IasonKa/drain/drainstop/paper/generated/tab_pump.tex

\begin{tabular}{@{}l r r r r@{}}
\toprule
source capacity & \multicolumn{2}{c}{largest open area that still drains fully (mm$^2$)} & \multicolumn{2}{c}{Eq.~\eqref{eq:cap-area} (mm$^2$)} \\
\cmidrule(lr){2-3}\cmidrule(l){4-5}
 & $\alpha=+10^\circ$ & $\alpha=+15^\circ$ & $+10^\circ$ & $+15^\circ$ \\
\midrule
2 L/min & 5 & 3 & 3 & 2 \\
5 L/min & 9 & 9 & 7 & 6 \\
10 L/min & 19 & 16 & 14 & 11 \\
20 L/min & 42 & 35 & 27 & 23 \\
ideal regulator & 52 & 35 & -- & -- \\
\bottomrule
\end{tabular}
