IasonKa/drain/drainstop/paper/generated/tab_sensitivity.tex

\begin{tabular}{@{}l r r r r r r r r @{}}
\toprule
case & \multicolumn{2}{c}{Recommended} & \multicolumn{2}{c}{USZ as built} & \multicolumn{2}{c}{Side rows} & \multicolumn{2}{c}{Four rows} \\
\cmidrule(lr){2-3}\cmidrule(lr){4-5}\cmidrule(lr){6-7}\cmidrule(lr){8-9}
 & $0^\circ$ & $+10^\circ$ & $0^\circ$ & $+10^\circ$ & $0^\circ$ & $+10^\circ$ & $0^\circ$ & $+10^\circ$ \\
\midrule
baseline & 0.5 & 1.4 & 2.2 & 20.0 & 4.4 & 5.7 & 0.0 & 1.8 \\
capillary 60 deg & 0.5 & 1.4 & 0.0 & 11.8 & 4.4 & 5.7 & 0.0 & 1.8 \\
capillary 0 deg & 0.5 & 1.4 & 0.1 & 3.6 & 4.4 & 5.7 & 0.0 & 1.8 \\
drawdown 0.5 d & 1.0 & 1.9 & 2.2 & 20.0 & 4.9 & 6.2 & 0.5 & 2.3 \\
pump 2 L/min & 0.5 & 14.4 & 2.7 & 23.3 & 4.4 & 18.7 & 2.3 & 18.9 \\
pump 5 L/min & 0.5 & 9.7 & 2.7 & 23.1 & 4.4 & 14.1 & 0.2 & 14.2 \\
water & 0.5 & 1.4 & 2.2 & 19.7 & 4.4 & 5.7 & 0.0 & 1.8 \\
80\% glycerol & 0.5 & 1.4 & 2.2 & 20.1 & 4.4 & 5.7 & 0.0 & 1.8 \\
Cd holes x0.8 & 0.5 & 1.4 & 2.0 & 19.2 & 4.4 & 5.7 & 0.0 & 1.8 \\
Cd port 0.62 & 0.5 & 1.4 & 2.4 & 20.9 & 4.4 & 5.7 & 0.0 & 1.8 \\
-5 mmHg & 0.5 & 1.4 & 2.3 & 20.5 & 4.4 & 5.7 & 0.0 & 1.8 \\
-10 mmHg & 0.5 & 1.4 & 2.0 & 19.3 & 4.4 & 5.7 & 0.0 & 1.8 \\
on the floor & 0.5 & 1.4 & 2.2 & 19.9 & 4.4 & 5.7 & 4.4 & 6.2 \\
\bottomrule
\end{tabular}
