IasonKa/drain/drainstop/paper/drain_stop.pdf

# When does a suction drain stop draining?

Two-phase hydraulics of a partly submerged perforated drain at −7 mmHg,

### and a hole layout that keeps it draining

### USZ drain project, technical note

Analysis, simulations and text prepared with Claude Code (Anthropic)

### 3 November 2026

Abstract

A perforated drain of USZ size (elliptical body 17.85×9.67 mm, 119 mm long, closed tip, Ø4.24 mm outlet bore centred in the end face) lies in a pool of a glycerol–water mixture and is connected to a regulated suction of ps = −7 mmHg (−933 Pa). As the pool empties, some holes come out of the liquid and suck air. We derive when the drainage stops, test hole layouts and sizes, and confirm the results with two independent simulations.
The air entering the exposed holes and the outlet bore act as two orifices in series. They leave a vacuum |ps |/(1+Λ

2
)
inside the drain, where Λ is the exposed open area divided by the bore area, both weighted by their discharge coefficients. Liquid can leave only through the part of the bore below the inner liquid level, so draining stops when

ℎ +

Hv
1 + Λ² (ℎ)

= zℓ

, Hv =

|ps |

ρg

= 84.5 mm,

where ℎ is the pool level and zℓ

the height of the bore’s lower lip. A refined form accounts for air that must enter against the liquid column inside the drain. Across 1127 cases (11 layouts, 8 hole sizes from 0.5 to 4 mm, tilts from −10◦

to +20◦
),
the refined closed form matches a two-phase network simulation with a mean difference of 0.03 mm. A time-dependent simulation reproduces the same stop levels.
The main results are:
(i) The as-built USZ field (468 mm² open, Λ ≈ 24) stops at 2.2 mm when lying flat, but at 20.0 mm when the outlet end is 10◦ up and at 36.9 mm at 20◦
(ii) Hole size matters through the total open area and through how evenly the holes cover the length, not by itself. (iii) Two staggered rows at ±30◦
from the bottom, 36×Ø1.0 mm (28.3 mm² , twice the bore area), drain to the lowest hole edge, i.e. a residual level of 0.5–2.1 mm, from −10◦

to +20◦
, and pass 755 mL/min while submerged.
(iv) The intended source is a wall regulator. The recommendation holds as long as the regulator keeps −7 mmHg while passing 18 L/min of air (12 L/min if the tilt stays within 10◦
). A weaker source needs fewer holes; a sizing rule is given.

## 1 The question

The drain lies in a “lake” of liquid with a viscosity between that of water and glycerol. The suction keeps the outlet tube at −7 mmHg. Fluid enters through side holes and leaves through the outlet. The drain is not always level, and as the lake empties, part of the drain sits in air. Two questions follow:
1. For a given hole layout and hole size, at what pool level does the drain stop removing liquid?
2. Which uniform layout and hole size (0.5 to 4 mm) keeps it draining longest, so that it leaves the least liquid behind? “Stops” means that the liquid flow through the outlet falls below 0.1 mL/min. Section 3 derives the hydraulics and a closed-form stop condition. Section 4 describes the layouts tested. Section 5 describes the two simulations used to confirm the analysis, and Section 6 gives the results. The recommended design is in Section 7.

## 2 Geometry, fluid and operating point

We keep the body of the USZ drain from the project package (USZ_drain_package) and replace its hole field (Fig. 1, Table 1). The body is an elliptic cylinder lying flat, with outer semi-axes a = 8.925 mm (lateral) and b = 4.835 mm (vertical), length L = 119 mm from the closed tip (x = 0) to the outlet end face (x = L), and a 0.6 mm skin. The outlet bore (Ø4.24 mm, area Ap = 14.12 mm²
) is centred in the end face, roughly half its 9.67 mm height. The interior is modelled as one open lumen; the fluted inner wall and core of the as-built part are not modelled (Section 9).
A point on the skin is located by its axial position x and by the angle θ of the parametrisation y = a sin θ, z = b(1−cos θ), with θ = 0 the bottom line (6 o’clock), ±90◦

the side edges and 180◦
the top. Holes are drilled normal to the skin. The drain may be tilted by α about a horizontal lateral axis; α > 0 lifts the outlet end. The pool level ℎ is measured from the lowest point of the skin. The lower edge of the bore, the lip, then sits at
zℓ (α) = (b − r p) cos α + L max(sin α, 0), | zℓ (0) = 2.71 mm, | (1)

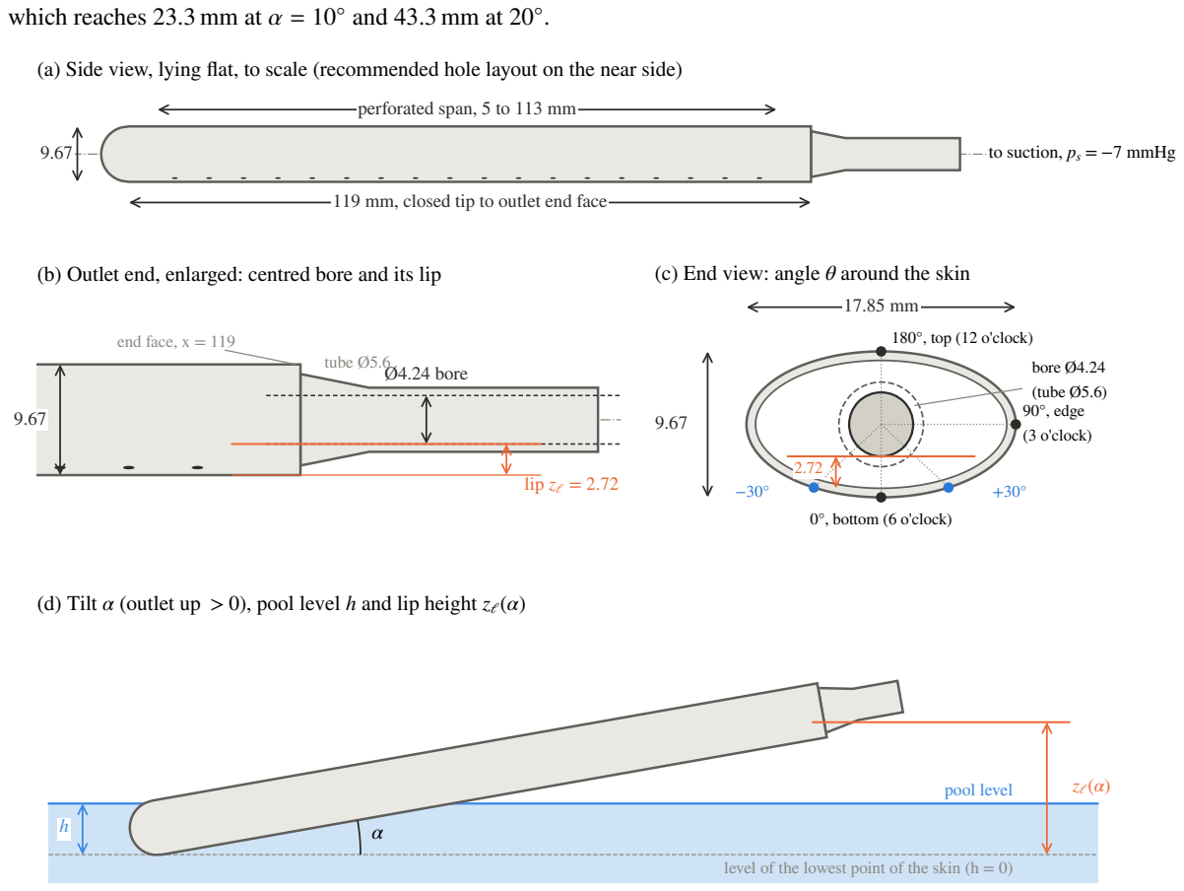
[picture p14: figure]
which reaches 23.3 mm at α = 10◦; and 43.3 mm at 20◦; 119 mm, closed tip to outlet end face; perforated span, 5 to 113 mm; to suction, ps = −7 mmHg; lip zℓ = 2.72; Ø4.24 bore; end face, x = 119; tube Ø5.6; 0°, bottom (6 o'clock); 90°, edge (3 o'clock); 180°, top (12 o'clock); bore Ø4.24 (tube Ø5.6); (c) End view: angle θ around the skin; pool level

### (a) Side view, lying flat, to scale (recommended hole layout on the near side)

### (b) Outlet end, enlarged: centred bore and its lip

level of the lowest point of the skin (h = 0)

### (d) Tilt α (outlet up > 0), pool level h and lip height zℓ(α)

Figure 1: Drain geometry (USZ body). (a) Side view to scale, showing the holes of the recommended layout on the near side. (b) Outlet end: the Ø4.24 mm bore is centred, so its lower lip is zℓ = 2.72 mm above the bottom of the skin. (c) End view and the angle θ that locates holes around the skin; the recommended rows sit at ±30◦
(blue). (d) Tilt α, pool level ℎ and lip height zℓ

(α), Eq. (1).

Table 1: Parameters of the reference case.

quantity | value | note
outer skin | 17.85 × 9.67 mm ellipse, L = 119 mm | USZ body, lying flat
skin thickness t | 0.6 mm | hole length
outlet bore | Ø4.24 mm, Ap = 14.12 mm²
| , centred | lip at zℓ = 2.71 mm
perforated span | x = 5 to 113 mm | as in the USZ part
liquid | 50 wt% glycerol–water, 20 ◦C | ρ = 1126 kg/m³
| | , μ = 6.0 mPa s [7],
| | γ = 0.068 N/m
air | 20 ◦C | ρa = 1.20 kg/m³ , μa = 1.81 × 10−5 Pa s
suction | ps = −7 mmHg = −933 Pa | regulated in the outlet tube
suction head | Hv = |ps |/ρg = 84.5 mm | Eq. (2)
discharge coefficients | hole Cℎ = 0.61 (d ≥ 0.8 mm) to 0.68 (d = 0.5 mm),
| bore Cp = 0.85 | Eqs. (4), (8)
pool footprint | 200 × 80 mm | only for drain times

## 3 Physics

All pressures are gauge pressures; the atmosphere is p = 0.

### 3.1 Suction head

At −7 mmHg the suction can hold up a liquid column of

Hv =

|ps |

ρg

=

933.3
1126 × 9.81
m = 84.5 mm. | (2)

This is about nine times the drain height. Gravity and capillarity are therefore not negligible next to the suction, and they decide when the drain stops.

### 3.2 Flow through one hole

A hole of diameter d through a wall of thickness t resists flow through a viscous term and an inertial term in series:

Δp = Rv q + K q|q|, | Rv = μ

(
24
d

3

+

128 t

πd⁴

)

, K =

ρ
2C

2
ℎ

A²

, A =

πd²
4
. | (3)

The first viscous part is Sampson’s creeping flow through a circular aperture in a thin plate [1]. The second is Hagen– Poiseuille flow along the bore. Their sum approximates the exact finite-length solution well [2]. The inertial part is the orifice law with discharge coefficient Cℎ, which depends on t/d [3]:

Cℎ = 0.61 (t/d ≤ 0.75), | Cℎ rising linearly to 0.81 (t/d ≥ 2). | (4)

For t = 0.6 mm this gives Cℎ = 0.61 for d ≥ 0.8 mm. Solving Eq. (3) for q gives the numerically stable form

q =

2 Δp

Rv +

√

R

2
v + 4KΔp
. | (5)

For the liquid at Δp ≈ 0.5 kPa and d = 1 mm the hole Reynolds number is about 100, and the viscous term lowers the flow by about 12 % relative to the pure orifice law; at d = 0.5 mm it lowers it by about 40 %. For air, μa/μ = 0.003 and the viscous term is negligible. A hole that is partly submerged is split by area into a submerged fraction fs and an exposed fraction fe, each treated as a hole of area f A (that is, Rv/ f and K/ f

2
).

### 3.3 Why an exposed hole leaks air

When the liquid surface drops below a hole, a meniscus forms in it. It can resist the suction behind it only up to the capillary entry pressure

Pc =

4γ cos θe
d

≤

4γ
d
, | (6)

where θe is the effective contact angle (with edge pinning the maximum is 4γ/d [5, 6]). The largest possible value is
544 Pa for d = 0.5 mm, 272 Pa for d = 1 mm and 68 Pa for d = 4 mm. All of these are below |ps | = 933 Pa. A hole seals
against the full suction only if
d < d∗ =

4γ
|ps |
= 0.29 mm, | (7)

even with perfect wetting. Every hole in the 0.5 to 4 mm range therefore lets air in as soon as it is exposed. Once air passes, the hole stays open until it is submerged again. Capillarity plays a role only after the vacuum inside the drain has already dropped, and it is treated as a sensitivity case (θe = 60◦
and 0

◦

; the baseline is θe = 90◦ , no holding).

### 3.4 The outlet bore

The flow contracts from the drain lumen (≈ 110 mm²

) into the bore (14.1 mm²
), an area ratio σ ≈ 0.13. Weisbach’s contraction coefficient Cc = 0.63 + 0.37σ

3 ≈ 0.63 gives a loss coefficient Kc = (1/Cc − 1)

2 ≈ 0.35 [4]. Because ps is the static pressure in the outlet tube, the bore behaves as an orifice with

Cp = (1 + Kc)

−1/2 ≈ 0.85, Qmax = CpAp

√
2|ps |

ρ

= 927 mL/min. | (8)

Qmax is the most liquid that the bore can pass at −7 mmHg. As Section 6 shows, the bore, not the holes, is the main restriction whenever the open hole area exceeds about twice the bore area.

### 3.5 The flow network at one pool level

Inside the drain there is a gas pressure pg and a horizontal inner liquid level ζ; the drain is full of liquid when ζ lies above its top. The pressure on the inner side of a hole at height z is

pin (z) = pg + ρg (ζ − z)

+
, | (9)

where (·)⁺ means max(·, 0). For opening j, with submerged and exposed parts at mean heights z
s
j

and z

e
j

, the network
has the following flows:

liquid in: Δp

L
j = ρg (ℎ − z

s
j

) − pin (z

s
j
), | (10)

air in: Δp

G
j = −pin (z

e
j
) if the opening is open to air, | (11)
liquid out of an exposed hole: Δp = pin (z

e
j
) > 0 if its inner side is wet. | (12)

Each flow follows Eq. (5). An exposed opening becomes open to air when −pin (z

e
j

) > Pc. At the bore, gravity separates the phases (a separated-flow model [8]): liquid leaves through the part of the bore below ζ and gas through the part above it,

AL = Ap F

(
ζ − zc

r p cos α

)

, F(u) =

π − arccos u + u

√
1 − u
2

π

, | AG = Ap − AL, | (13)

qL,b = CpAL

√

2 (pg − ps + ρg (ζ − z¯L))

ρ

, qG,b = CpAG

√

2 (pg − ps)

ρa

, | (14)

where zc is the bore centre and z¯L the centroid of the liquid part. The two unknowns (pg, ζ) follow from conservation of liquid and gas:

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
leak
j = qL,b,

∑

j

q

G
j = qG,b. | (15)

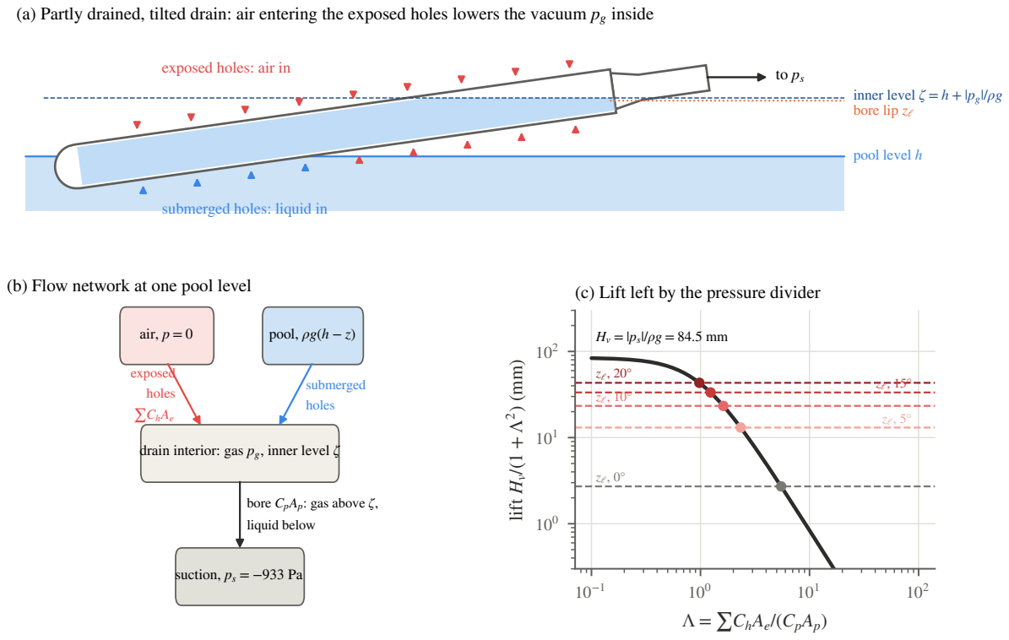
[picture p15: figure]
inner level ζ = h + |pg|/ρg; pool level h; bore lip zℓ; exposed holes: air in; submerged holes: liquid in; air, p = 0; pool, ρg(h − z); drain interior: gas pg, inner level ζ; suction, ps = −933 Pa; exposed holes ∑ChAe; submerged holes; bore CpAp: gas above ζ, liquid below; (b) Flow network at one pool level; Λ = ∑ChAe/(CpAp); lift Hv/(1 +; (c) Lift left by the pressure divider

(a) Partly drained, tilted drain: air entering the exposed holes lowers the vacuum pg inside

Figure 2: Mechanism. (a) Once holes are exposed, air enters through them while liquid still enters through the submerged ones. The liquid inside the drain stands at ζ = ℎ + |pg|/ρg and can leave only through the part of the bore below ζ. (b) The flow network solved at each pool level, Eqs. (10)–(15). (c) The vacuum left inside the drain, expressed as a liquid lift, against the exposed-area ratio Λ. The dashed lines are the lip heights zℓ

(α), and the dots mark the largest Λ that still lifts the liquid to the lip.

### 3.6 The pressure divider

Neglect the liquid column inside the drain and the viscous gas terms. The gas balance in Eq. (15) then involves two orifices in series, the exposed holes and the bore:
∑

j

Cℎ, j A

e
j

√
2(−pg)

ρa

= CpAp

√

2(pg − ps)

ρa

=⇒ −pg =

|ps |
1 + Λ²

, Λ =

∑

j Cℎ, j A

e
j
CpAp

The gas density and the size of the air flow both drop out, so the vacuum left inside depends only on the area ratio Λ. With Λ = 1, half the suction remains. The as-built USZ field reaches Λ ≈ 12 as soon as its top face is exposed, which leaves 0.7 % of the suction, or 0.6 mm of lift.

### 3.7 Lift, and the stop condition

Liquid can leave only if the inner level reaches the bore lip, ζ ≥ zℓ . When no liquid flows, the pressure balance across a submerged hole is ρg(ℎ − z) = pg + ρg(ζ − z), so the vacuum lifts the inner liquid to

ζ = ℎ +

|pg |

ρg

| . | (16)

Drainage is therefore possible only while ℎ + |pg |/ρg > zℓ . Combined with the pressure divider, the drain stops at the level ℎs that satisfies

ℎs +

Hv
1 + Λ(ℎs)
2
= zℓ | (simple bound). | (17)

This bound treats every exposed hole as if air entered it at the full inner vacuum. An exposed hole that lies below the inner level (z < ζ) admits air only by pushing against the liquid column ρg(ζ − z). At the threshold, where ζ = zℓ and −pg = ρg(zℓ − ℎ), the air entering an exposed element at height z is driven by ρg(min(z, zℓ ) − ℎ) instead of ρg(zℓ − ℎ). Weighting each exposed element by w = (min(z, zℓ ) − ℎ)/(zℓ − ℎ) gives the refined stop condition

ℎs +

Hv
1 + Λw (ℎs)
2

= zℓ , Λw (ℎ) =

1
CpAp

∑

exposed

Cℎ δA √
w | Λw ≤ Λ. | (18)

The left side increases with ℎ, because Λw never increases as ℎ rises, so the root is unique. Drainage also needs liquid that can reach a hole, so it stops at the latest when the pool falls below the lowest edge of the lowest hole, ℎgeo. Overall, ℎs = max(ℎgeo, root of Eq. (18)). Three consequences follow:
1. While ℎ > zℓ , no lift is needed: liquid reaches the bore whatever the vacuum, so the drain keeps draining. Every drain therefore empties the pool at least down to the lip, ℎs < zℓ , which is 2.7 mm for a drain lying flat.
2. With the outlet up, the lip rises by L sin α, and the vacuum has to lift the liquid much further.
3. The drain empties the pool down to its lowest hole only if

Λw (ℎgeo) < Λ

∗ =

√

Hv
zℓ (α) − ℎgeo
− 1. | (19)

Taking ℎgeo = 0 gives Λ

∗ = 5.5 at 0

◦
, 2.3 at 5

◦

, 1.6 at 10◦

and 1.0 at 20◦

. Beyond α ≈ 44◦ | the lip is higher than Hv,
and no layout can empty the pool below zℓ − Hv.

### 3.8 A suction source with limited capacity

A real pump or regulator holds ps only up to some volume flow Qs. Once the air drawn through the exposed holes
exceeds Qs, the source is saturated, and the vacuum inside follows from the holes alone, |pg | ≈ (ρa/2) (Qs/

∑
| CℎA e
)
| 2 .
Full drainage then additionally requires
∑

CℎA

e <

Qs

√

2ρg (zℓ − ℎgeo)/ρa

. | (20)

For example, at α = 10◦
a 5 L/min source can feed only about 7 mm² of exposed hole area at the vacuum that the lift requires.

### 3.9 Draining in time

The pool level falls as dℎ/dt = −QL (ℎ)/Af s (ℎ), where QL is the net liquid inflow to the drain and Af s is the pool’s free-surface area (pool footprint minus the drain’s footprint at that level). Because the drain interior settles within seconds, much faster than the pool, QL (ℎ) can be taken from the steady network at each level (Section 5). Air entrainment by surface drawdown above an active hole (critical submergence [9]) is included as a sensitivity case: a hole is counted as exposed once the surface is within κd of it, with κ = 0.5.

## 4 Hole distributions tested

Ten uniform layouts (A to J) plus the as-built USZ field were tested (Figs. 3, 5). In every layout the holes are equally spaced along x within each row. The layouts differ in the number of rows, their angles θ and their axial alignment (in line, staggered by half a pitch, or helical):
A side rows (3 and 9 o’clock); B top and bottom; C four rows in line; D helix over the same four positions; E eight rows evenly around the skin; F both faces at ±45◦

and ±135◦
; G lower band (0

◦

, ±45◦

); H lower flanks ±45◦
in line; I the
same staggered; J one bottom row. The recommended layout (two staggered rows at ±30◦
) came out of the optimisation in Section 6.3.
Each layout was built with eight hole diameters, d = 0.5 to 4.0 mm in 0.5 mm steps, in two families (Fig. 4): Fixed count: 19 holes per row (pitch 5.7 mm), so the open area grows as d

2
Fixed area: the number of holes is chosen so that the total open area is about 2Ap = 28 mm² , so larger holes mean fewer holes.
Tilts of −10◦

to +20◦
in 5

◦
steps give 1127 cases.

## 5 Simulations used to confirm the analysis

The closed form was checked against two numerical models that drop its simplifications. A three-dimensional two-phase CFD check (volume of fluid) is set up as well (Section 8), but its results are not yet available.

Quasi-static two-phase network. Each opening is split into 61 equal-area elements (a Vogel spiral on the developed skin), mapped to their true height for the tilt. At each pool level the solver finds the submerged and exposed fractions of every opening and solves Eqs. (10)–(15). It includes:
- viscous and inertial losses in every opening;
- hydrostatics inside the drain, and liquid dripping out of exposed holes;
- gas and liquid sharing the bore;
- the capillary breakthrough state of each opening, which persists until the opening is submerged again;
- optionally, a source with limited capacity.
The two unknowns are found by nested monotone root finding (Illinois false position): pg from the gas balance for a given ζ, and ζ from the liquid balance. If the liquid balance is negative even with ζ at the lip, the drain is stalled. The pool is lowered in 0.1 mm steps, and the stop level is then refined by bisection to 0.01 mm. Drain times come from integrating dt = Af s dℎ/QL.

Time-dependent simulation. This model does not assume a steady interior. The liquid stored inside the drain, VL, is a state variable:

dVL

dt

= QL,in − Qleak − qL,b,

dℎ

dt

= −

QL,in − Qleak

Af s

, | 0 = QL,in + QG,in − Qleak − qL,b − qG,b. | (21)

The last equation states that the rigid drain conserves volume, and it fixes pg at every instant (gas compressibility acts on microsecond scales at 1 % pressure changes). The inner level ζ follows from VL through the interior geometry. VL is advanced with backward Euler, which is stable for the stiff bore, and ℎ explicitly with steps of at most 0.05 mm. Openings break through and reseal as in the network model. The run ends once no liquid has left the drain for two minutes.

Agreement. Over all 1127 sweep cases, the refined closed form, Eq. (18), matches the network simulation with a mean absolute difference of 0.03 mm and a maximum of 1.27 mm (Fig. 6). The simple bound, Eq. (17), is conservative: it overestimates the stop level by up to 9.4 mm at outlet-up tilts. The time-dependent simulation ends at the same levels to within 0.02 mm (Table 2); Fig. 7 shows its time histories.

USZ as built: 318 × Ø1.0 through both faces | A Side rows, 3 and 9 o'clock
B Top and bottom rows | C Four rows in line

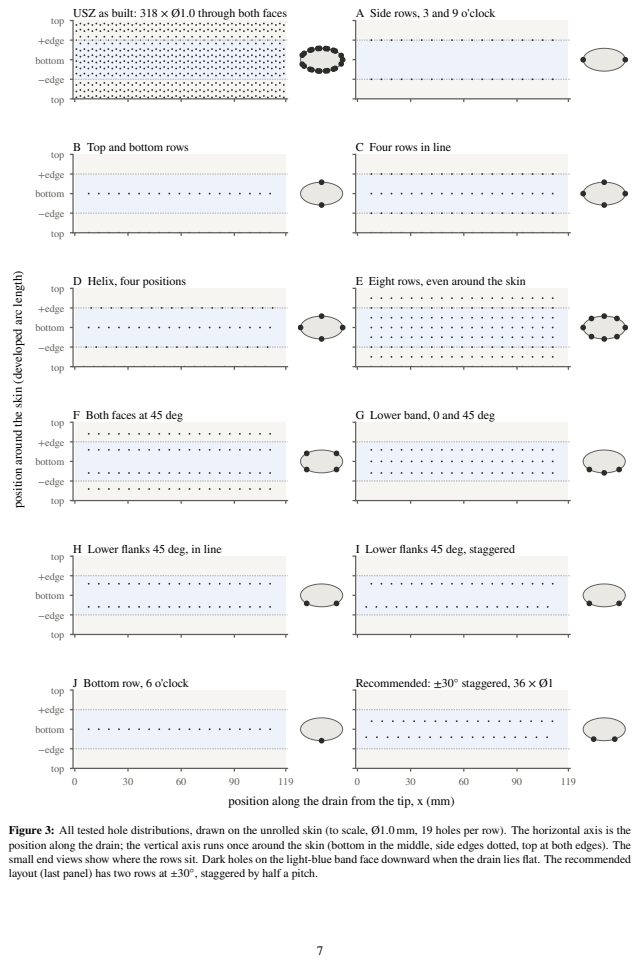
[picture p16: page 7]
top; −edge; bottom; +edge; D Helix, four positions; E Eight rows, even around the skin; F Both faces at 45 deg; G Lower band, 0 and 45 deg; H Lower flanks 45 deg, in line; I Lower flanks 45 deg, staggered; J Bottom row, 6 o'clock; Recommended: ±30° staggered, 36 × Ø1

position around the skin (developed arc length)
top
+edge
bottom
−edge

position along the drain from the tip, x (mm)

Figure 3: All tested hole distributions, drawn on the unrolled skin (to scale, Ø1.0 mm, 19 holes per row). The horizontal axis is the
position along the drain; the vertical axis runs once around the skin (bottom in the middle, side edges dotted, top at both edges). The
small end views show where the rows sit. Dark holes on the light-blue band face downward when the drain lies flat. The recommended
layout (last panel) has two rows at ±30◦

, staggered by half a pitch.

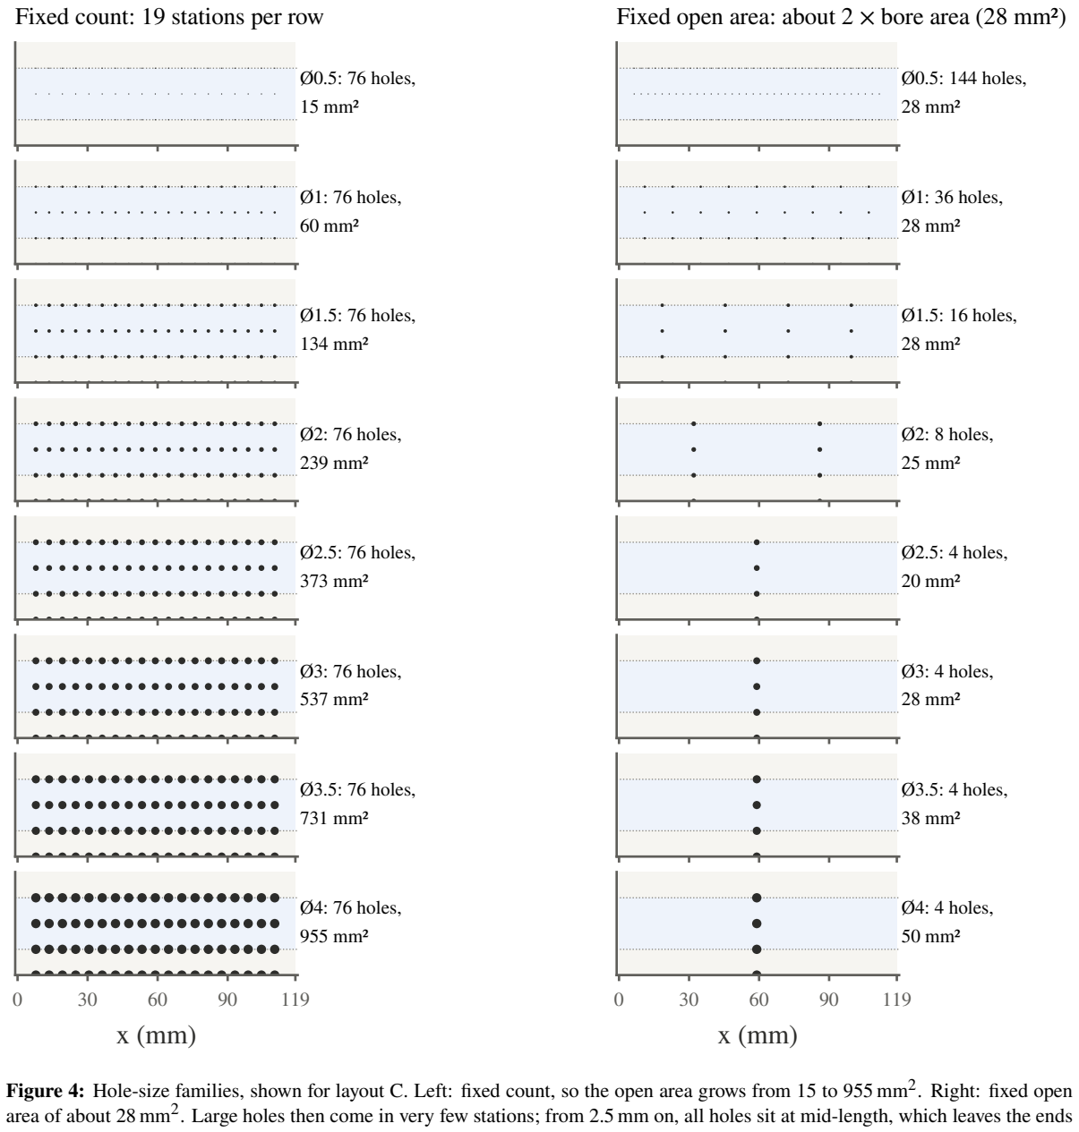
[picture p17: figure]
Ø0.5: 76 holes, 15 mm²; Fixed count: 19 stations per row; Ø0.5: 144 holes, 28 mm²; Ø1: 76 holes, 60 mm²; Ø1: 36 holes, 28 mm²; Ø1.5: 76 holes, 134 mm²; Ø1.5: 16 holes, 28 mm²; Ø2: 76 holes, 239 mm²; Ø2: 8 holes, 25 mm²; Ø2.5: 76 holes, 373 mm²; Ø2.5: 4 holes, 20 mm²; Ø3: 76 holes, 537 mm²; Ø3: 4 holes, 28 mm²; Ø3.5: 76 holes, 731 mm²; Ø3.5: 4 holes, 38 mm²; Ø4: 76 holes, 955 mm²; Ø4: 4 holes, 50 mm²; . Right: fixed open; area of about 28 mm²

## Fixed open area: about 2 × bore area (28 mm²)

Figure 4: Hole-size families, shown for layout C. Left: fixed count, so the open area grows from 15 to 955 mm² . Large holes then come in very few stations; from 2.5 mm on, all holes sit at mid-length, which leaves the ends of the drain without holes.

Table 2: Stop level ℎs (mm above the lowest point of the skin) from the three methods, for four designs. “Four rows” and “side rows” are the fixed-area (28 mm²
) versions.
design | α | closed form | network | time-dependent | lowest hole edge
| | Eq. (18) | (quasi-static) | simulation | ℎgeo
Recommended | 0
| ◦ | 0.51 | 0.52 | 0.51 | 0.53
Recommended | 10◦ | 1.35 | 1.36 | 1.36 | 1.37
USZ as built | 0
| ◦ | 2.29 | 2.21 | 2.21 | 0.01
USZ as built | 10◦ | 20.13 | 19.97 | 19.97 | 0.11
Side rows | 0
| ◦ | 4.35 | 4.37 | 4.36 | 4.37
Side rows | 10◦ | 5.67 | 5.67 | 5.67 | 5.69
Four rows | 0
| ◦ | 0.00 | 0.00 | 0.00 | 0.01
Four rows | 10◦ | 1.81 | 1.83 | 1.82 | 1.83

USZ as built: 609 openings, 468 mm² | Side rows: 36 openings, 28 mm²
Four rows: 36 openings, 28 mm² | Recommended: 36 openings, 28 mm²

Figure 5: 3D views (from below and in front, outlet tube on the right) of the as-built USZ field, side rows, four rows and the recommended layout.

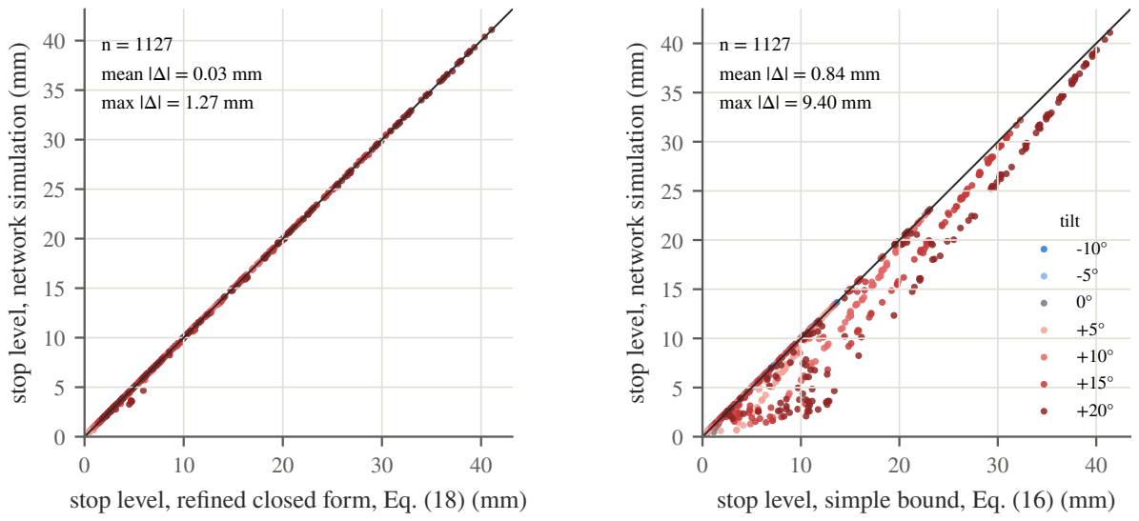
[picture p18: figure]
stop level, network simulation (mm); n = 1127 mean |Δ| = 0.03 mm max |Δ| = 1.27 mm; stop level, simple bound, Eq. (16) (mm); n = 1127 mean |Δ| = 0.84 mm max |Δ| = 9.40 mm; tilt -10° -5° 0° +5° +10° +15° +20°

## stop level, refined closed form, Eq. (18) (mm)

Figure 6: Stop level from the network simulation against the closed forms, for all 1127 cases (colour gives the tilt). Left: refined condition, Eq. (18). Right: simple bound, Eq. (17), which is conservative when air must enter against liquid standing inside a tilted drain.

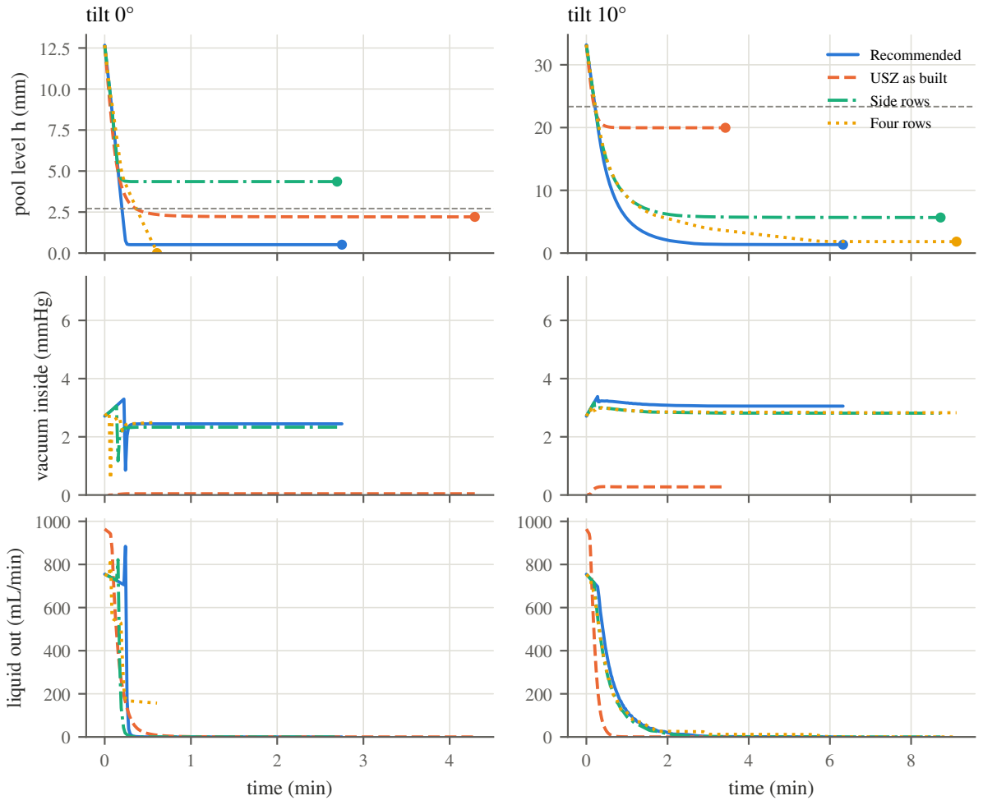
[picture p19: figure]
pool level h (mm); tilt 0°; tilt 10°; Recommended USZ as built Side rows Four rows; vacuum inside (mmHg); time (min); liquid out (mL/min)

Figure 7: Time-dependent simulation (pool 200 × 80 mm, starting 3 mm above the drain): pool level, vacuum inside the drain and liquid leaving through the bore. The dots mark where the drainage has stopped.

## 6 Results

### 6.1 How the drainage stops

Figure 9 follows five designs as the pool falls. While all holes are submerged, the drains pass 720 to 970 mL/min, close to the bore limit Qmax = 927 mL/min. The vacuum at the bore end of the interior is only about 2.4 mmHg; the bore itself takes the rest of the 7 mmHg. With the large USZ field, the interior even sits slightly above atmospheric pressure, because all the suction acts across the bore.
As soon as the upper holes of the USZ field are exposed, the interior vacuum collapses (Λ ≫ 1). The drain then keeps emptying only while the pool is above the lip, which is 2.7 mm when flat and 23.3 mm at 10◦
, and it stops just below. A layout with little open area keeps 2 to 3 mmHg inside and drains on until its lowest holes are uncovered. Side rows stop at about mid-height (4.4 mm when flat): this is a geometric stop, because nothing lower can take in liquid.
Figure 8 draws the state that the network simulation computes, for both designs at 10◦
, with every opening coloured by what flows through it.
- USZ at its stop (29 s). About 28 L/min of air pours in through the exposed openings, and the vacuum inside falls to 37 Pa. That vacuum still holds the liquid in the drain 3.4 mm above the pool, but only up to the bore lip, so the submerged openings stop flowing.
- Recommended layout at the same moment. It keeps −432 Pa inside and drains 397 mL/min, with air entering only through the few exposed openings near the outlet.
- Recommended layout at the end (153 s). It stops when its lowest openings leave the pool, at 1.4 mm.
An animation of the whole drainage is in pictures/drain_emptying_tilt10.gif.


Figure 8: State of the network simulation while the pool empties, outlet end 10◦ up, each drain in its own identical pool. Top: the moment the USZ part stops (20.0 mm). Bottom: the recommended part has drained to its lowest openings (1.4 mm). Each panel shows three views. Left: a cut through the drain axis with the pool, the liquid and air inside the drain, and the near-side openings, coloured blue for liquid in, orange for air in and grey for no flow. Right: a 3D view from below. Bottom: the pool level against time. These are states of the reduced-order model, not CFD fields.

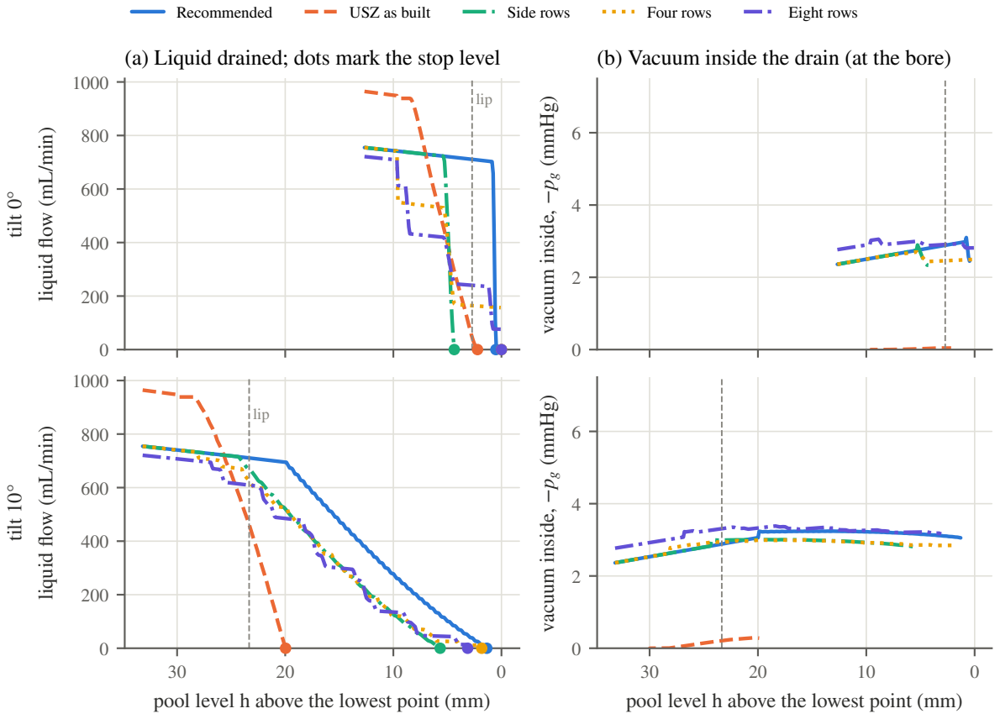
[picture p20: figure]
tilt 0°; liquid flow (mL/min); lip; vacuum inside, −pg (m; tilt 10°; Recommended; USZ as built; Side rows; Four rows; Eight rows

## (a) Liquid drained; dots mark the stop level

## (b) Vacuum inside the drain (at the bore)

## pool level h above the lowest point (mm)

## pool level h above the lowest point (mm)

Figure 9: Quasi-static drainage of five designs, read from right to left as the pool falls. (a) Liquid drained; the dots mark the stop level.
(b) Vacuum inside the drain at the bore. The dashed line is the lip height zℓ

(α). Top row: flat; bottom row: outlet 10◦ up.

### 6.2 Effect of layout, hole size and tilt

Table 3 and Figs. 10–12 give the stop level of every case. The main findings:
- The as-built USZ field drains well only when flat, stopping at 2.2 mm just below the lip. Any outlet-up tilt leaves a deep pool (20.0 mm at 10◦
), because its 468 mm² of openings give Λ ≈ 24.
- Total open area is the main design variable. With a fixed count (open area ∝ d

2
), the layouts that tolerate tilt with small holes fail with the outlet up once d exceeds about 1 to 2 mm, when the open area passes roughly 60 to 130 mm² (Fig. 10). With a fixed area of 28 mm²
, every layout stops below about 7 mm at all tilts, and the side rows are the worst when flat (Table 3).
- Placement around the skin sets the geometric limit. Holes at mid-height or above (A, and the upper parts of E and
F) cannot remove the last millimetres, while holes on the lower half can.
- Placement along the length matters under tilt. The lowest point is the tip when the outlet is up and the outlet end when it is down, so holes must reach both ends. With a fixed area, large holes come in so few stations that the ends stay uncovered (Fig. 11, Table 4). Staggering two rows halves the effective axial pitch, which is why layout I beats H at positive tilt.

### 6.3 Optimising the layout

Two staggered rows were then mapped over hole size (0.5 to 4 mm) and number of holes (Fig. 13). Flow when submerged rises with open area and reaches 80 % of Qmax at about 2Ap (Fig. 13a, Fig. 14b). The worst stop level over −10◦

to +15◦
has a broad minimum between about 15 and 40 mm²
(Fig. 13b):
- With less area there are too few holes to reach the ends.
- With more area, Λw exceeds Λ

∗
(Eq. (19)), and the lift fails at outlet-up tilts. The rows should sit as low as practical (Fig. 13c): every 15◦
lower takes 0.5 to 1 mm off the residual level. However, rows below about ±20◦ press against a floor or against tissue (when lying on a hard floor, the holes at ±15◦ lose 70 % of their
flow). We therefore chose ±30◦
, roughly 5 and 7 o’clock. At a fixed area of 28 mm² (Table 4), holes of 1.0 to 1.5 mm give the best balance:
- 0.5 mm holes lose flow to viscosity and clog easily.

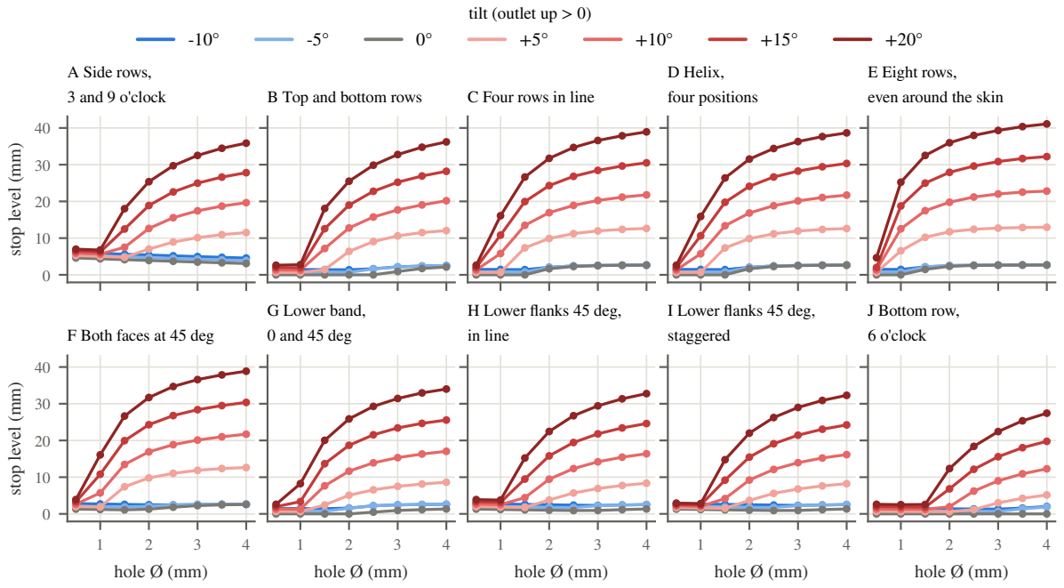
[picture p21: figure]
stop level (mm); A Side rows,; 3 and 9 o'clock; B Top and bottom rows; C Four rows in line; D Helix, four positions; E Eight rows, even around the skin; hole Ø (mm); F Both faces at 45 deg; G Lower band, 0 and 45 deg; H Lower flanks 45 deg, in line; I Lower flanks 45 deg, staggered; J Bottom row, 6 o'clock; tilt (outlet up > 0)

Figure 10: Stop level against hole diameter, fixed-count family (19 holes per row). Colour gives the tilt: blue for outlet down, grey for flat, red for outlet up.

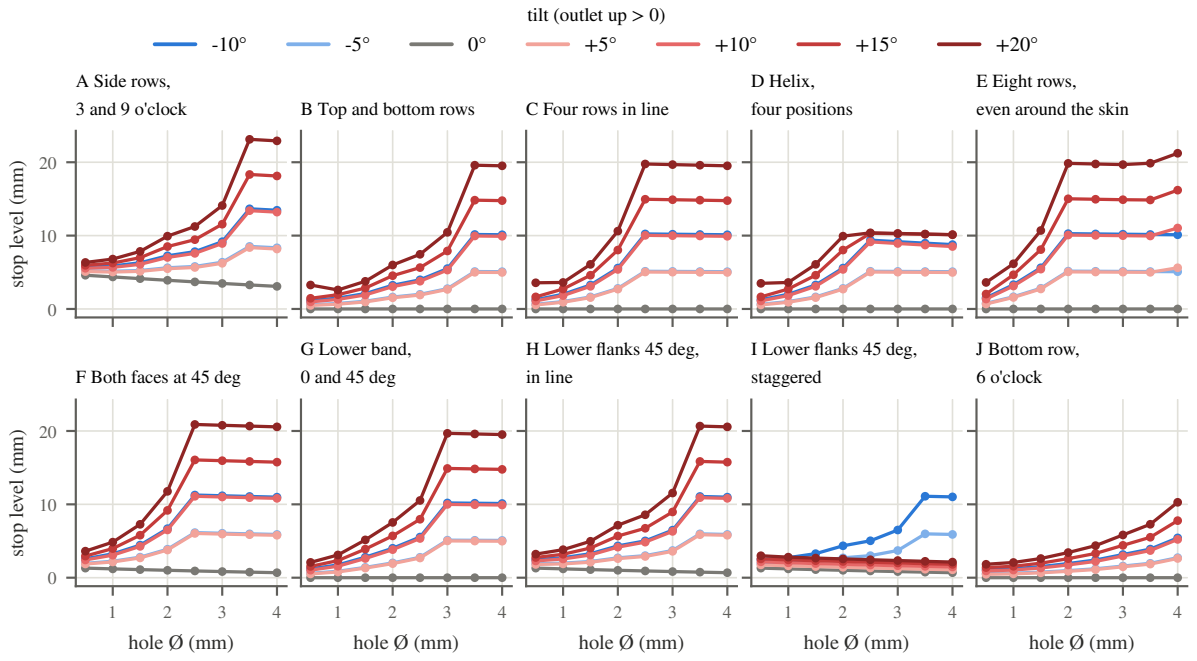
[picture p22: figure]
stop level (mm); A Side rows,; 3 and 9 o'clock; B Top and bottom rows; C Four rows in line; D Helix, four positions; E Eight rows, even around the skin; hole Ø (mm); F Both faces at 45 deg; G Lower band, 0 and 45 deg; H Lower flanks 45 deg, in line; I Lower flanks 45 deg, staggered; J Bottom row, 6 o'clock; tilt (outlet up > 0)

Figure 11: Stop level against hole diameter, fixed-area family (about 28 mm² ). Larger holes mean fewer stations; above about 2.5 mm the holes no longer reach the ends of the drain.

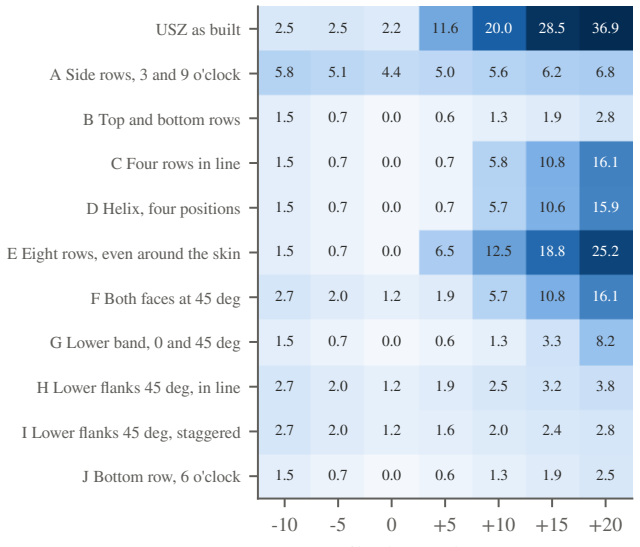
[picture p23: figure]
USZ as built; A Side rows, 3 and 9 o'clock; B Top and bottom rows; C Four rows in line; D Helix, four positions; E Eight rows, even around the skin; F Both faces at 45 deg; G Lower band, 0 and 45 deg; H Lower flanks 45 deg, in line; I Lower flanks 45 deg, staggered; J Bottom row, 6 o'clock

## tilt (deg, outlet up > 0)

## (a) Ø1.0, 19 holes per row

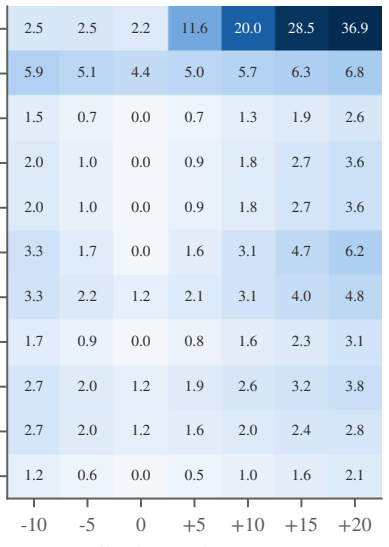
[picture p24: figure]

## tilt (deg, outlet up > 0)

## (b) Ø1.0, open area 28 mm²

0

5

10

15

20

25

30

stop level h (mm above lowest point)

Figure 12: Stop level (mm) for every layout with Ø1.0 mm holes and tilts from −10◦

to +20◦
. (a) 19 holes per row. (b) Open area of about 28 mm²

Table 3: Stop level ℎs (mm) of all layouts with Ø1.0 mm holes at about 28 mm² open area (USZ as built), from the network simulation. Q0 is the flow with the pool 3 mm above the drain.

stop level ℎs (mm) at tilt α
layout | A (mm²

) Q0 (mL/min) −10◦ −5

- 0
- +5
- +10◦ +15◦ +20◦
USZ as built (318 × Ø1.0) | 468 | 965 | 2.5 | 2.5 2.2 11.6 | 20.0 | 28.5 | 36.9
A Side rows, 3 and 9 o’clock | 28 | 755 | 5.9 | 5.1 4.4 | 5.0 | 5.7 | 6.3 | 6.8
B Top and bottom rows | 28 | 755 | 1.5 | 0.7 0.0 | 0.7 | 1.3 | 1.9 | 2.6
C Four rows in line | 28 | 755 | 2.0 | 1.0 0.0 | 0.9 | 1.8 | 2.7 | 3.6
D Helix, four positions | 28 | 755 | 2.0 | 1.0 0.0 | 0.9 | 1.8 | 2.7 | 3.6
E Eight rows, even around the skin | 25 | 721 | 3.3 | 1.7 0.0 | 1.6 | 3.1 | 4.7 | 6.2
F Both faces at 45◦ | 28 | 755 | 3.3 | 2.2 1.2 | 2.1 | 3.1 | 4.0 | 4.8
G Lower band, 0 and 45◦ | 28 | 755 | 1.7 | 0.9 0.0 | 0.8 | 1.6 | 2.3 | 3.1
H Lower flanks 45◦
, in line | 28 | 755 | 2.7 | 2.0 1.2 | 1.9 | 2.6 | 3.2 | 3.8
I Lower flanks 45◦
, staggered | 28 | 755 | 2.7 | 2.0 1.2 | 1.6 | 2.0 | 2.4 | 2.8
J Bottom row, 6 o’clock | 28 | 755 | 1.2 | 0.6 0.0 | 0.5 | 1.0 | 1.6 | 2.1
Recommended, ±30◦
staggered | 28 | 755 | 2.0 | 1.3 0.5 | 0.9 | 1.4 | 1.8 | 2.1
- 2 to 4 mm holes come in too few stations and leave the outlet end uncovered when it is lowest.

Table 4: Recommended layout (two staggered rows at ±30◦
) at about 28 mm²
for each hole size: stop level ℎs (mm).
Ø (mm) | holes | A (mm²
) | Q0 (mL/min) | −10◦ −5
- 0
- +5
- +10◦ +15◦ +20◦
0.5 | 144 | 28 | 699 | 1.7 | 1.2 | 0.6 | 1.0 | 1.4 | 1.9 | 2.3
1 | 36 | 28 | 755 | 2.0 | 1.3 | 0.5 | 0.9 | 1.4 | 1.8 | 2.1
1.5 | 16 | 28 | 773 | 2.6 | 1.6 | 0.5 | 0.9 | 1.3 | 1.7 | 2.0
2 | 8 | 25 | 747 | 3.7 | 2.1 | 0.4 | 0.8 | 1.2 | 1.6 | 1.9
2.5 | 6 | 29 | 794 | 4.4 | 2.4 | 0.3 | 0.8 | 1.2 | 1.5 | 1.8
3 | 4 | 28 | 786 | 5.9 | 3.2 | 0.3 | 0.7 | 1.1 | 1.4 | 1.7
3.5 | 2 | 19 | 670 | 10.6 | 5.5 | 0.3 | 0.7 | 1.0 | 1.4 | 1.6
4 | 2 | 25 | 756 | 10.5 | 5.4 | 0.2 | 0.6 | 1.0 | 1.3 | 1.5

### 6.4 How far can the drain be tilted?

Figure 15 extends the tilt to 40◦
. With the outlet down, all layouts stop within about 3 mm of the bottom (side rows excepted). With the outlet up, the recommended design drains to its lowest hole edge up to α = 22.5

◦
. Beyond that, zℓ

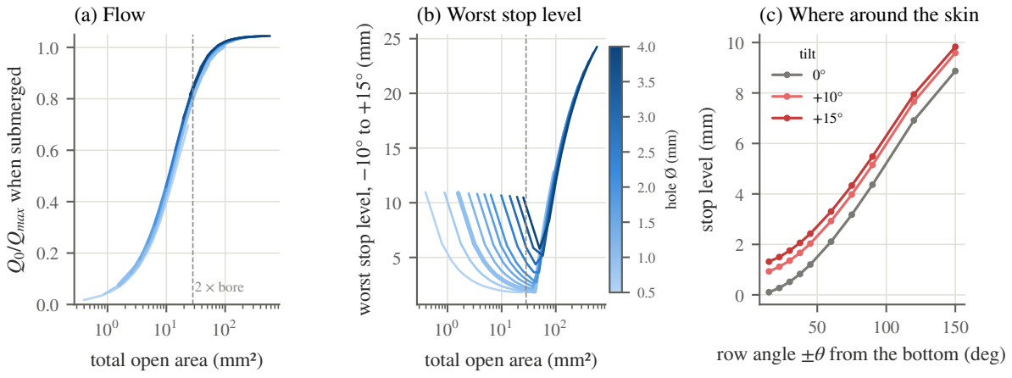
[picture p25: figure]
2 total open area (mm²); Q0/Qmax when submerged; 2 × bore; (a) Flow; worst stop level,; (b) Worst stop level; row angle ±θ from the bottom (deg); stop level (mm); (c) Where around the skin; tilt 0° +10° +15°; hole Ø (mm)

Figure 13: Optimisation of two staggered rows at ±30◦
. Each line is one hole size, with the number of holes varied along it. (a) Flow when submerged as a fraction of the bore limit. (b) Worst stop level over −10◦

to +15◦
(closed form). The ring marks the recommended design, and the dashed line is twice the bore area. (c) Effect of the row angle ±θ (Ø1.0 mm, 28 holes).

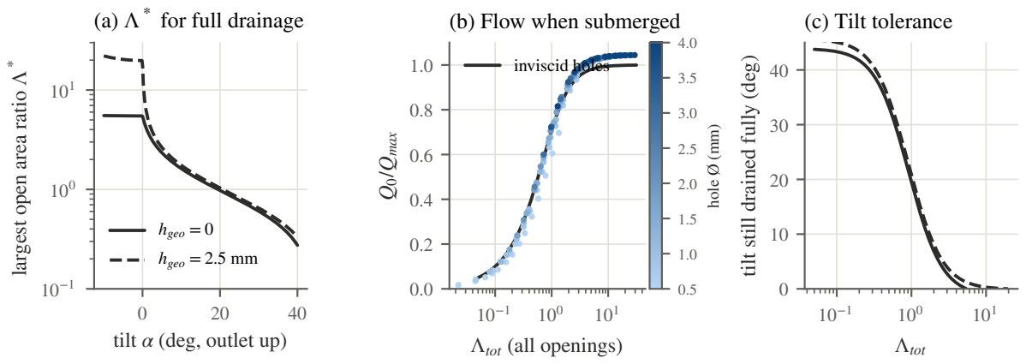
[picture p26: figure]
tilt α (deg, outlet up); largest open area ratio Λ; for full drainage; hgeo = 0 hgeo = 2.5 mm; 1 Λtot (all openings); Q0/Qmax; (b) Flow when submerged; inviscid holes; Λtot; tilt still drained fully (deg); (c) Tilt tolerance; hole Ø (mm)

Figure 14: Closed-form design charts. (a) Largest exposed-area ratio that still drains to the lowest hole, Eq. (19). (b) Flow when submerged against total area ratio (line: inviscid holes in series with the bore; dots: network results, coloured by hole size). (c) Largest outlet-up tilt that still drains fully, if all holes are exposed at the end.

grows faster than the vacuum can lift, and the stop level rises by about 1 mm per degree. The as-built USZ field fails from the first degree of outlet-up tilt.

### 6.5 When the source has limited capacity

The results so far assume a regulator that holds −7 mmHg whatever the air flow. Once the recommended drain is fully exposed it draws about 19 to 23 L/min of air, and the USZ field about 28 L/min. For the recommended layout, the smallest source capacity that still drains to the lowest hole is 9, 12, 15 and 18 L/min at +5

◦

, +10◦

, +15◦

and +20◦
. This is the
free-air flow a wall regulator must pass while holding −7 mmHg. If the source moves less than that, its vacuum collapses while holes are exposed, and with the outlet up the drain stops early (Fig. 16, Table 5). Equation (20) gives a conservative estimate of the allowed open area. A 10 L/min source allows about 16 to 19 mm²

, and a 5 L/min source about 9 mm² . A
layout fitted to the source capacity drains to the bottom again; when lying flat (zℓ = 2.7 mm) the source capacity makes no difference.

### 6.6 Sensitivity and robustness

Table 6 and Fig. 17 vary one assumption at a time:
- Liquid and suction level. Viscosity (water to 80 % glycerol), suction (−5 to −10 mmHg) and the discharge coefficients change the flow rates but hardly the stop levels, because the stop is set by gas flow and hydrostatics.
- Capillary holding. It does not change the recommended design, which already drains fully, but it would help the as-built USZ field a lot (20 down to 3.6 mm at 10◦ with perfect wetting), because many small wetted holes can hold back air once the vacuum has dropped. The tube material and surface state matter here.

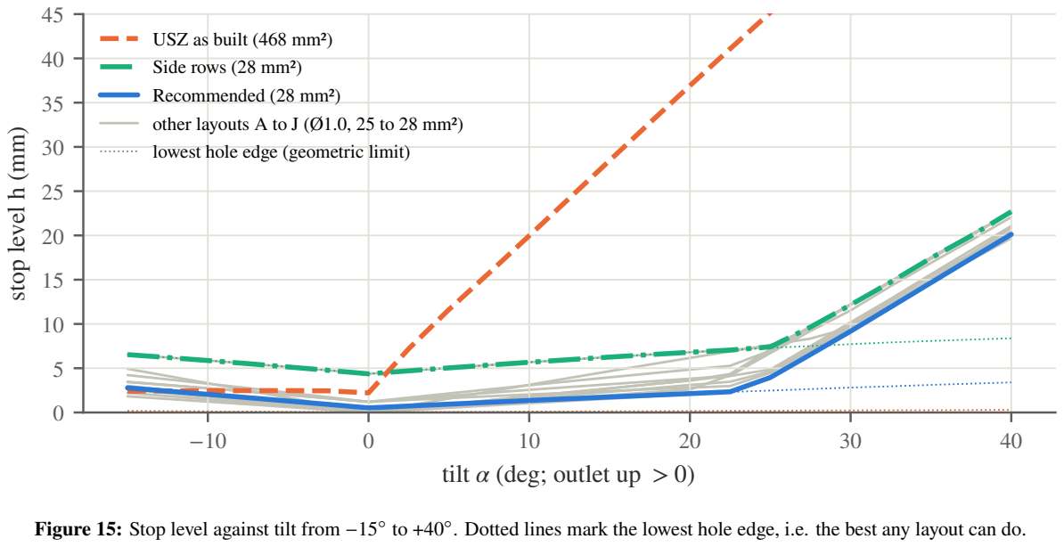
[picture p27: figure]
tilt α (deg; outlet up > 0); stop level h (mm); USZ as built (468 mm²) Side rows (28 mm²) Recommended (28 mm²); lowest hole edge (geometric limit)

### other layouts A to J (Ø1.0, 25 to 28 mm²)

Figure 15: Stop level against tilt from −15◦ . Dotted lines mark the lowest hole edge, i.e. the best any layout can do.

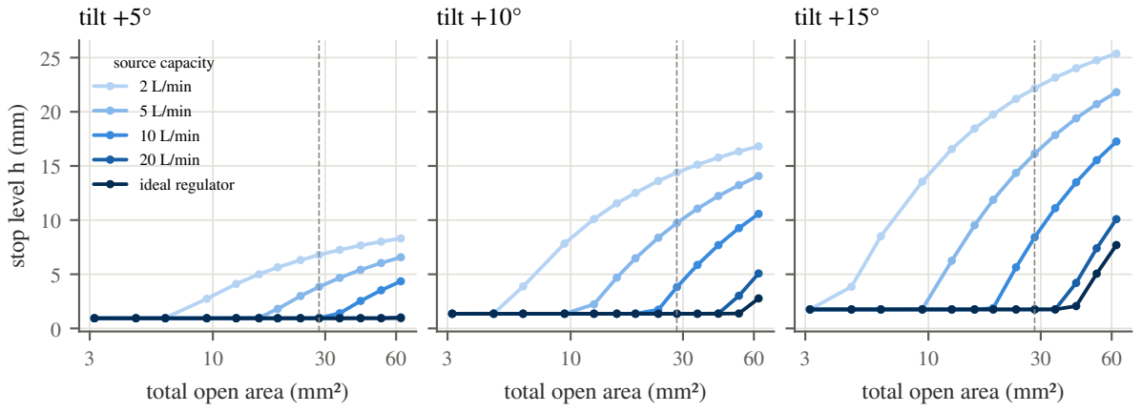
[picture p28: figure]
total open area (mm²); stop level h (mm); tilt +5°; source capacity 2 L/min 5 L/min 10 L/min 20 L/min ideal regulator; tilt +10°; tilt +15°

Figure 16: Stop level against total open area (recommended layout, Ø1.0 mm) for sources of limited flow capacity. The dashed line is twice the bore area.

Table 5: Largest total open area (recommended layout, Ø1.0 mm) that still drains to the lowest hole, against source capacity: network simulation and the conservative estimate of Eq. (20).

source capacity | largest open area that still drains fully (mm²
| | ) | Eq. (20) (mm² | )
α = +10◦ | α = +15◦ +10◦ | +15◦
2 L/min | 5 | 3 | 3 | 2
5 L/min | 9 | 9 | 7 | 6
10 L/min | 19 | 16 | 14 | 11
20 L/min | 42 | 35 | 27 | 23
ideal regulator | 52 | 35 | – | –

- Drawdown. Surface drawdown above active holes adds about half a hole diameter to every stop level.
- Lying on a floor. This blocks the bottom row of layout C, which then stops at mid-height (layout J would be blocked entirely). The recommended rows at ±30◦
are not affected.
In a Monte Carlo study (200 random combinations of tilt from −10◦

to +15◦
, suction, liquid, discharge coefficients, contact angle and drawdown; Fig. 18), the recommended design had a median stop level of 1.6 mm and a 95th percentile of 2.2 mm. For the as-built USZ field these were 4.8 mm and 24.6 mm.

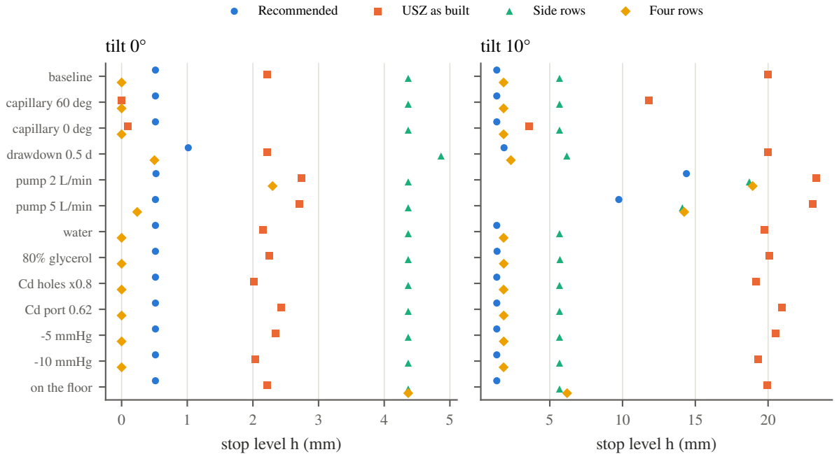
[picture p29: figure]
stop level h (mm); baseline capillary 60 deg capillary 0 deg drawdown 0.5 d pump 2 L/min pump 5 L/min water 80% glycerol Cd holes x0.8 Cd port 0.62 -5 mmHg -10 mmHg on the floor; tilt 0°; tilt 10°; Recommended; USZ as built; Side rows; Four rows

Figure 17: One-at-a-time sensitivity of the stop level, flat (left) and outlet 10◦ up (right).

Table 6: Sensitivity: stop level ℎs (mm) at 0

◦

and +10◦
case | Recommended USZ as built Side rows Four rows

0

- +10◦ 0
- +10◦ 0
- +10◦ 0
- +10◦
baseline | 0.5 | 1.4 2.2 | 20.0 4.4 | 5.7 0.0 | 1.8
capillary 60 deg 0.5 | 1.4 0.0 | 11.8 4.4 | 5.7 0.0 | 1.8
capillary 0 deg | 0.5 | 1.4 0.1 | 3.6 4.4 | 5.7 0.0 | 1.8
drawdown 0.5 d 1.0 | 1.9 2.2 | 20.0 4.9 | 6.2 0.5 | 2.3
pump 2 L/min | 0.5 | 14.4 2.7 | 23.3 4.4 | 18.7 2.3 | 18.9
pump 5 L/min | 0.5 | 9.7 2.7 | 23.1 4.4 | 14.1 0.2 | 14.2
water | 0.5 | 1.4 2.2 | 19.7 4.4 | 5.7 0.0 | 1.8
80% glycerol | 0.5 | 1.4 2.2 | 20.1 4.4 | 5.7 0.0 | 1.8
Cd holes x0.8 | 0.5 | 1.4 2.0 | 19.2 4.4 | 5.7 0.0 | 1.8
Cd port 0.62 | 0.5 | 1.4 2.4 | 20.9 4.4 | 5.7 0.0 | 1.8
-5 mmHg | 0.5 | 1.4 2.3 | 20.5 4.4 | 5.7 0.0 | 1.8
-10 mmHg | 0.5 | 1.4 2.0 | 19.3 4.4 | 5.7 0.0 | 1.8
on the floor | 0.5 | 1.4 2.2 | 19.9 4.4 | 5.7 4.4 | 6.2

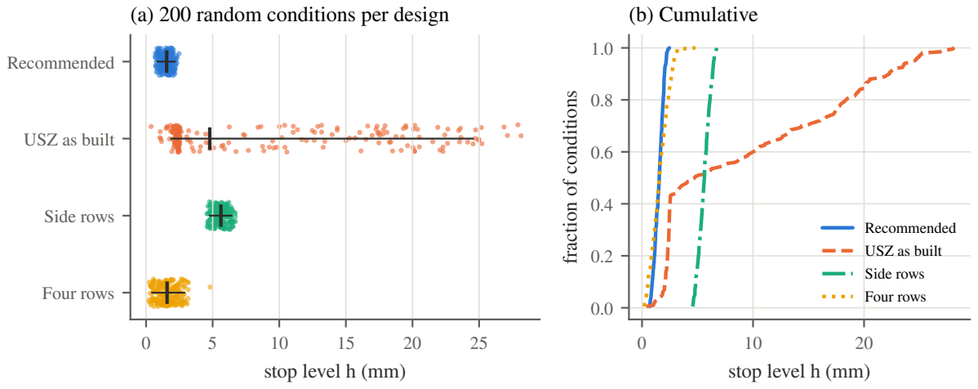
[picture p30: figure]
stop level h (mm); Recommended; USZ as built; Side rows; Four rows; (a) 200 random conditions per design; fraction of conditions; (b) Cumulative; Recommended USZ as built Side rows Four rows

Figure 18: Monte Carlo study: stop level under 200 random operating conditions per design. (a) Each dot is one condition; the bars show the median and the 5th to 95th percentiles. (b) Cumulative distributions.

## 7 Recommended design

Table 7: Recommended hole layout for the USZ body at −7 mmHg.

rows | two rows at θ = ±30◦ from the bottom line (about 5 and 7 o’clock when lying flat);
| none on the upper half
alignment | staggered by half a pitch
holes | Ø1.0 mm (1.0 to 1.5 mm is equally good), 18 per row, pitch 6.0 mm
span | x = 5 to 113 mm, reaching as close to both ends as the part allows
open area | 28.3 mm² ≈ 2× bore area (Λtot = 1.44)
suction source | wall regulator holding −7 mmHg while passing 18 L/min of air (12 L/min up to 10◦
| tilt); with a 5 to 10 L/min source, reduce to 12 to 24 holes (Table 5)
expected stop level | 0.5 mm (flat) to 2.1 mm (20◦ ), i.e. the lowest hole edge; full drainage up to 22.5

◦
flow when submerged 755 mL/min (81 % of the bore limit)

The design rules, in order of importance:
1. Keep the total open area near 1 to 2 times the bore area. More area adds almost no flow, because the bore already limits it, but it destroys the vacuum once holes are exposed.
2. Put the holes on the lower half of the skin, but not on the contact line.
3. Spread them uniformly along the whole length, using small holes so that there are enough stations to reach both ends, and stagger the rows.
4. Match the open area to the flow capacity of the suction source.
A flat drain may come to rest upside down. Mirroring the rows onto the top face would double the exposed area and cost tilt tolerance, so marking the orientation is the better fix.

Suggested bench test. In the glycerol–water tank:
- tilt the drain to 0

◦
, 5

◦

, 10◦

and 15◦ with the outlet up, and record the residual level;
- measure the vacuum in the outlet tube close to the drain, to confirm that the wall regulator really holds −7 mmHg while the drain sucks air (about 23 L/min);
- compare the as-built USZ part with a part drilled to Table 7.
The model predicts that at 10◦
the as-built part leaves about 20 mm and the recommended part about 1.4 mm.

## 8 Three-dimensional CFD check

The network model represents each opening and the bore by flow laws, and the inside of the drain by one gas pressure and one flat liquid level. A three-dimensional two-phase simulation drops these simplifications. It resolves the jets through the openings, the shape of the liquid inside the drain, the air stream into the bore and the actual pressure field. One case was run for each layout (Table 8). The set-up, all pictures and animations, and the logged data are in vof/kratos/.

Solver and geometry. The solver is the two-fluid Navier–Stokes solver of Kratos Multiphysics 10.3. The flow is laminar, both phases are incompressible, and a level set tracks the liquid–air interface. Surface tension is not modelled, which matches the model’s base case (contact angle 90◦
). The fluid properties are those of Section 2. The geometry is built with gmsh/OpenCASCADE from the model’s geometry: every opening drilled through the 0.6 mm wall along the skin normal, the Ø4.24 mm bore in the end face, and a 16.8 mm outlet tube. The drain sits in a trough 5.5 mm wider than it on each side, with a floor 2.5 mm below the drain and parallel to it (Fig. 19). The mesh is built in the drain frame, and the 10◦
tilt enters only through gravity. The boundary conditions are:
- Outlet: the pressure at the tube end is held at −933 Pa, an ideal wall regulator.
- Top of the trough: open to the atmosphere (0 Pa), so air can flow in and out.
- All walls: no-slip.

Mesh and time step. The tetrahedral mesh has these cell sizes (as-built field in brackets):
- 0.25 mm (0.35 mm) at the opening rims and the bore;
- 0.5 mm (0.6 mm) on the skin;
- 0.8 mm inside the drain;
- 1.6 mm in the pool and the air.
This gives 139 k nodes and 645 k cells for the recommended layout, and 203 k nodes and 827 k cells for the as-built field. The time step is fixed at 50 µs (implicit BDF2). Kratos’s default acceleration limit of 5 g is switched off: the air jets through the openings accelerate at about 10⁵ m/s²
, and the limit stops them. On a 12-core laptop one step takes 25–60 s.

Fixed-level snapshots. A full drainage takes seconds of flow time, which would need weeks on this machine, so each run is a snapshot at one pool level ℎ:
- Start: the pool starts at ℎ. The drain interior starts filled to the inner level ζ (ℎ) that the model predicts, with air above it.
- Logged every step: the liquid and air flow at the outlet, and the pressure at eight probes along the top of the interior and in the bore.
- Saved every 5 ms: the full fields.
- Flow through each opening: sampled on a disc across the middle of its bore.

Table 8: The two CFD cases at α = 10◦
. CFD values are averaged over the flow-time window shown; the model’s prediction is at the same pool level. The pressure is taken at the top of the drain interior, in its last 30 mm before the end face.
| pool | stop level | window | liquid out | air out | interior pressure
| (mm) | (mm) | (ms) | (mL/min) | (L/min) | (Pa)
recommended layout, CFD | 8 | – | 40–50 | 674 | 0.05 | −60 to −90 (in liquid)
model | 8 | 1.4 | – | 203 | 14.7 | −427
USZ as built, CFD | 21 | – | 4–15 | 58 | 16.5 | −5 to −85 (in air)
model | 21 | 20.0 | – | 148 | 23.3 | −37.5

As-built field, pool at 21 mm. This level is 1 mm above the model’s stop level.
- Air: within 2 ms the air flow through the exposed openings rises to 16–17 L/min and stays there (Fig. 20). The flows sampled in the 609 openings add up to 16.5 L/min of air, the same as at the outlet.
- Liquid: it leaves only as a thin film and in short slugs, 58 mL/min on average. The openings take in 45 mL/min.
- Inside the drain: the liquid stays near the model’s inner level (ζ = 24.3 mm), about 3 mm above the pool, held up by the vacuum. The air flows along the top of the interior into the bore at several metres per second.
- Air pressure: along the top of the interior it falls from about −5 Pa, 30 mm before the end face, to −85 Pa just before the bore. The model’s single gas pressure, −37.5 Pa, lies in between.
The CFD therefore shows the state the model predicts near the stop: the outlet carries mainly air and little liquid. The air flow is 29 % below the model’s value.
At 16.4 ms a liquid slug reached the end of the outlet tube, where the pressure is prescribed, and the solution diverged numerically. The fields up to 15 ms come before this and are used here.

Recommended layout, pool at 8 mm. This run did not reach a steady state in the 50 ms computed. It went through three stages:
1. Start (0–12 ms). With ζ = 24.7 mm, the drain starts 94 % full of liquid. The air pocket left at the top of the outlet end is held at −650 to −900 Pa (model: −427 Pa), and air leaves at 4–6 L/min (model: 14.7 L/min).
2. Priming (12–37 ms). The pocket is drawn off and the bore fills with liquid. Air then enters only as bubbles through the exposed openings (Fig. 21).

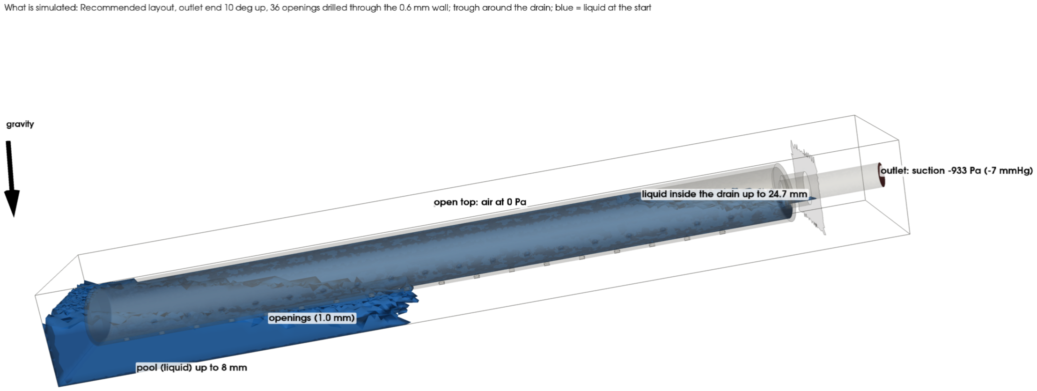
[picture p31: figure]

Figure 19: CFD set-up of the recommended-layout case: the drain in its trough with the outlet end 10◦ up, the pool at 8 mm, and the liquid inside the drain at the model’s inner level.

3. Siphon (37–50 ms). The outlet carries 674 mL/min of liquid and almost no air, and the pressure at the top of the interior, now in liquid, is only −60 to −90 Pa.
That vacuum can’t hold the liquid column 16.7 mm above the pool, which needs at least −184 Pa. So the drain is emptying the liquid it started with, not drawing it from the pool:
- at 50 ms its lowest openings carry liquid outward into the pool, at 0.4–0.5 m/s (about 10 mL/min each);
- the liquid inside the drain fell from 12.35 to 12.11 mL between 5 and 50 ms;
- only 0.21 mL left through the outlet in the whole run.
The outlet flow at 50 ms is therefore part of the start-up, and it can’t be compared with the model’s steady 203 mL/min. Reaching the steady state would take a few tenths of a second of flow, that is two to three days on this laptop.

What the CFD shows, and what it does not.
- It confirms the mechanism the model is built on. Exposed openings draw air at −7 mmHg. That air flows along the top of the interior into the bore and uses up most of the bore’s capacity.
- It agrees with the model near the as-built drain’s stop. With the as-built field at 21 mm, the outlet carries mainly air and little liquid, as the model predicts 1 mm above its stop level. The air flow agrees within 30 %.
- It does not confirm the stop levels quantitatively. The runs are short (15 and 50 ms) and the recommended case is still in its start-up. The openings have only 3–4 cells across, surface tension is not modelled, and the trough is small. The stop levels therefore still rest on the two reduced-order simulations of Section 5.

## 9 Limitations

- Model order. The model is a reduced-order network, not a 3D volume-of-fluid simulation. Slug and churn flow in the bore, foaming, and unsteady sloshing are represented only by the separated-phase bore model.
- Interior. The interior is one open lumen; the flow distribution along it (a suction manifold [10]) matters only for flow rates. The fluted inner wall and core of the as-built part add axial resistance, which changes flow rates and drain times but not the stop levels, since no liquid flows at the stop.
- Hole and bore laws. The discharge coefficients and the additive Sampson–Poiseuille law are standard correlations, not fitted to this part. The stop level is insensitive to them (Table 6).
- Capillarity and drawdown. These are treated with simple bounds. The real contact angle of the drain material should be measured.
- Tissue and clots. Tissue contact and clotting are outside the model; the existing FEBio work in the project addresses tissue sealing a hole.
- CFD check is qualitative. The 3D two-phase runs of Section 8 confirm the air-leak mechanism and the near-stop state of the as-built drain, but they are short and coarse at the openings. The stop levels are confirmed quantitatively only by the two reduced-order simulations.

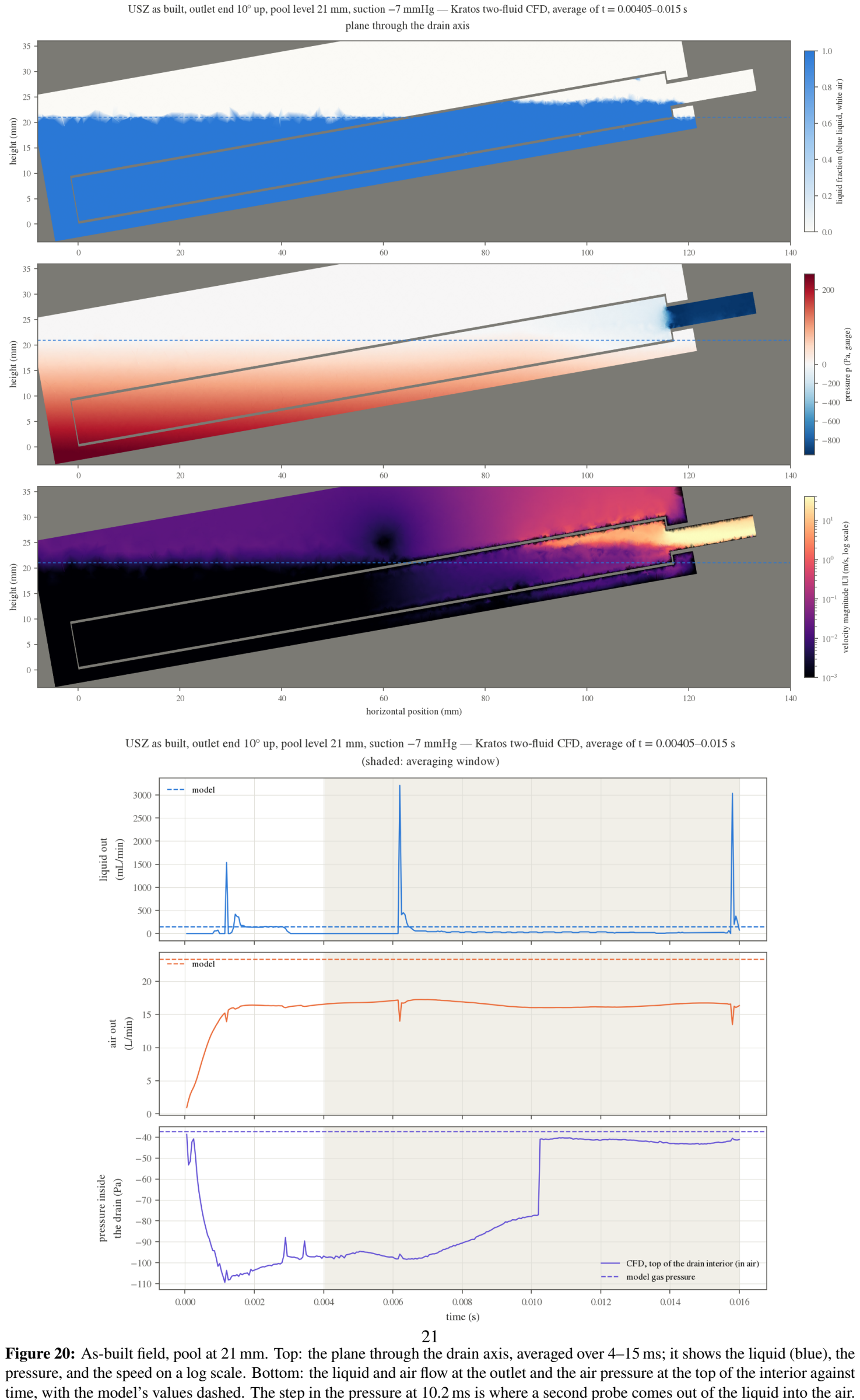
[picture p32: page 21]

Figure 20: As-built field, pool at 21 mm. Top: the plane through the drain axis, averaged over 4–15 ms; it shows the liquid (blue), the pressure, and the speed on a log scale. Bottom: the liquid and air flow at the outlet and the air pressure at the top of the interior against time, with the model’s values dashed. The step in the pressure at 10.2 ms is where a second probe comes out of the liquid into the air.

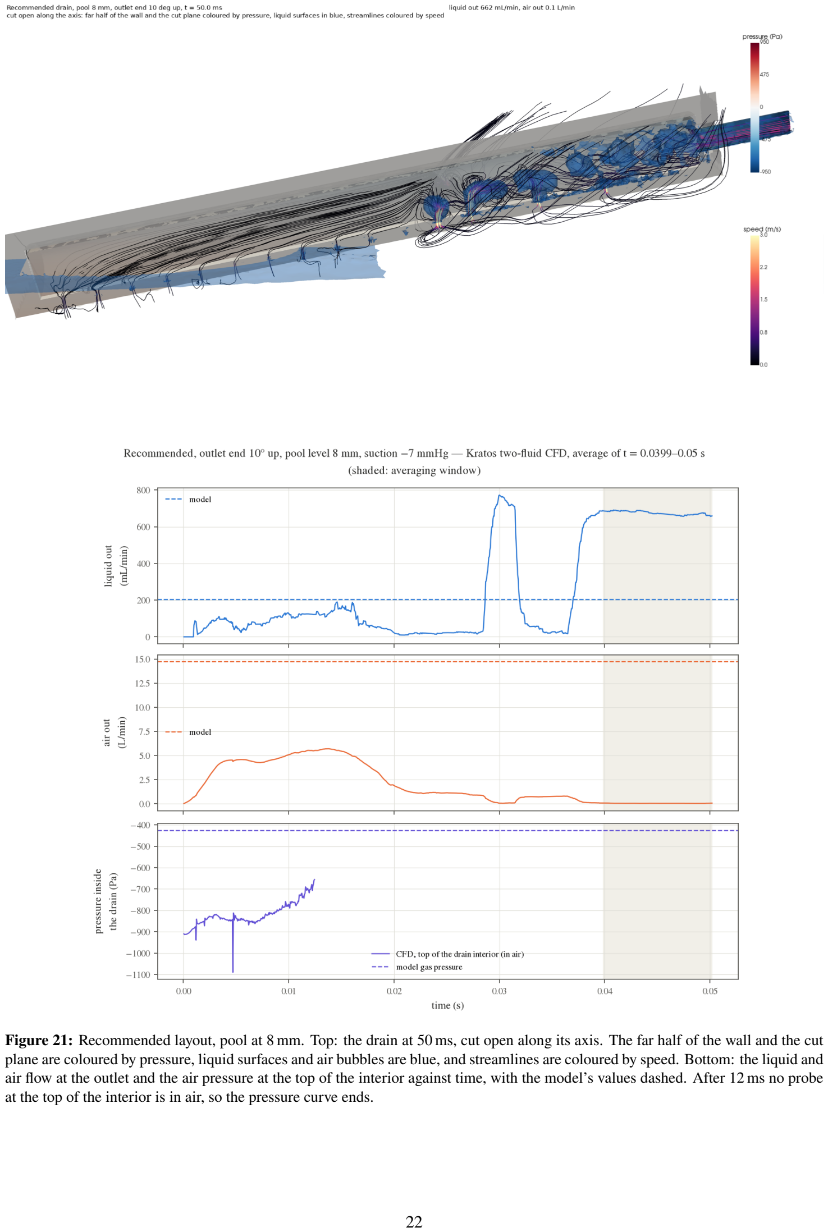
[picture p33: page 22]

Figure 21: Recommended layout, pool at 8 mm. Top: the drain at 50 ms, cut open along its axis. The far half of the wall and the cut plane are coloured by pressure, liquid surfaces and air bubbles are blue, and streamlines are coloured by speed. Bottom: the liquid and air flow at the outlet and the air pressure at the top of the interior against time, with the model’s values dashed. After 12 ms no probe at the top of the interior is in air, so the pressure curve ends.

## 10 Conclusions

1. Exposed holes always leak. At −7 mmHg (Hv = 84.5 mm), every hole of 0.5 to 4 mm lets air in once it is exposed; capillary sealing would need holes below 0.29 mm.
2. The stop condition. The air leak and the outlet bore form a pressure divider. Drainage stops when ℎ+Hv/(1+Λ

2
w) =
zℓ , or when no hole is left below the surface. Two independent simulations confirm this.
3. Tilt is the critical case. When the drain lies flat, every layout drains to just below the bore lip (2.7 mm). With the outlet up, the lip rises by L sin α, and only a small exposed-area ratio keeps the vacuum high enough to lift the liquid there.
4. What decides the result. Hole size matters only through the total open area and the coverage of the length. Too much area (as built: 468 mm²

) stops the drain at 20 mm with the outlet 10◦ up; too few, large holes leave the ends uncovered.
5. Recommendation. Use two staggered rows at ±30◦ with 36×Ø1.0 mm (2 times the bore area). This drains to the lowest hole edge from −10◦

to +22◦ while keeping 81 % of the maximum flow. With the intended wall regulator this needs at least 18 L/min of air flow at −7 mmHg; with a weaker source, use fewer holes (Table 5).

Reproduction. All code is in drain/drainstop: drainstop/model.py (geometry, hydraulics, network solver, closed form), drainstop/transient.py (time-dependent model), scripts/run_study.py (all studies, ∼10 min on 12 cores), scripts/make_figures.py, scripts/make_tables.py and scripts/make_pictures.py (Fig. 8); the 3D CFD (Kratos, Windows) and its results are in vof/kratos/; an OpenFOAM set-up is in vof/ (Euler) and vof/local/ (Linux).

## References

[1] R. A. Sampson, On Stokes’s current function, Phil. Trans. R. Soc. Lond. A 182 (1891) 449–518.
[2] Z. Dagan, S. Weinbaum, R. Pfeffer, An infinite-series solution for the creeping motion through an orifice of finite length, J. Fluid Mech. 115 (1982) 505–523.
[3] A. Lichtarowicz, R. K. Duggins, E. Markland, Discharge coefficients for incompressible non-cavitating flow through long orifices, J. Mech. Eng. Sci. 7 (1965) 210–219.
[4] I. E. Idelchik, Handbook of Hydraulic Resistance, 3rd ed., Begell House, 1994.
[5] J. F. Oliver, C. Huh, S. G. Mason, Resistance to spreading of liquids by sharp edges, J. Colloid Interface Sci. 59 (1977) 568–581.
[6] P.-G. de Gennes, F. Brochard-Wyart, D. Quéré, Capillarity and Wetting Phenomena, Springer, 2004.
[7] N.-S. Cheng, Formula for the viscosity of a glycerol–water mixture, Ind. Eng. Chem. Res. 47 (2008) 3285–3288.
[8] G. B. Wallis, One-Dimensional Two-Phase Flow, McGraw-Hill, 1969.
[9] J. L. Gordon, Vortices at intakes, Water Power 22 (1970) 137–138.
[10] R. A. Bajura, E. H. Jones, Flow distribution manifolds, J. Fluids Eng. 98 (1976) 654–665.
