IasonKa/drain/drainstop/paper/figures/fig01_geometry.pdf

(a) Side view, lying flat, to scale (recommended hole layout on the near side)

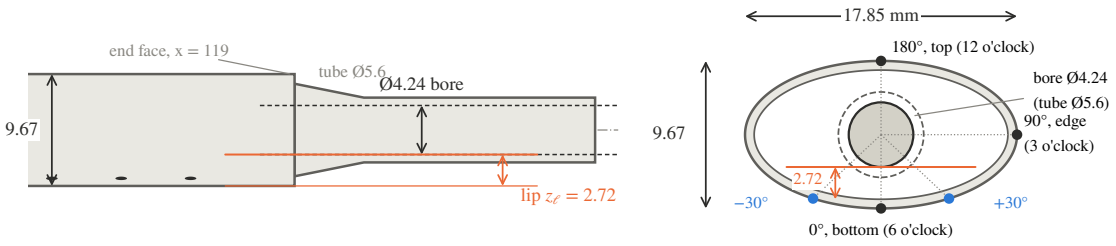
[picture p34: figure]
lip zℓ = 2.72; Ø4.24 bore; end face, x = 119; tube Ø5.6; 0°, bottom (6 o'clock); 90°, edge (3 o'clock); 180°, top (12 o'clock); bore Ø4.24 (tube Ø5.6)

(b) Outlet end, enlarged: centred bore and its lip
(c) End view: angle θ around the skin

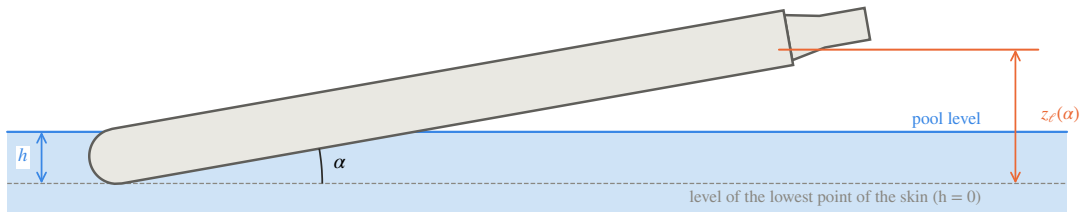
[picture p35: figure]
pool level

level of the lowest point of the skin (h = 0)

(d) Tilt α (outlet up > 0), pool level h and lip height zℓ(α)
