IasonKa/drain/drainstop/paper/generated/tab_sizes.tex

\begin{tabular}{@{}r r r r rrrrrrr@{}}
\toprule
\O\ (mm) & holes & $A$ (mm$^2$) & $Q_0$ (mL/min) & $-10^\circ$ & $-5^\circ$ & $0^\circ$ & $+5^\circ$ & $+10^\circ$ & $+15^\circ$ & $+20^\circ$ \\
\midrule
{0.5} & 144 & 28 & 699 & 1.7 & 1.2 & 0.6 & 1.0 & 1.4 & 1.9 & 2.3 \\
\textbf{1} & 36 & 28 & 755 & 2.0 & 1.3 & 0.5 & 0.9 & 1.4 & 1.8 & 2.1 \\
{1.5} & 16 & 28 & 773 & 2.6 & 1.6 & 0.5 & 0.9 & 1.3 & 1.7 & 2.0 \\
{2} & 8 & 25 & 747 & 3.7 & 2.1 & 0.4 & 0.8 & 1.2 & 1.6 & 1.9 \\
{2.5} & 6 & 29 & 794 & 4.4 & 2.4 & 0.3 & 0.8 & 1.2 & 1.5 & 1.8 \\
{3} & 4 & 28 & 786 & 5.9 & 3.2 & 0.3 & 0.7 & 1.1 & 1.4 & 1.7 \\
{3.5} & 2 & 19 & 670 & 10.6 & 5.5 & 0.3 & 0.7 & 1.0 & 1.4 & 1.6 \\
{4} & 2 & 25 & 756 & 10.5 & 5.4 & 0.2 & 0.6 & 1.0 & 1.3 & 1.5 \\
\bottomrule
\end{tabular}
