IasonKa/drain/drainstop/paper/figures/fig10_heatmap_tilt.pdf

## (a) Ø1.0, 19 holes per row

## (b) Ø1.0, open area 28 mm²

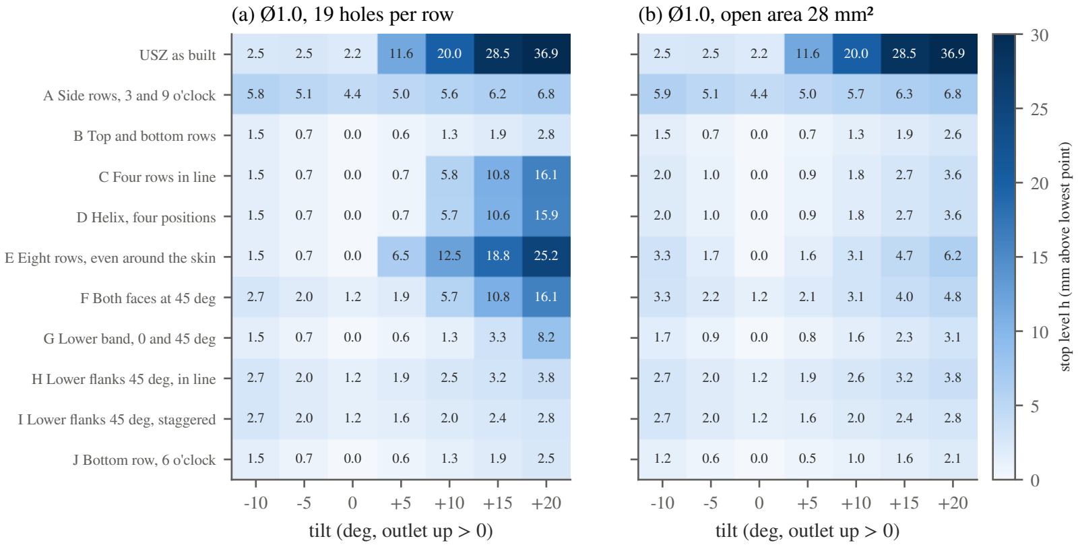
[picture p36: page 1]

-10 -5 | 0 | +5 +10 +15 +20

## tilt (deg, outlet up > 0)

USZ as built

A Side rows, 3 and 9 o'clock

B Top and bottom rows

C Four rows in line

D Helix, four positions

E Eight rows, even around the skin

F Both faces at 45 deg

G Lower band, 0 and 45 deg

H Lower flanks 45 deg, in line

I Lower flanks 45 deg, staggered

J Bottom row, 6 o'clock

2.5 | 2.5 | 2.2 | 11.6 20.0 28.5 36.9
5.8 | 5.1 | 4.4 | 5.0 | 5.6 | 6.2 | 6.8
1.5 | 0.7 | 0.0 | 0.6 | 1.3 | 1.9 | 2.8
1.5 | 0.7 | 0.0 | 0.7 | 5.8 | 10.8 16.1
1.5 | 0.7 | 0.0 | 0.7 | 5.7 | 10.6 15.9
1.5 | 0.7 | 0.0 | 6.5 | 12.5 18.8 25.2
2.7 | 2.0 | 1.2 | 1.9 | 5.7 | 10.8 16.1
1.5 | 0.7 | 0.0 | 0.6 | 1.3 | 3.3 | 8.2
2.7 | 2.0 | 1.2 | 1.9 | 2.5 | 3.2 | 3.8
2.7 | 2.0 | 1.2 | 1.6 | 2.0 | 2.4 | 2.8
1.5 | 0.7 | 0.0 | 0.6 | 1.3 | 1.9 | 2.5
-10 -5 | 0 | +5 +10 +15 +20

## tilt (deg, outlet up > 0)

2.5 | 2.5 | 2.2 | 11.6 20.0 28.5 36.9
5.9 | 5.1 | 4.4 | 5.0 | 5.7 | 6.3 | 6.8
1.5 | 0.7 | 0.0 | 0.7 | 1.3 | 1.9 | 2.6
2.0 | 1.0 | 0.0 | 0.9 | 1.8 | 2.7 | 3.6
2.0 | 1.0 | 0.0 | 0.9 | 1.8 | 2.7 | 3.6
3.3 | 1.7 | 0.0 | 1.6 | 3.1 | 4.7 | 6.2
3.3 | 2.2 | 1.2 | 2.1 | 3.1 | 4.0 | 4.8
1.7 | 0.9 | 0.0 | 0.8 | 1.6 | 2.3 | 3.1
2.7 | 2.0 | 1.2 | 1.9 | 2.6 | 3.2 | 3.8
2.7 | 2.0 | 1.2 | 1.6 | 2.0 | 2.4 | 2.8
1.2 | 0.6 | 0.0 | 0.5 | 1.0 | 1.6 | 2.1
0

5

10

15

20

25

30

stop level h (mm above lowest point)
