IasonKa/drain/drainsponge/data/standoff_design.png

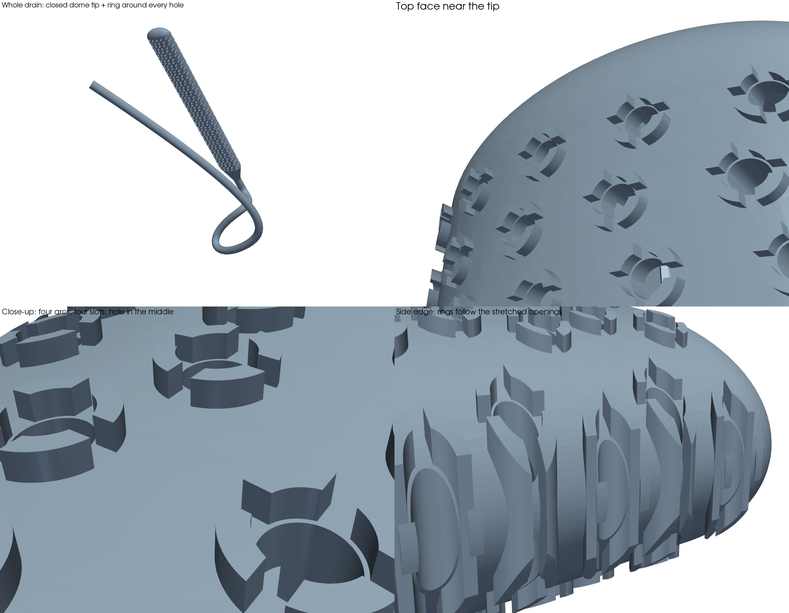
drainsponge/data/standoff_design.png
