IasonKa/drain/drainsponge/data/standoff_section.png

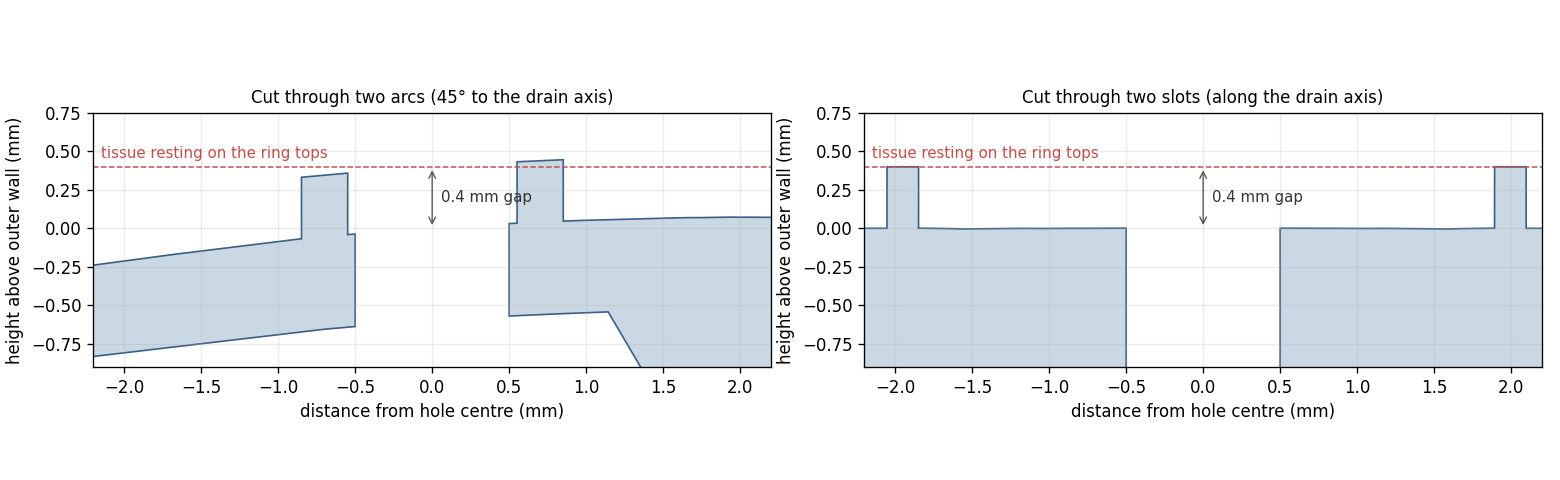
drainsponge/data/standoff_section.png
