IasonKa/drain/drainstop/paper/figures/fig01_geometry.png

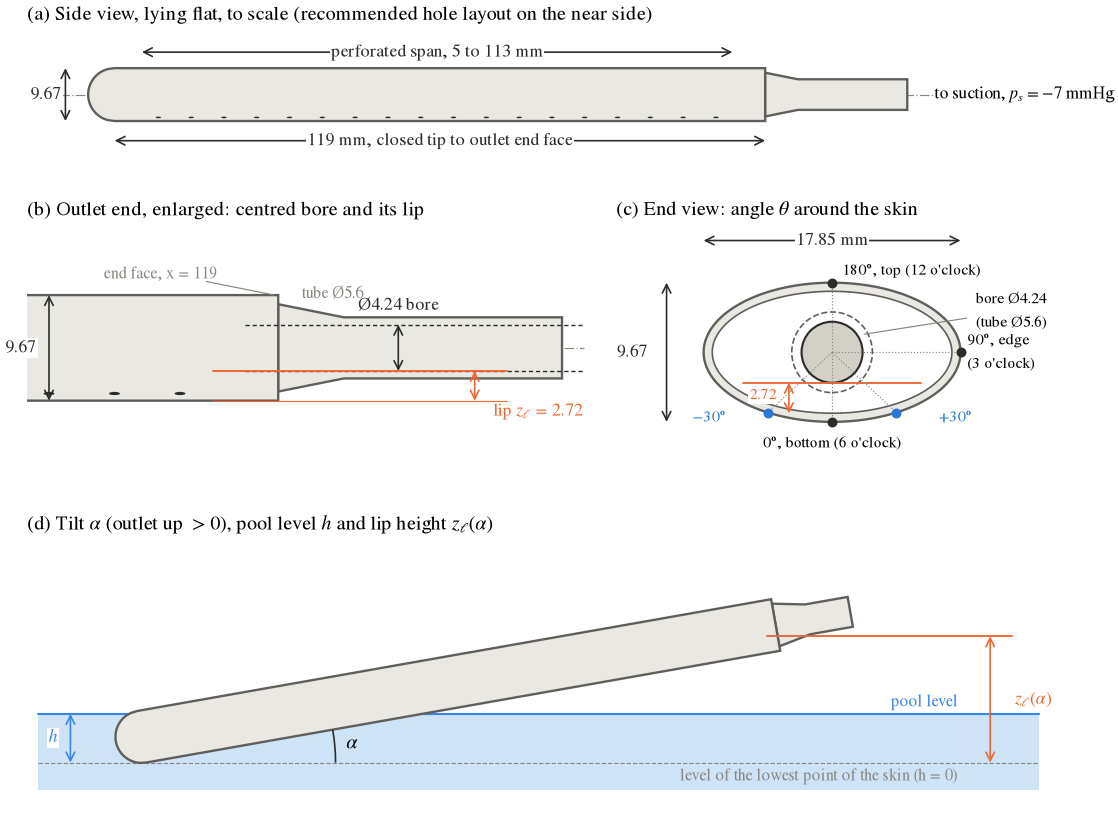
drainstop/paper/figures/fig01_geometry.png
