IasonKa/drain/drainstop/paper/figures/fig03_patterns.png

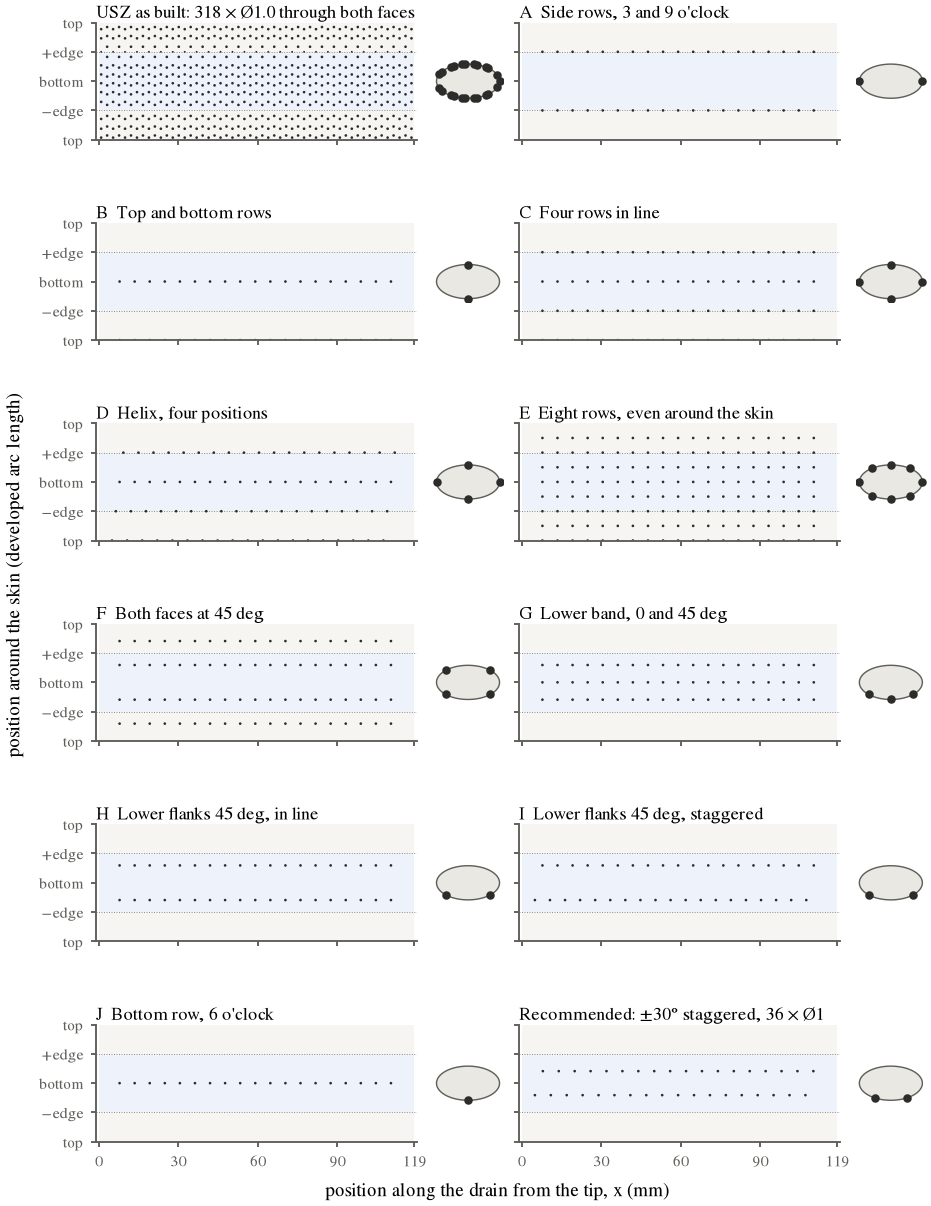
drainstop/paper/figures/fig03_patterns.png
