IasonKa/drain/drainstop/paper/figures/fig04_sizes.png

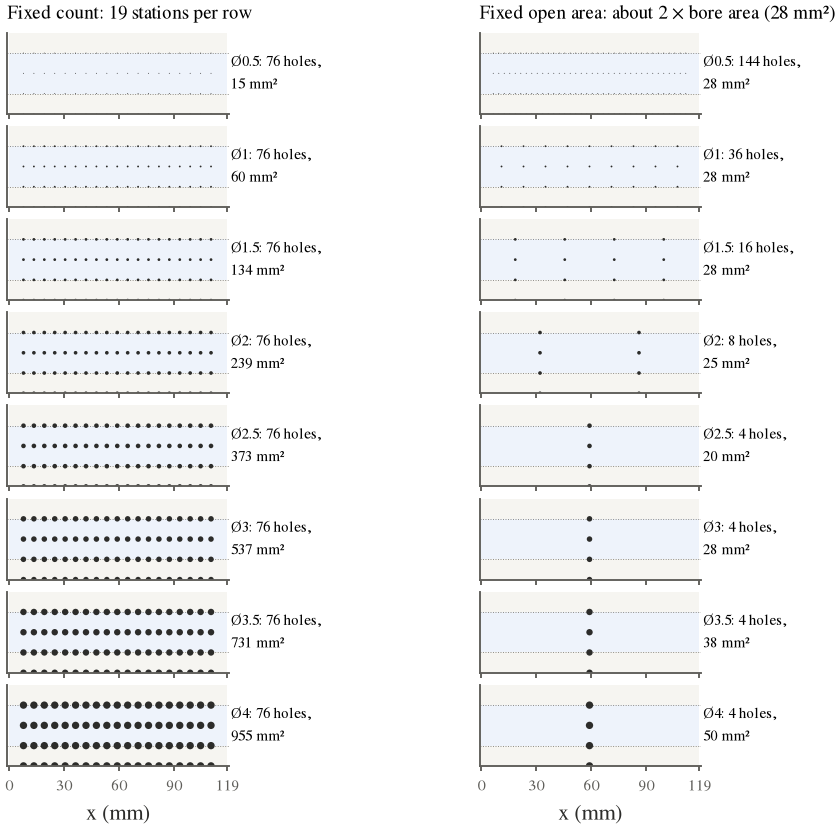
drainstop/paper/figures/fig04_sizes.png
