IasonKa/drain/drainstop/paper/figures/fig05_3d.png

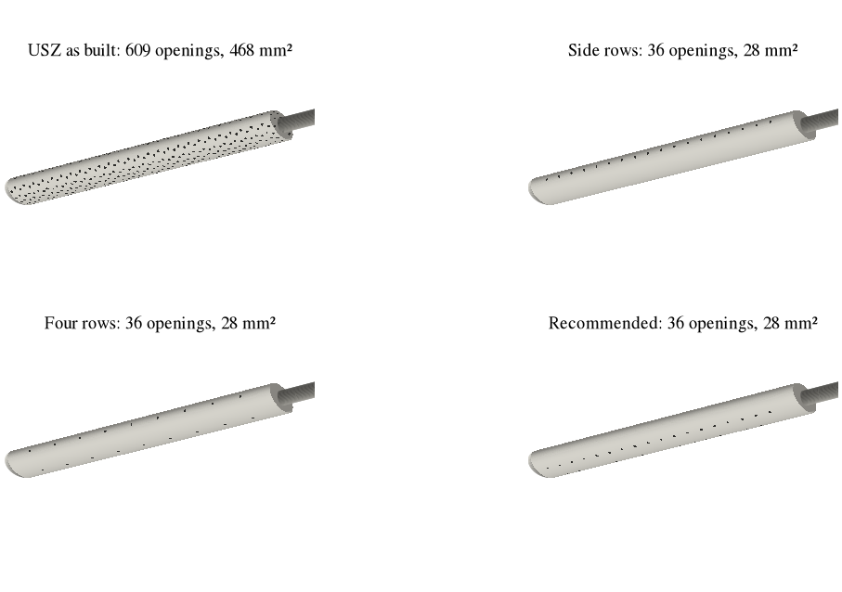
drainstop/paper/figures/fig05_3d.png
