IasonKa/drain/drainstop/paper/figures/fig08_hstop_vs_d_count.png

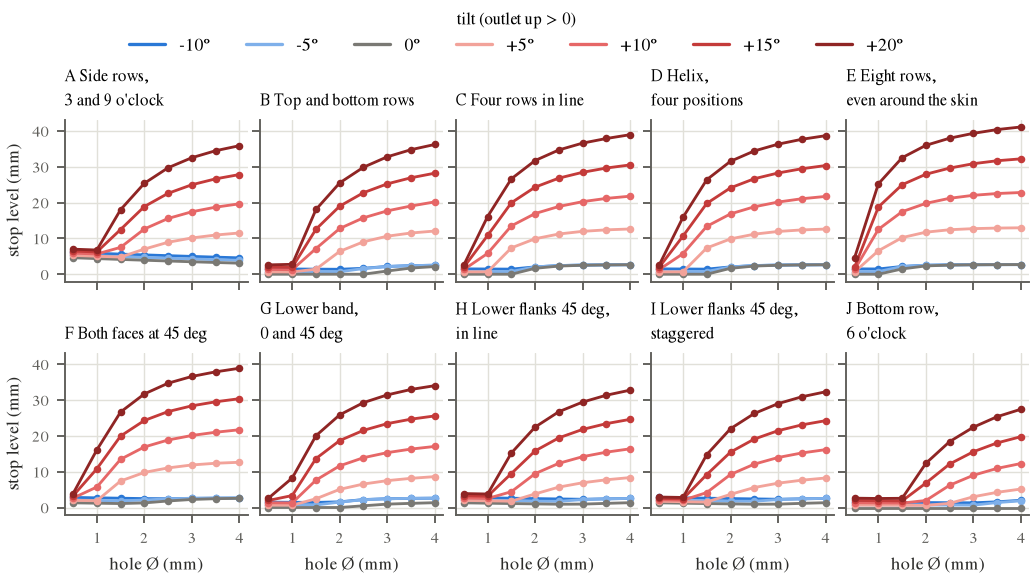
drainstop/paper/figures/fig08_hstop_vs_d_count.png
