IasonKa/drain/drainstop/paper/figures/fig09_hstop_vs_d_area.png

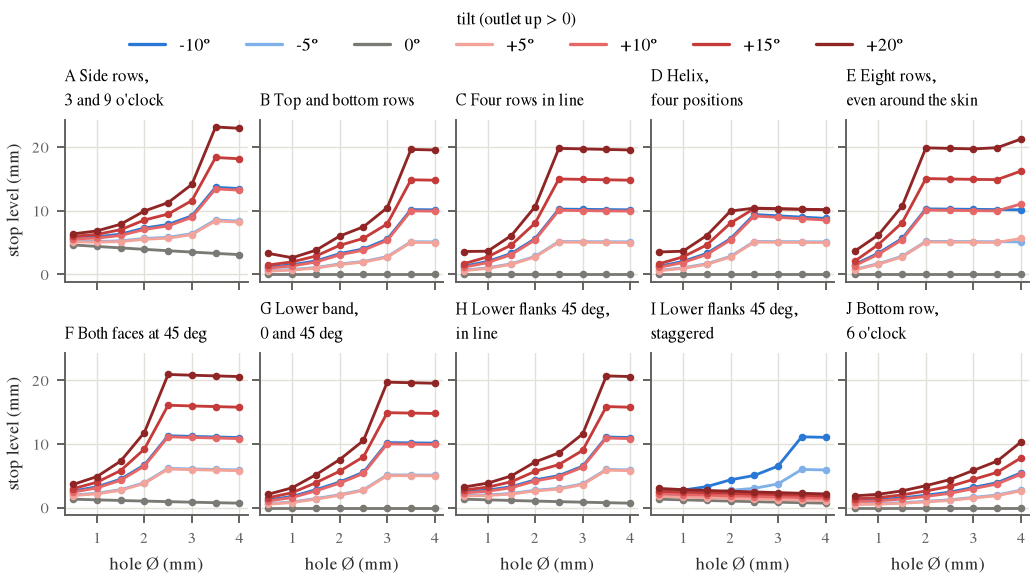
drainstop/paper/figures/fig09_hstop_vs_d_area.png
