IasonKa/drain/drainstop/paper/figures/fig16_tiltlimit.png

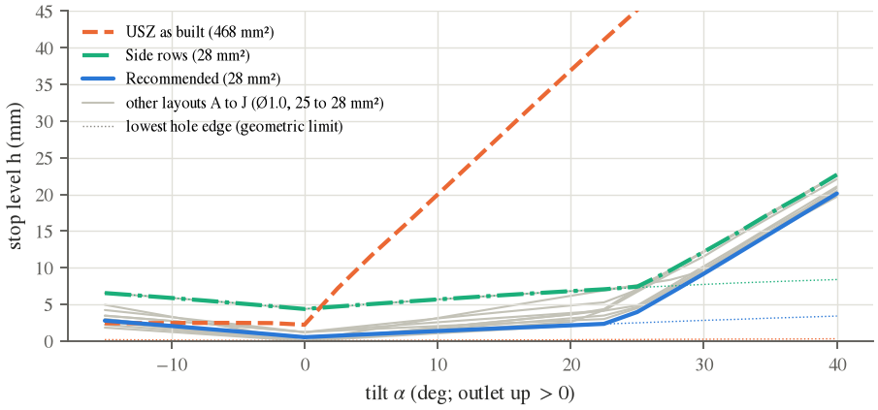
drainstop/paper/figures/fig16_tiltlimit.png
