IasonKa/drain/drainstop/pictures/drain_emptying_tilt10.gif

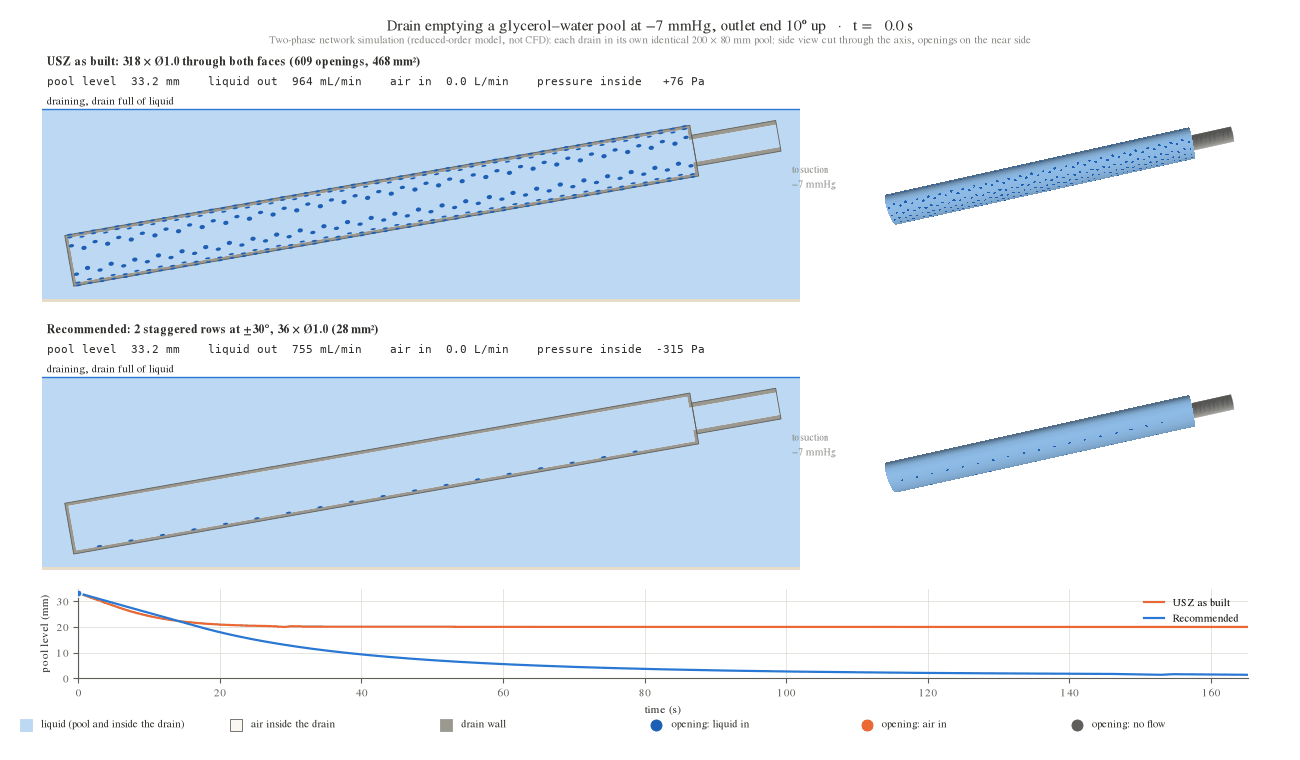
drainstop/pictures/drain_emptying_tilt10.gif
