IasonKa/drain/visualization/01_drain_with_sponge_organ_current.png

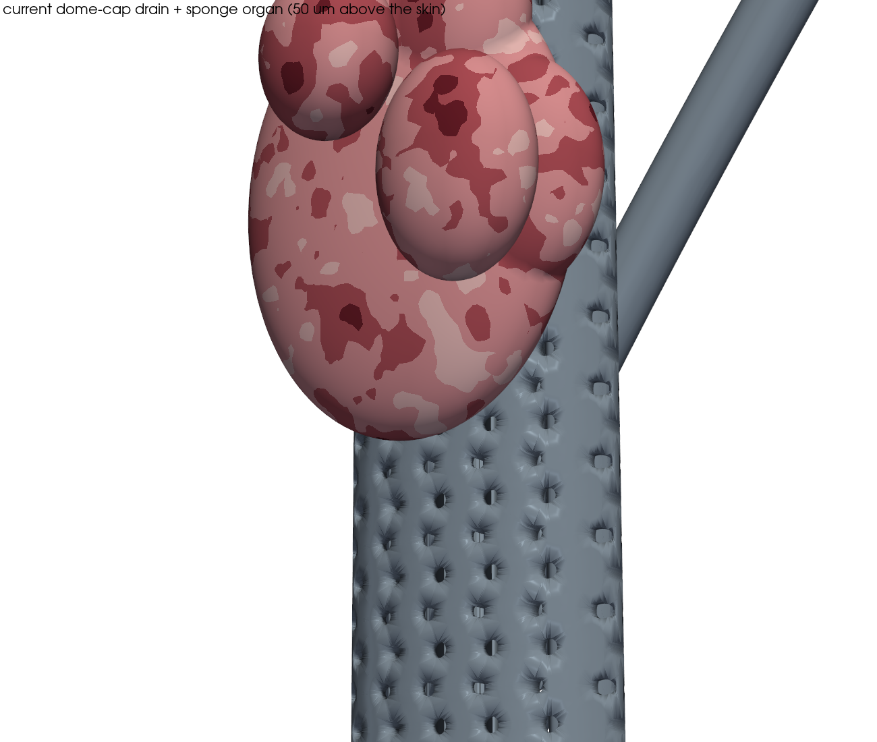
visualization/01_drain_with_sponge_organ_current.png
