IasonKa/drain/visualization/02_hole_window_cutaway_current.png

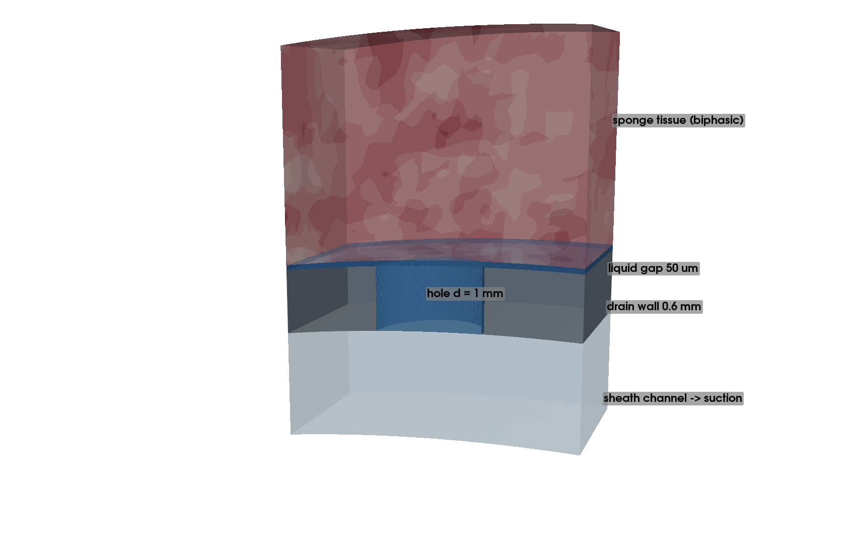
visualization/02_hole_window_cutaway_current.png
