IasonKa/drain/visualization/02_hole_window_cutaway_standoff.png

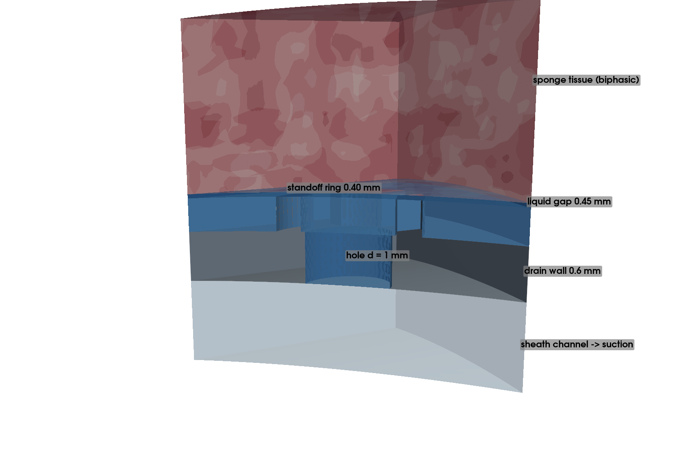
visualization/02_hole_window_cutaway_standoff.png
