IasonKa/drain/visualization/03_mesh_section_current.png

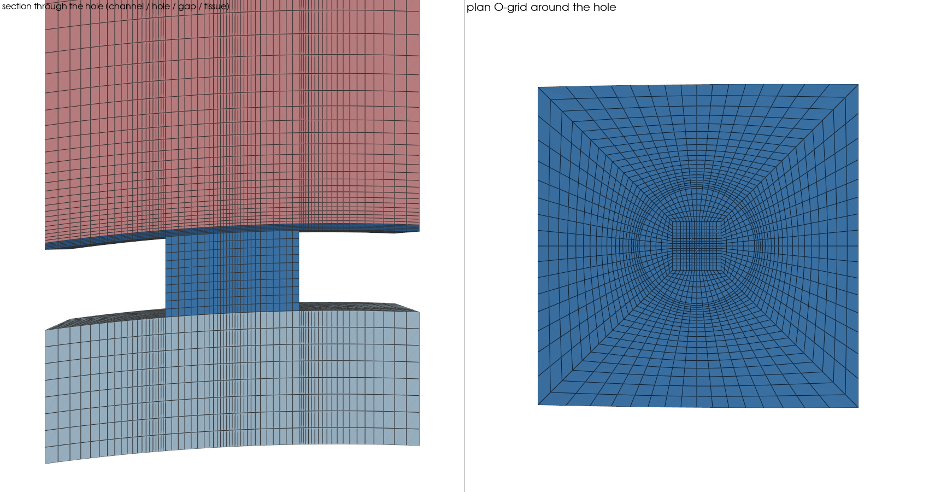
visualization/03_mesh_section_current.png
