IasonKa/drain/visualization/03_mesh_section_standoff.png

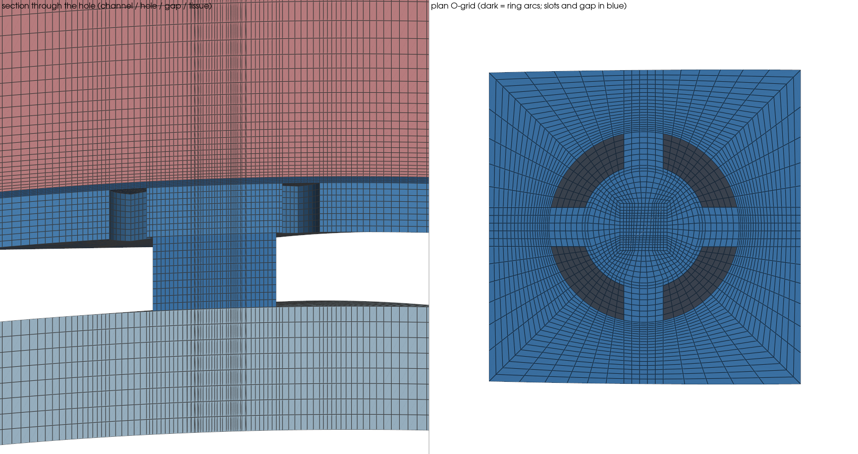
visualization/03_mesh_section_standoff.png
