IasonKa/drain/visualization/04_section_at_hole_current.png

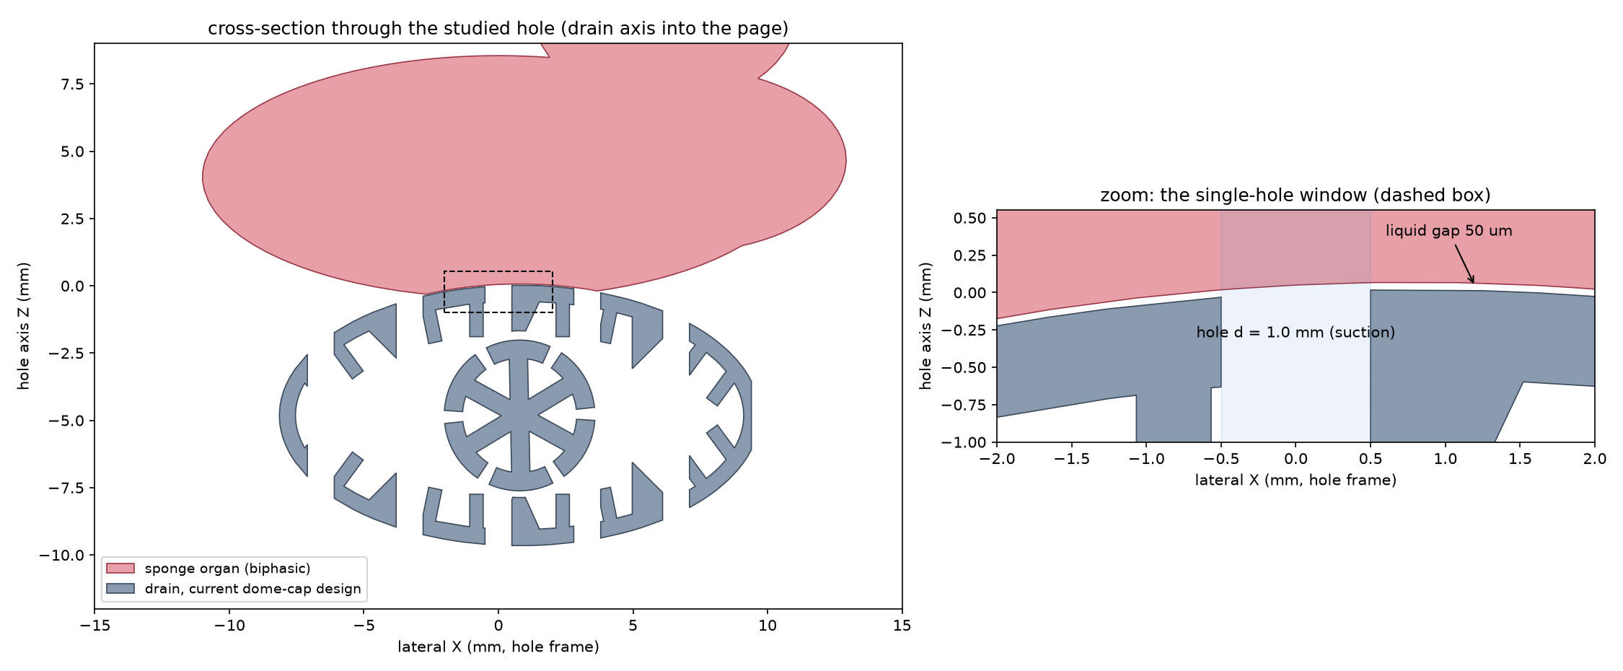
visualization/04_section_at_hole_current.png
