IasonKa/drain/visualization/04_section_at_hole_standoff.png

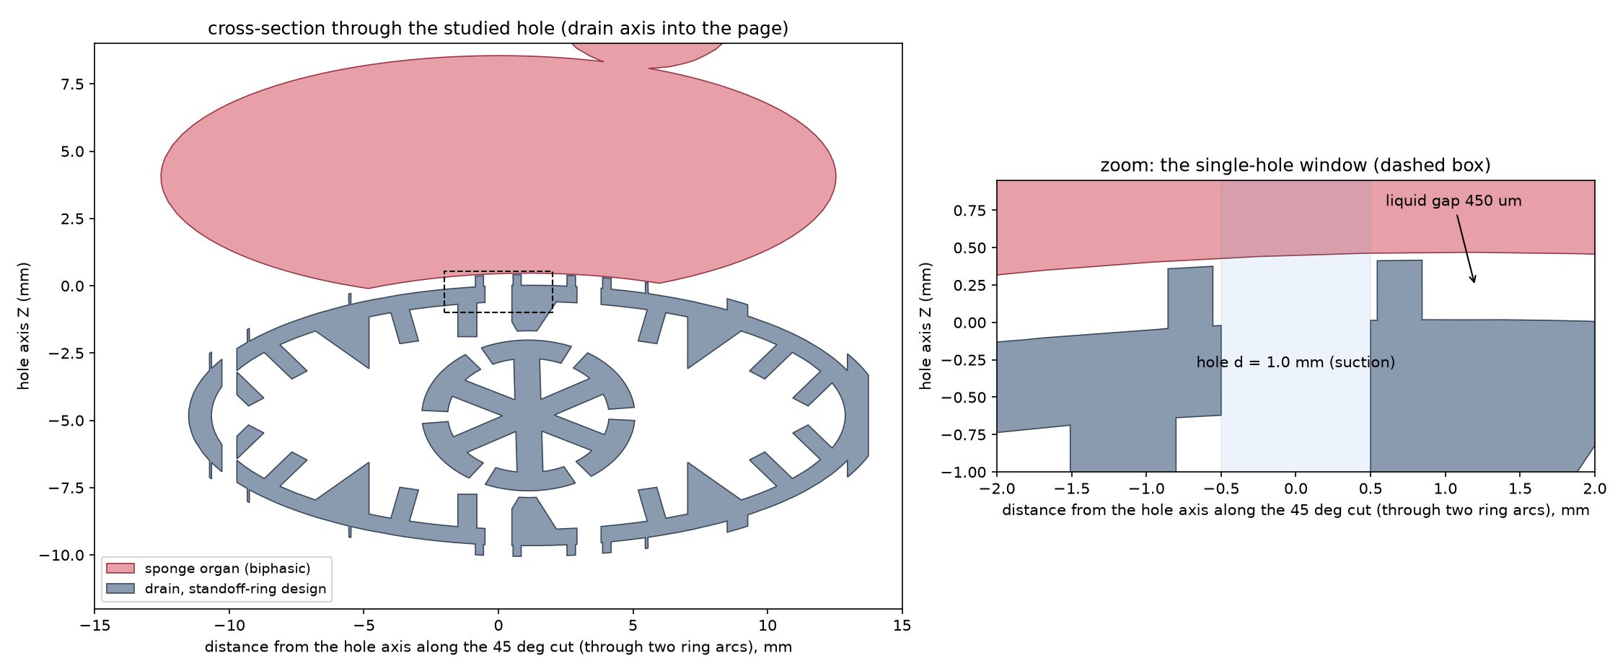
visualization/04_section_at_hole_standoff.png
