IasonKa/drain/visualization/05_timeline_current_closed.png

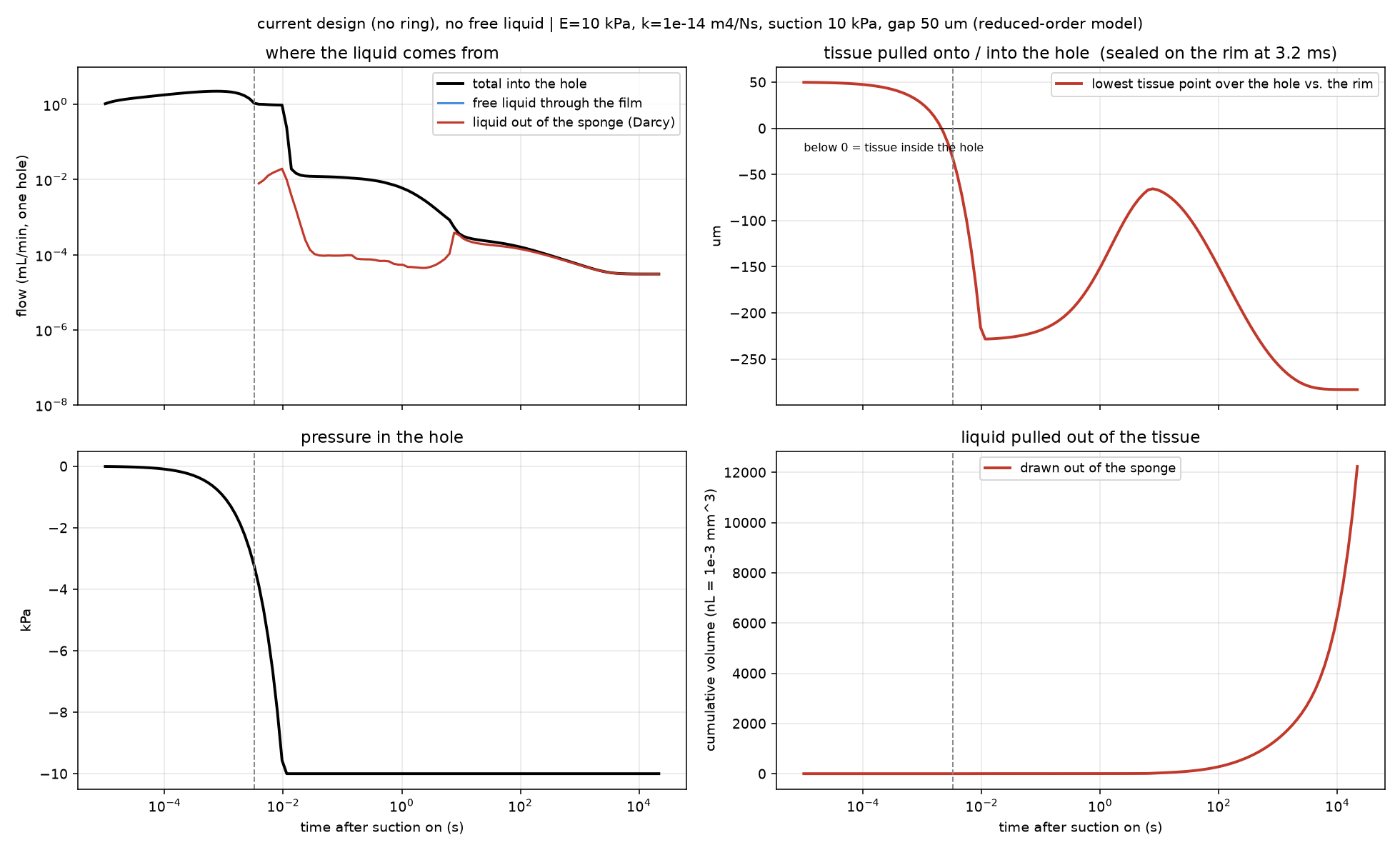
visualization/05_timeline_current_closed.png
