IasonKa/drain/visualization/05_timeline_current_open.png

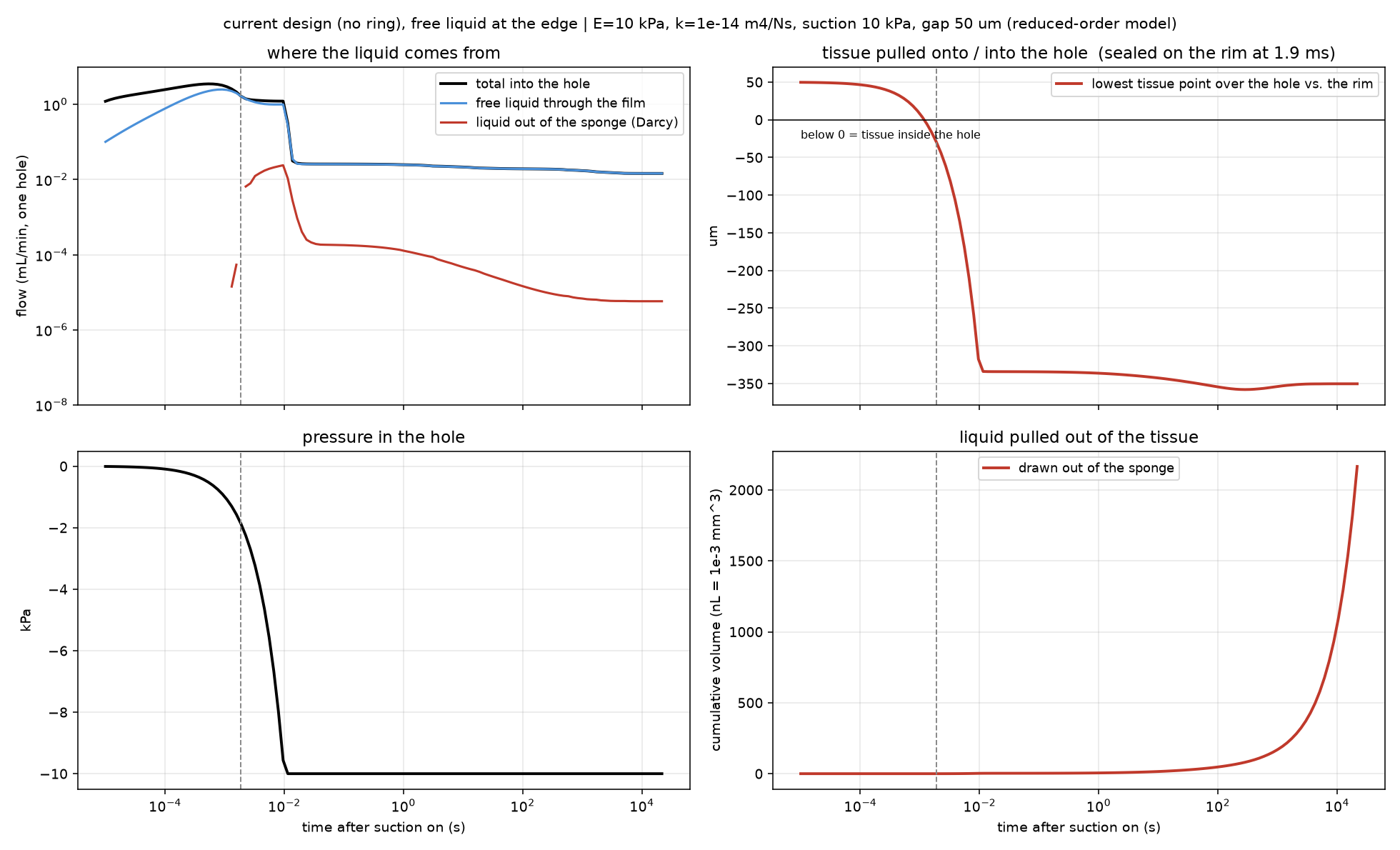
visualization/05_timeline_current_open.png
