IasonKa/drain/visualization/05_timeline_standoff_closed.png

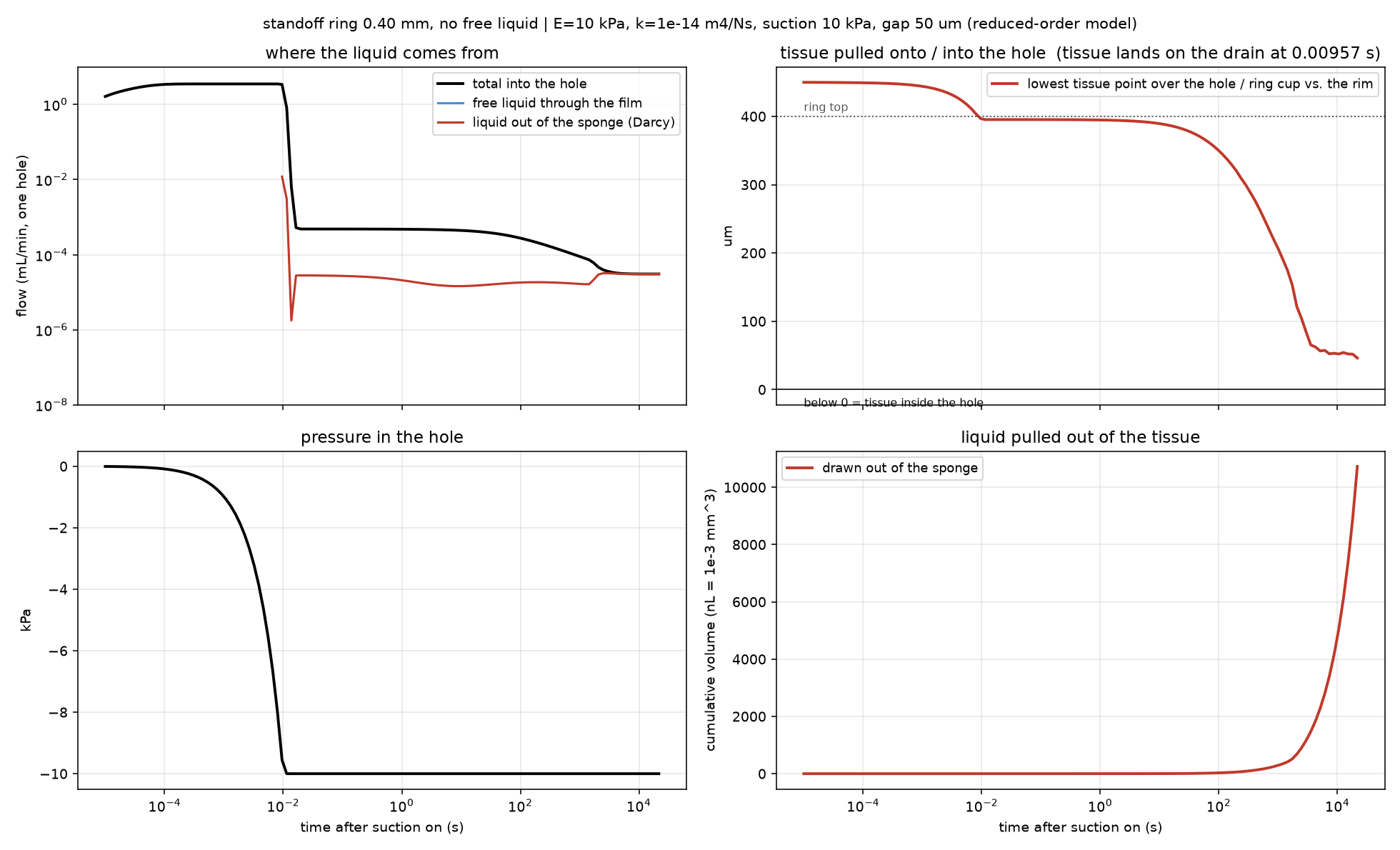
visualization/05_timeline_standoff_closed.png
