IasonKa/drain/visualization/05_timeline_standoff_open.png

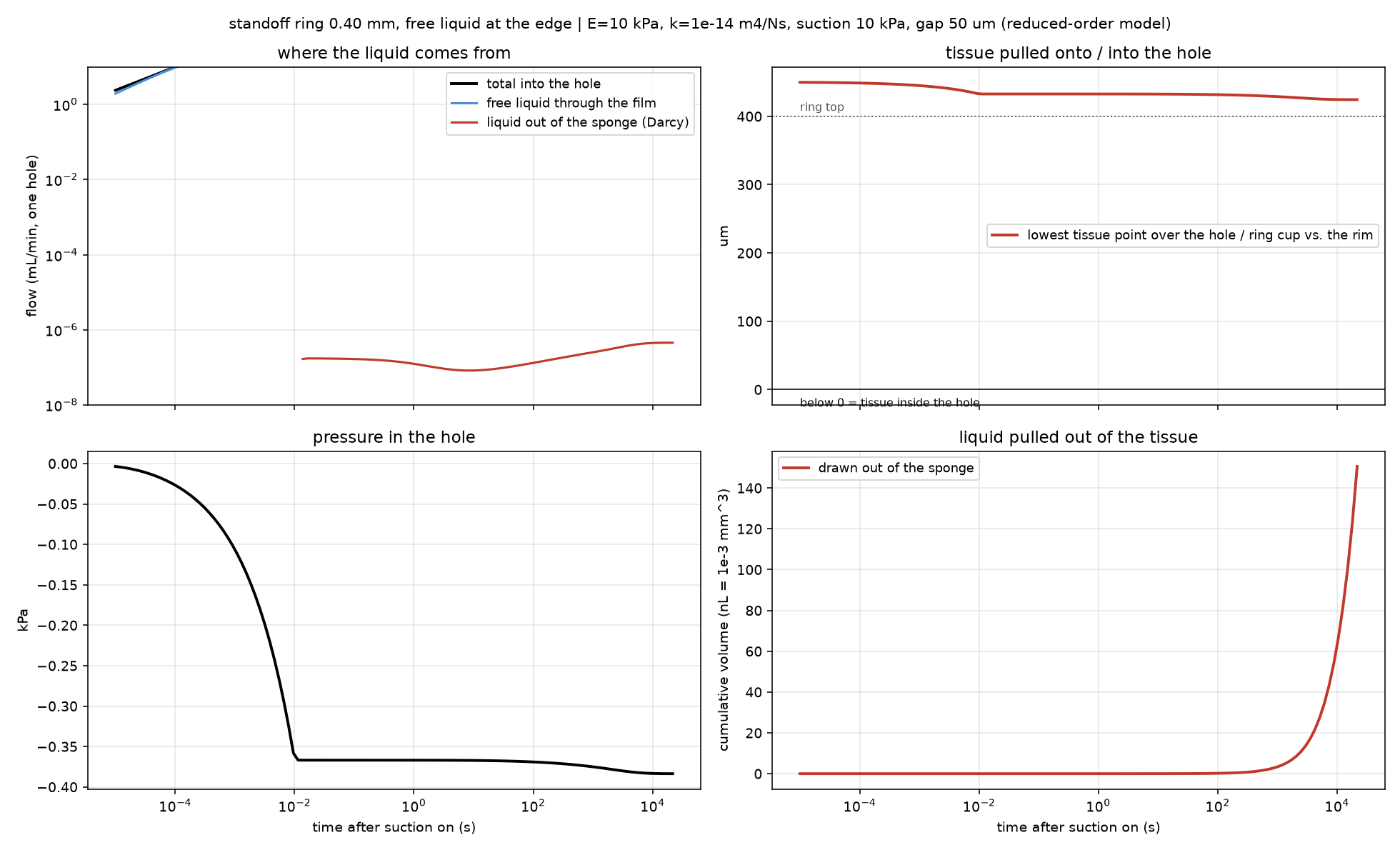
visualization/05_timeline_standoff_open.png
