IasonKa/drain/visualization/06_fields_current_closed.png

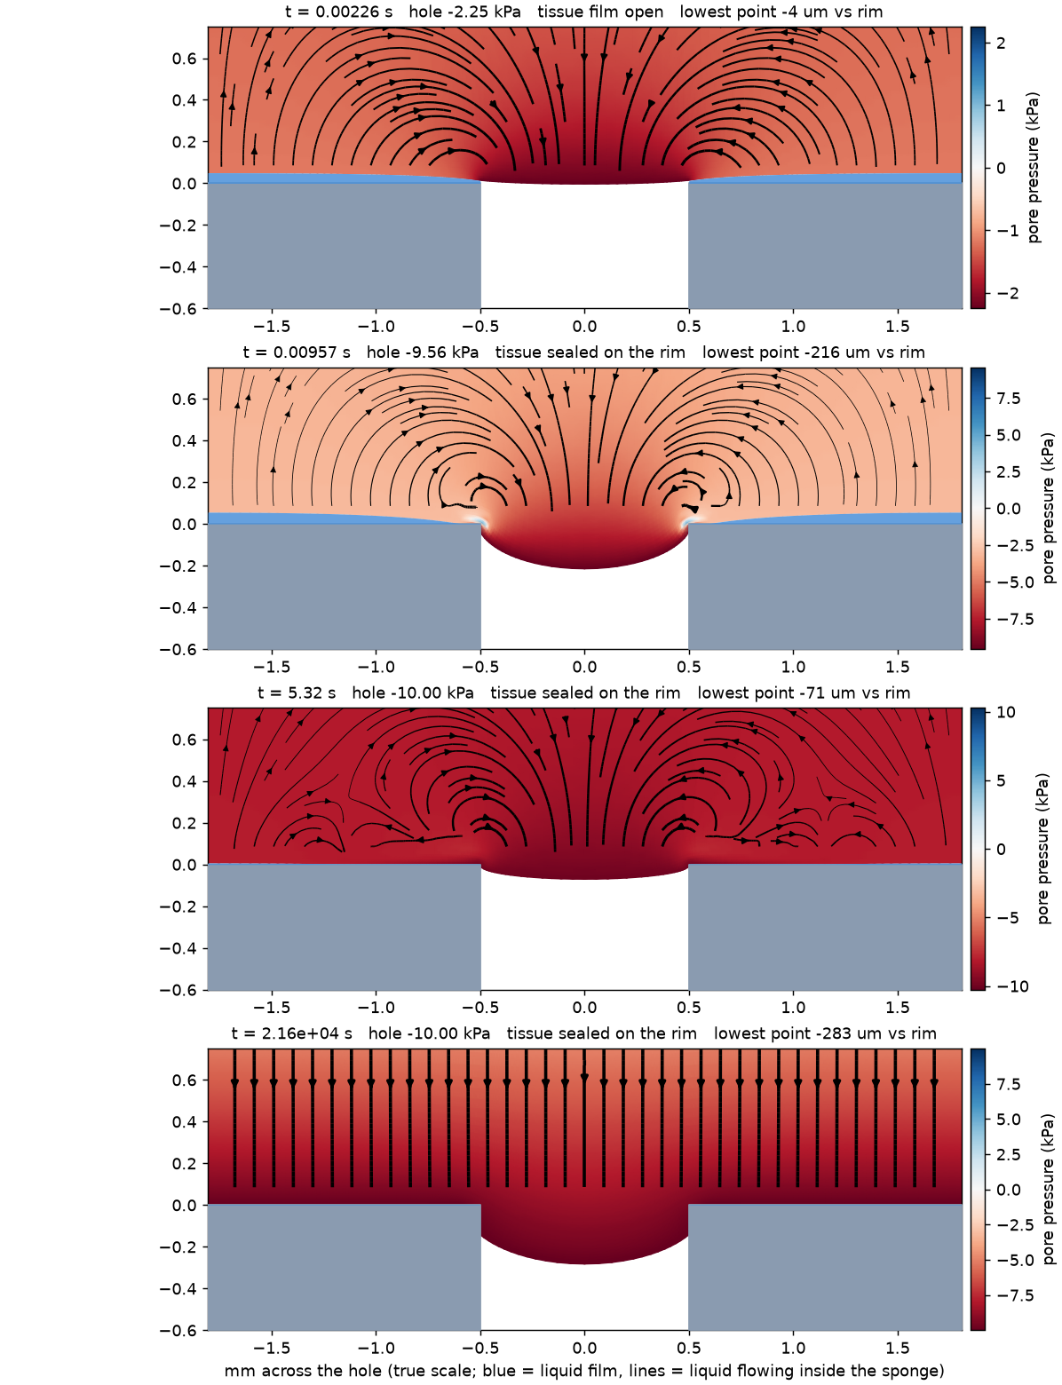
visualization/06_fields_current_closed.png
