IasonKa/drain/visualization/06_fields_current_open.png

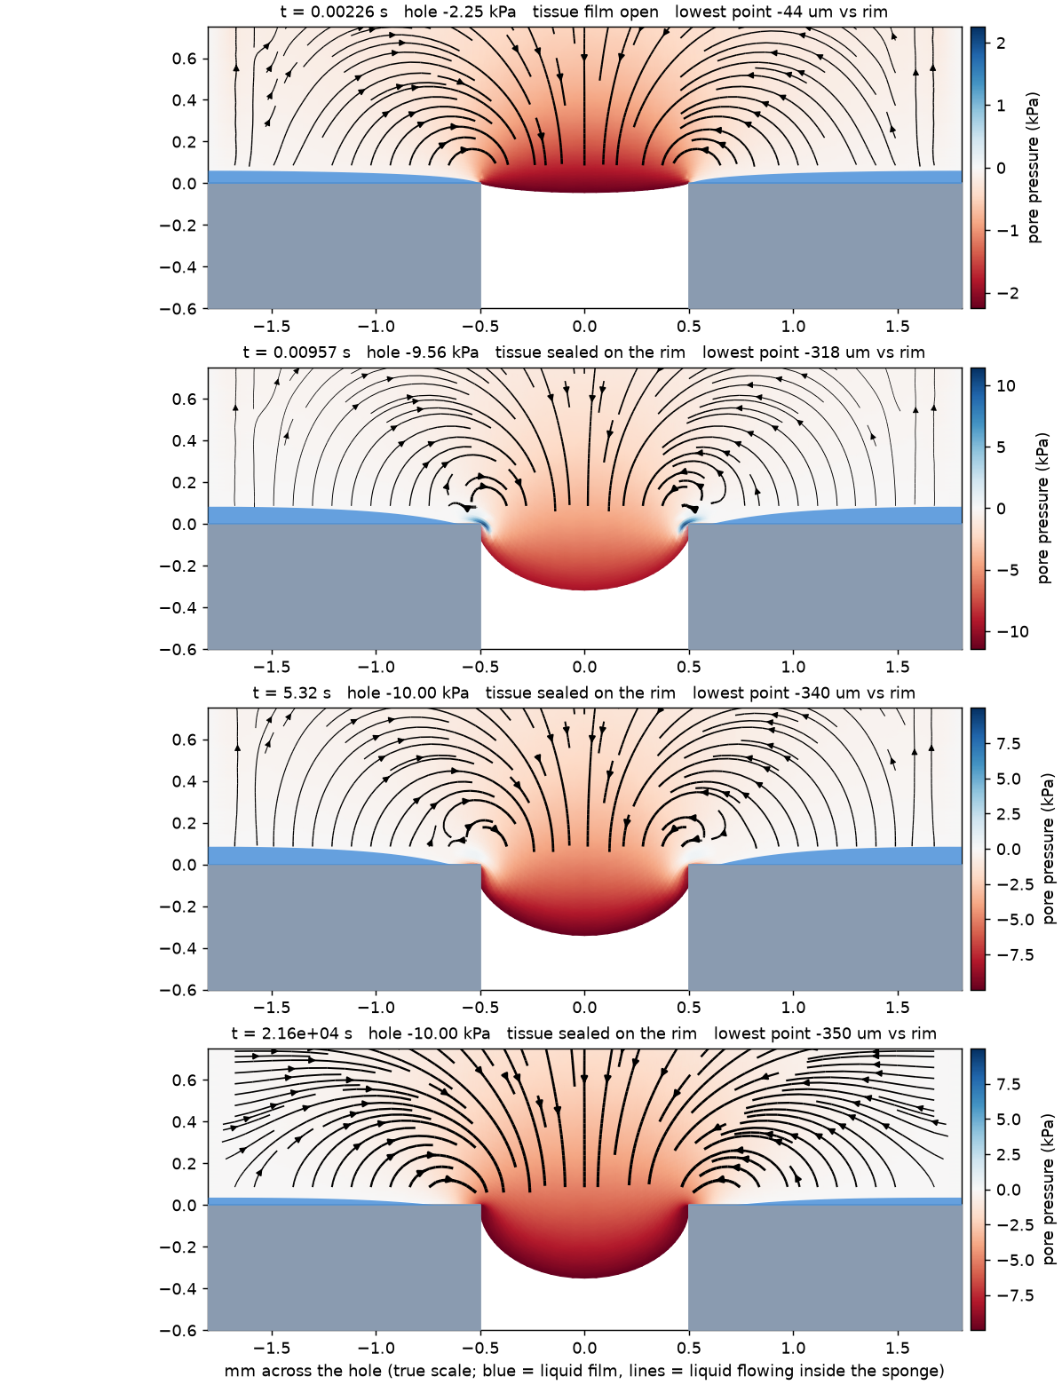
visualization/06_fields_current_open.png
