IasonKa/drain/visualization/06_fields_standoff_closed.png

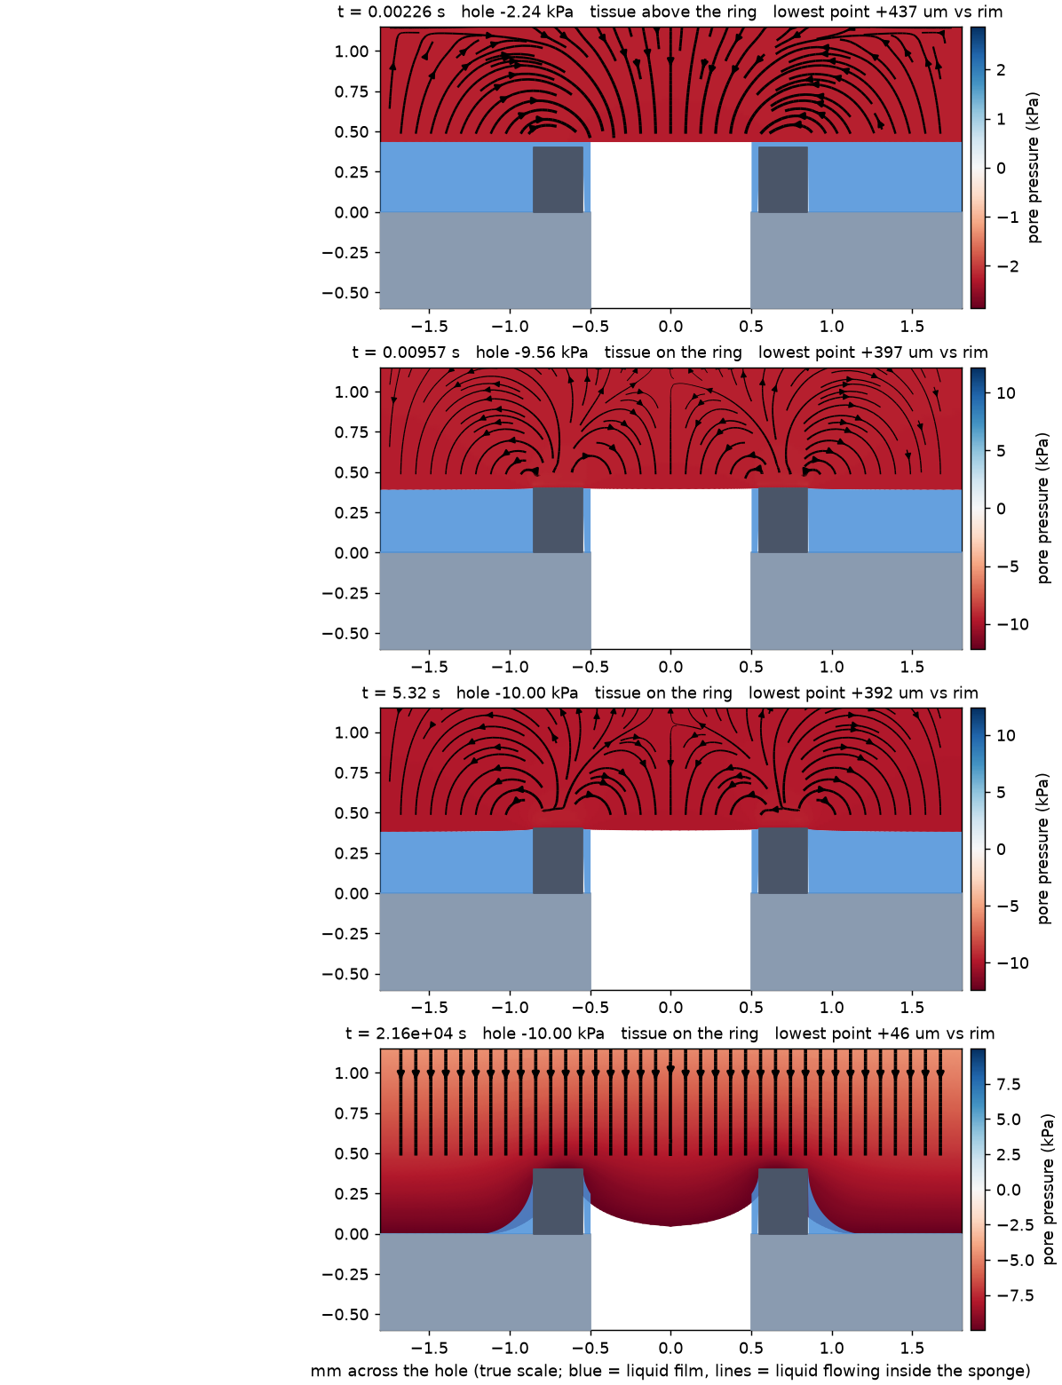
visualization/06_fields_standoff_closed.png
