IasonKa/drain/visualization/06_fields_standoff_open.png

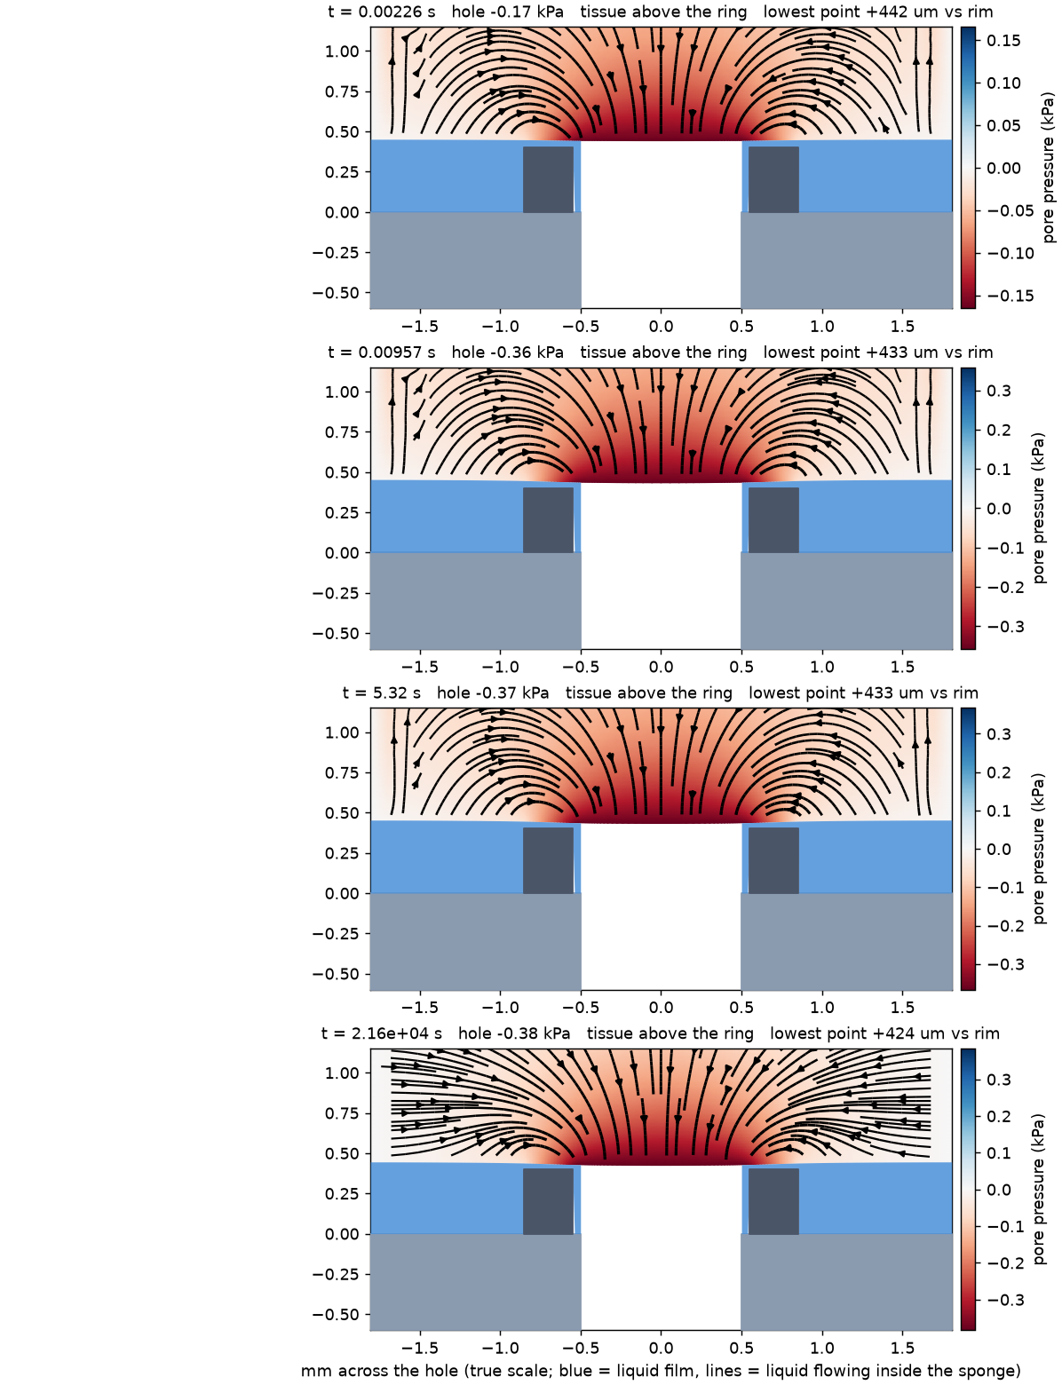
visualization/06_fields_standoff_open.png
