IasonKa/drain/visualization/07_parameter_map.png

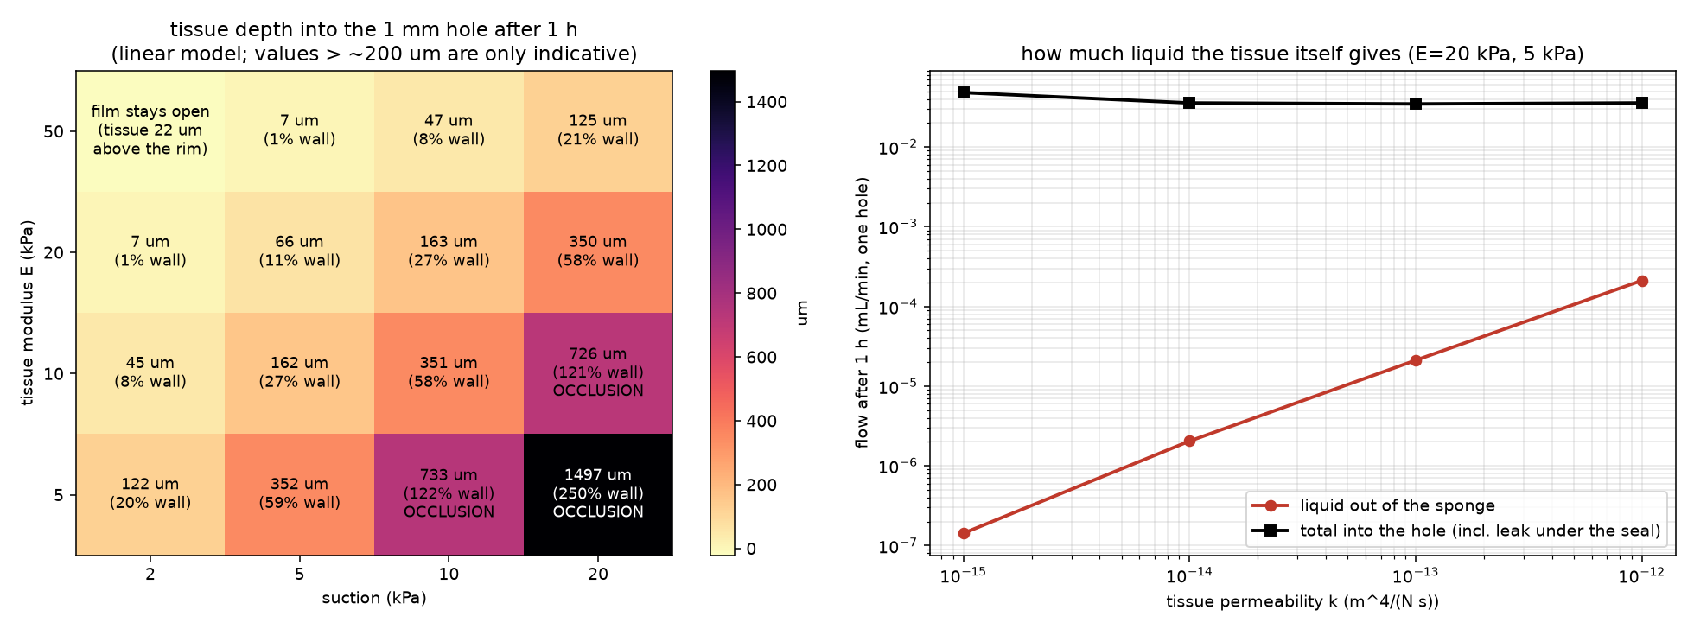
visualization/07_parameter_map.png
