IasonKa/drain/visualization/08_standoff_screening.png

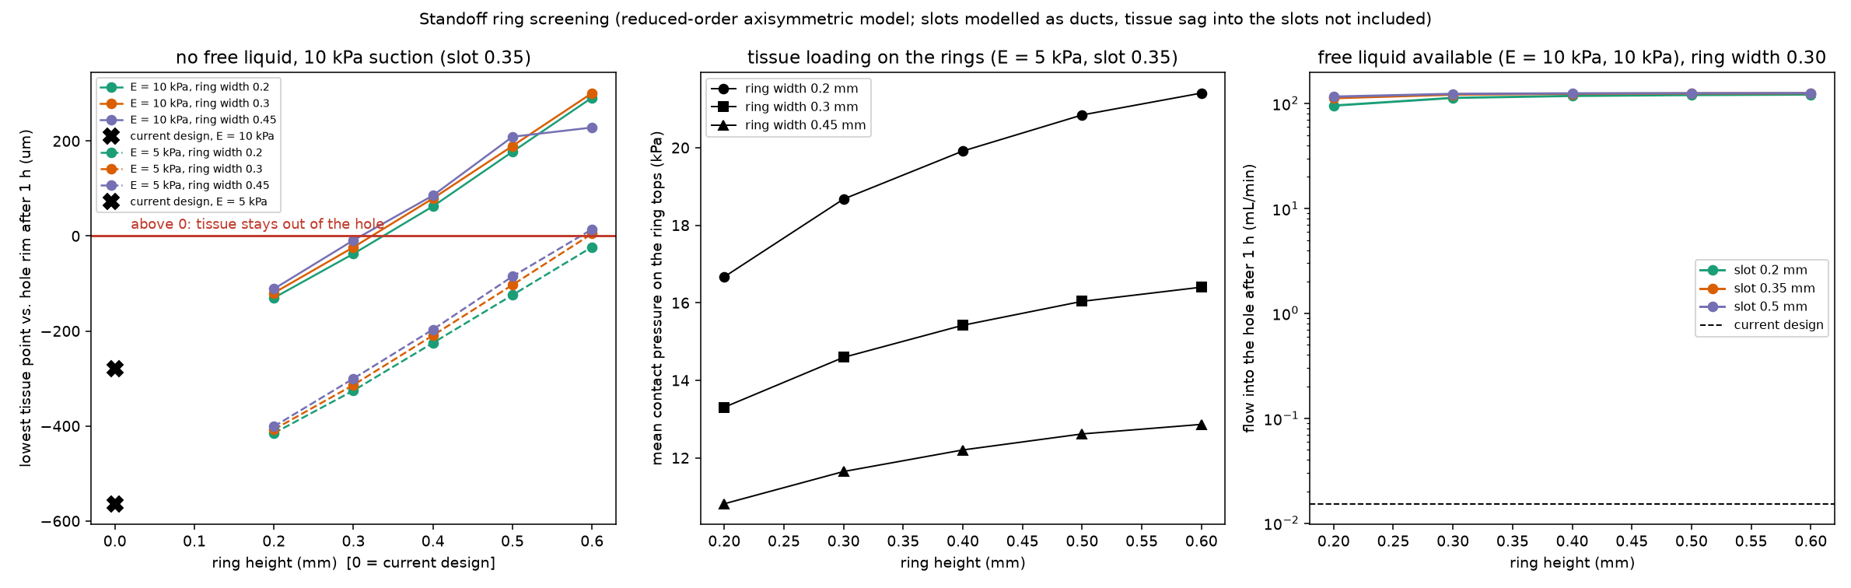
visualization/08_standoff_screening.png
