IasonKa/drain/visualization/09_design_comparison.png

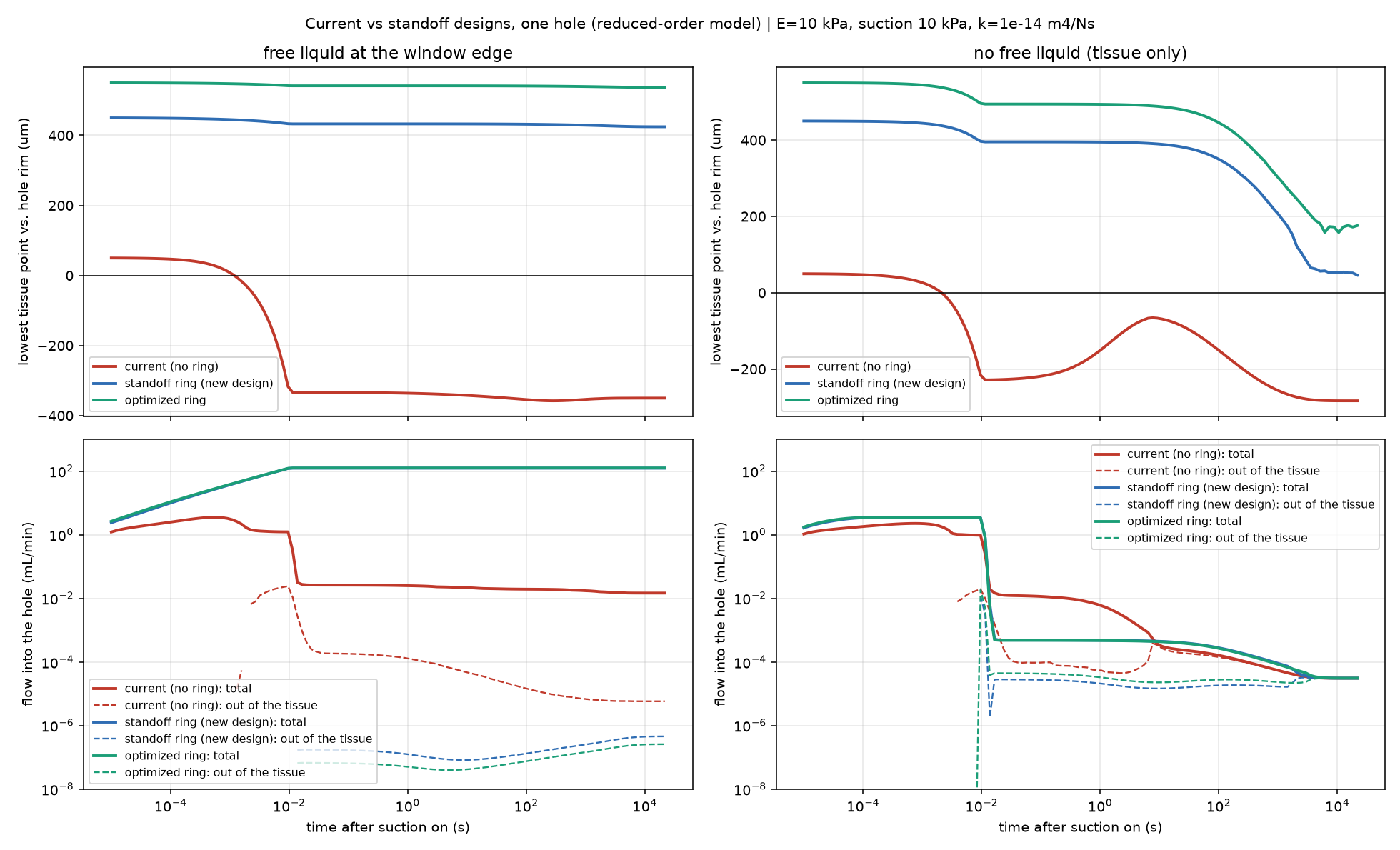
visualization/09_design_comparison.png
