IasonKa/drain/visualization/in_body/in_body_3d.png

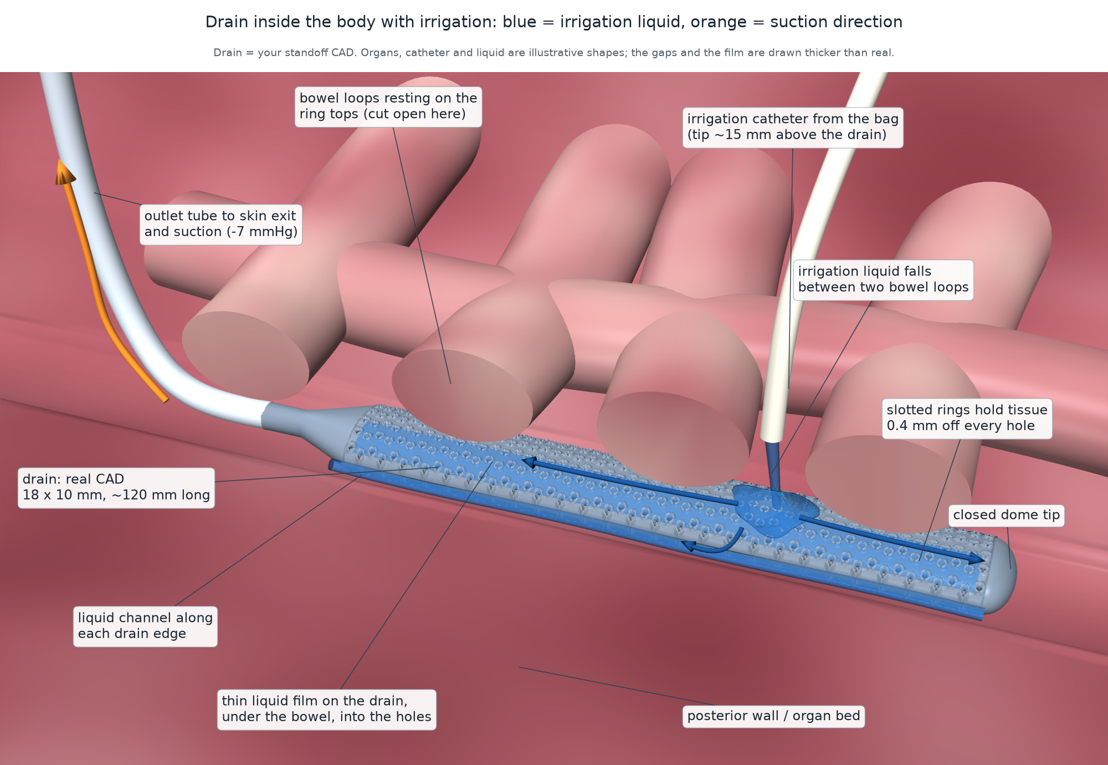
visualization/in_body/in_body_3d.png
