IasonKa/drain/visualization/in_body/in_body_3d_packed.png

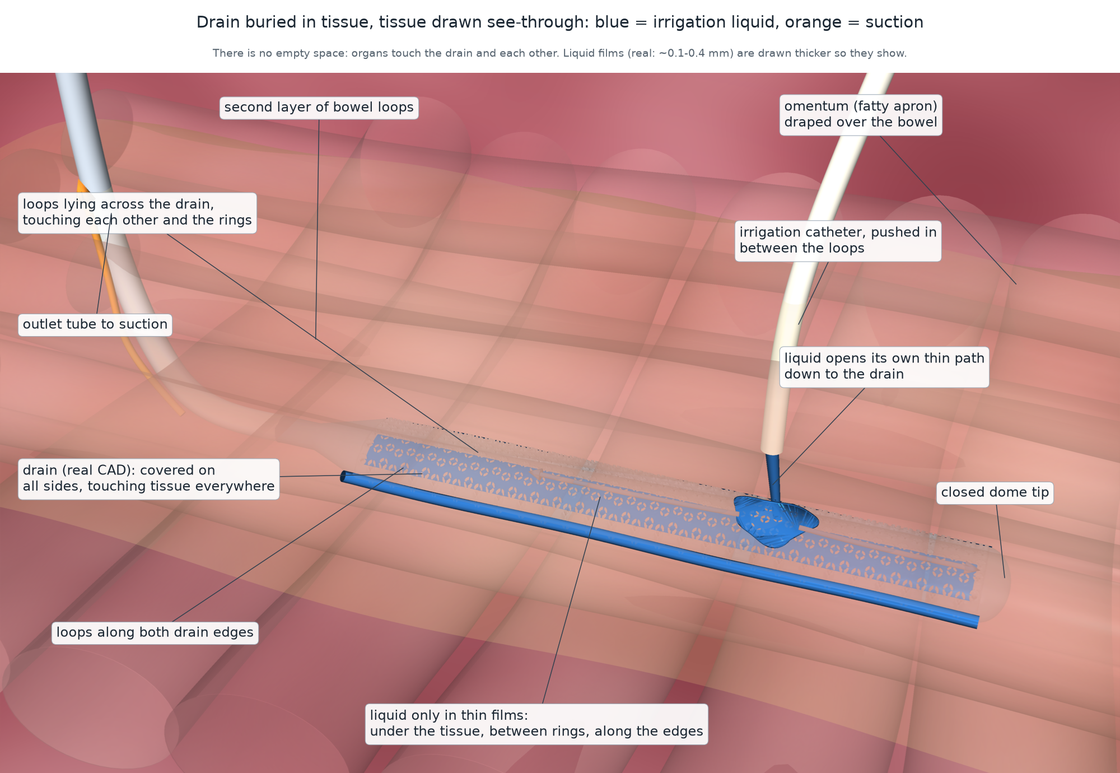
visualization/in_body/in_body_3d_packed.png
