IasonKa/drain/visualization/render_3d_current_closed_end.png

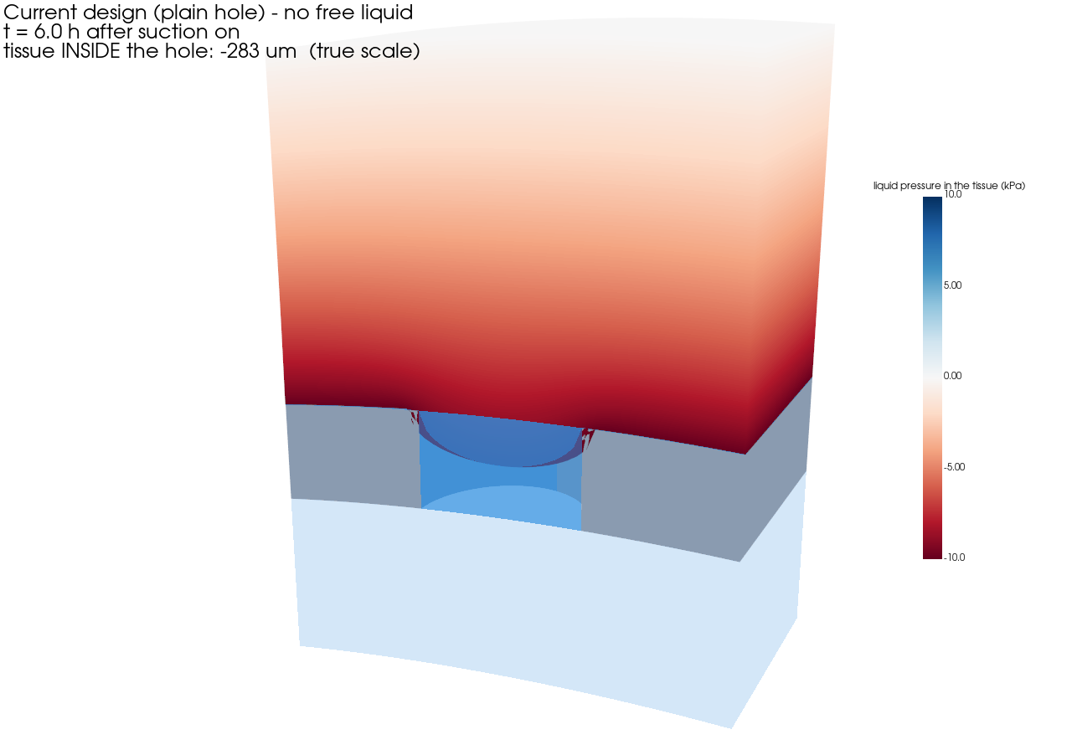
visualization/render_3d_current_closed_end.png
