IasonKa/drain/visualization/render_3d_standoff_closed_end.png

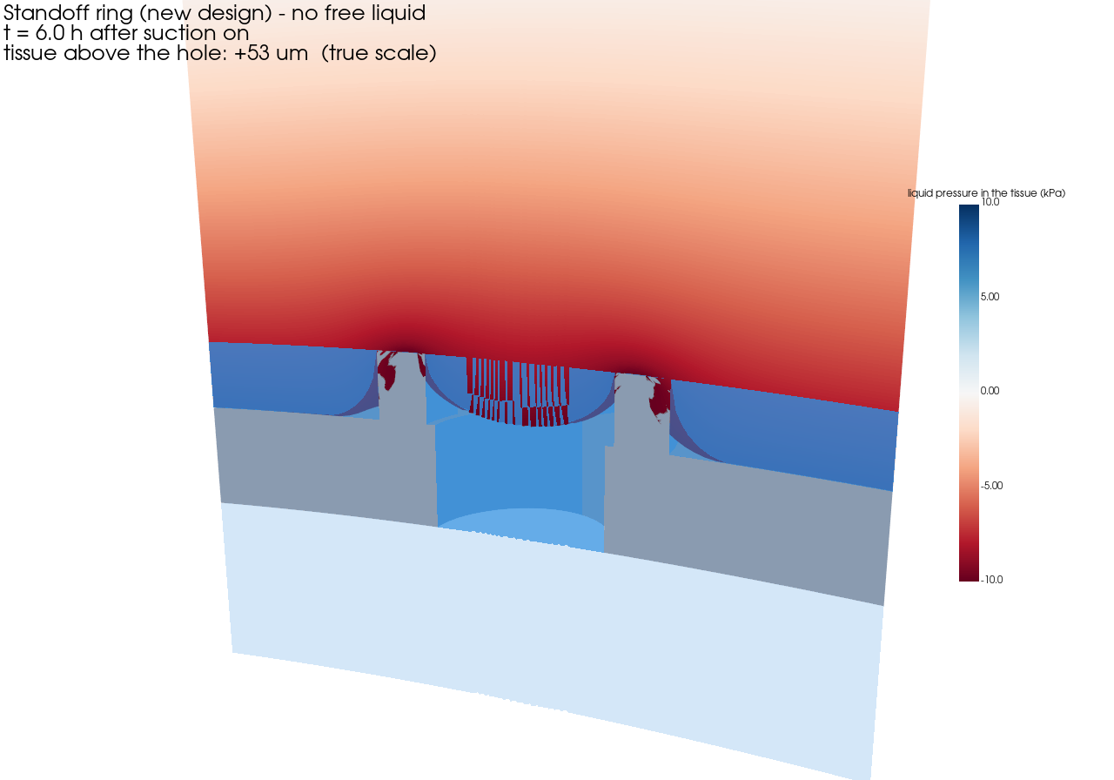
visualization/render_3d_standoff_closed_end.png
