IasonKa/drain/visualization/render_closeup_organ_seethrough_current.png

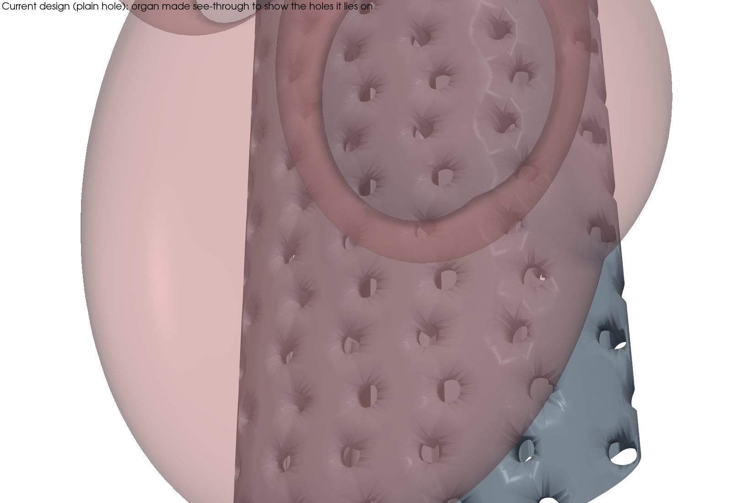
visualization/render_closeup_organ_seethrough_current.png
