IasonKa/drain/visualization/render_cut_open_current.png

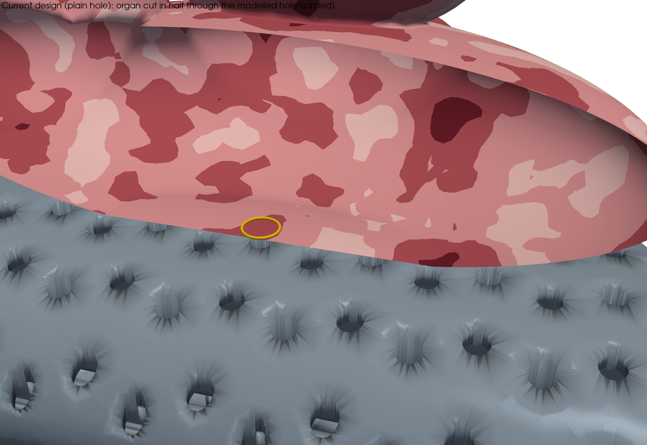
visualization/render_cut_open_current.png
