IasonKa/drain/visualization/render_cut_open_standoff.png

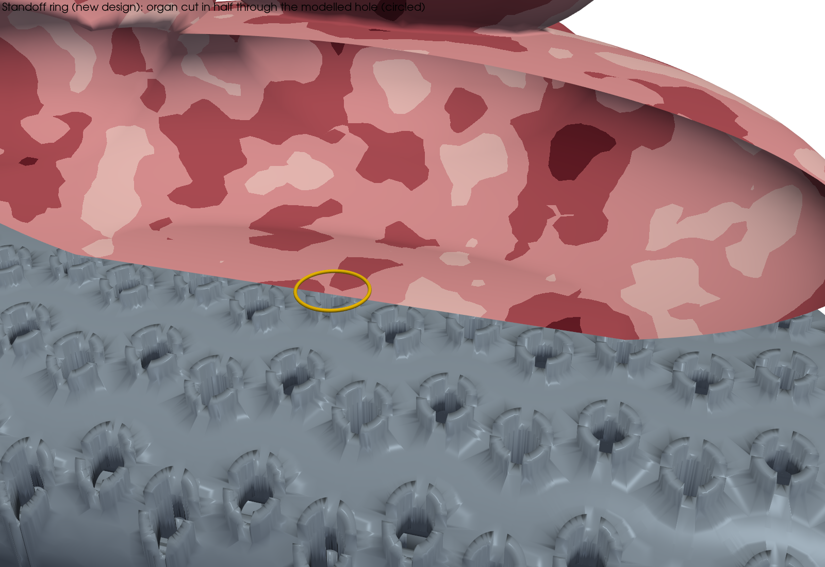
visualization/render_cut_open_standoff.png
