IasonKa/drain/visualization/render_drain_surface_current.png

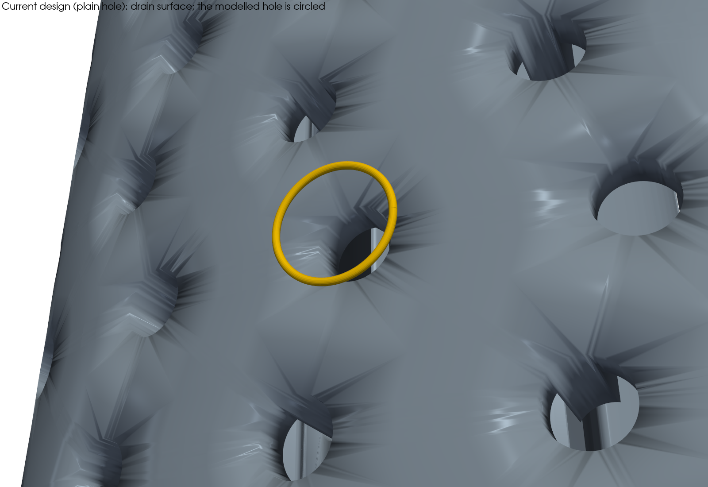
visualization/render_drain_surface_current.png
