IasonKa/drain/visualization/render_drain_surface_standoff.png

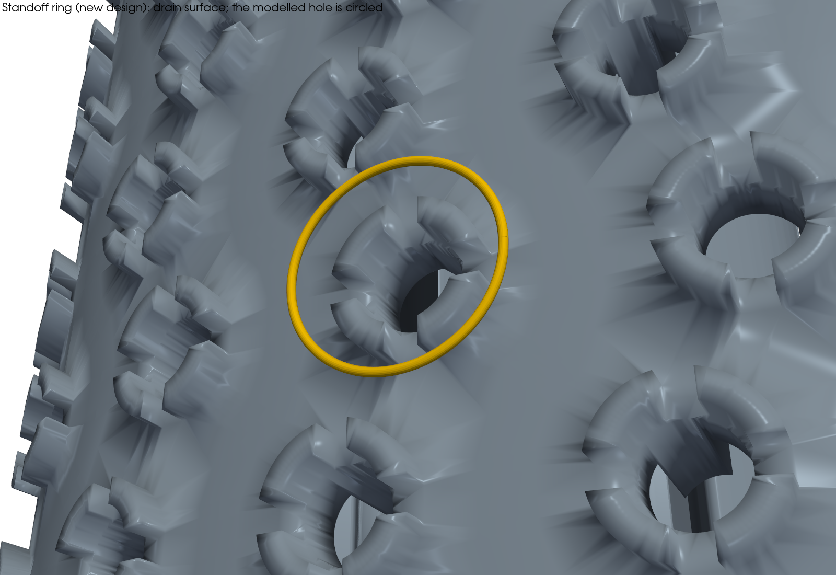
visualization/render_drain_surface_standoff.png
