IasonKa/drain/visualization/video_cross_section_closed.gif

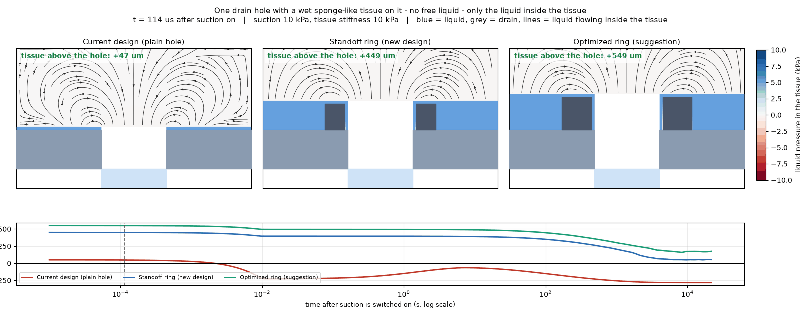
visualization/video_cross_section_closed.gif
