IasonKa/drain/visualization/video_cross_section_closed_last_frame.png

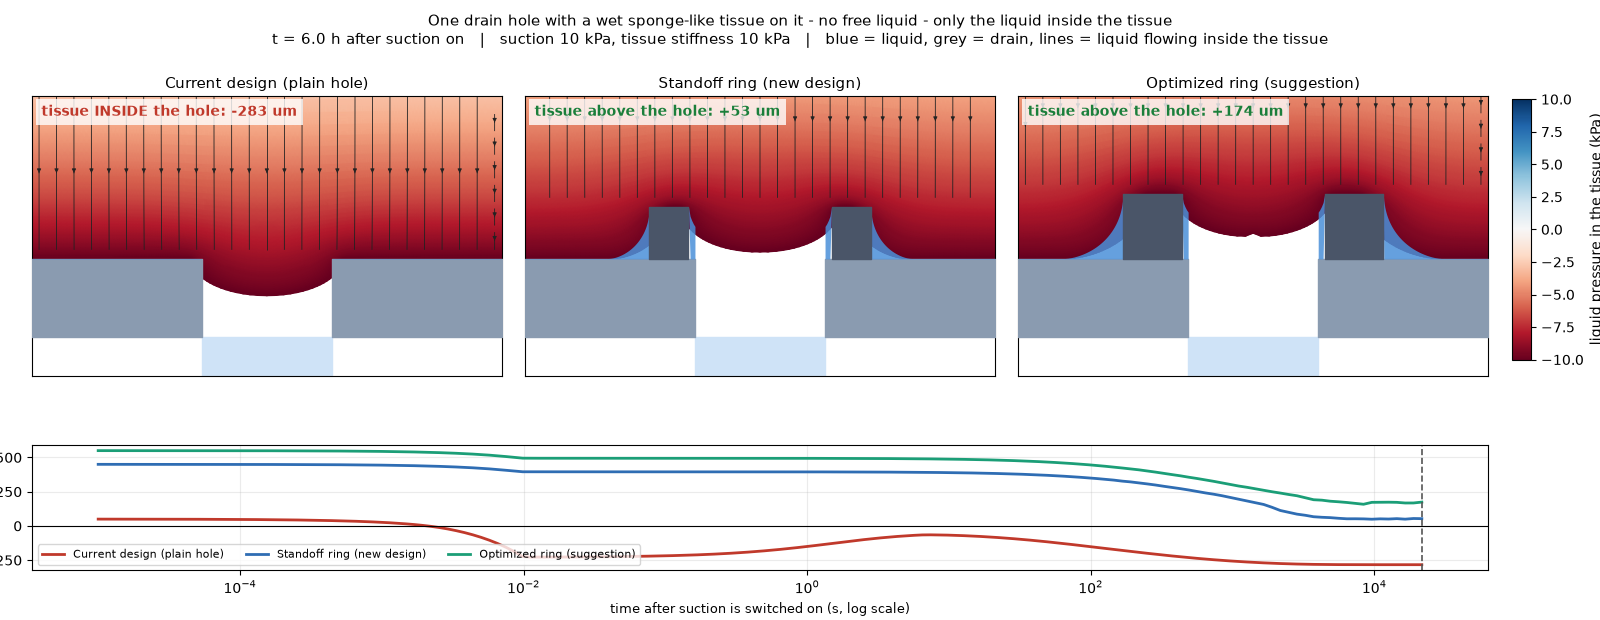
visualization/video_cross_section_closed_last_frame.png
