IasonKa/drain/visualization/video_cross_section_open.gif

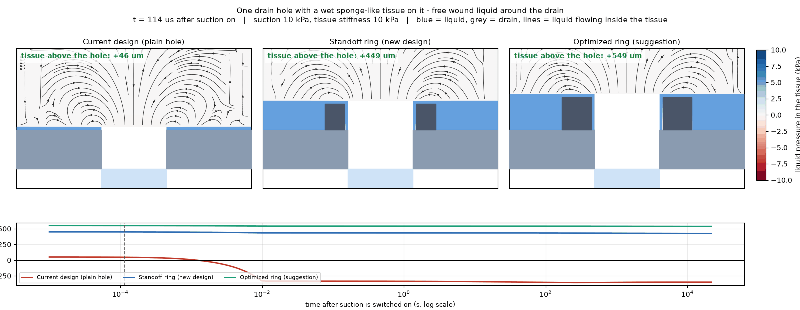
visualization/video_cross_section_open.gif
