IasonKa/drain/visualization/video_cross_section_open_last_frame.png

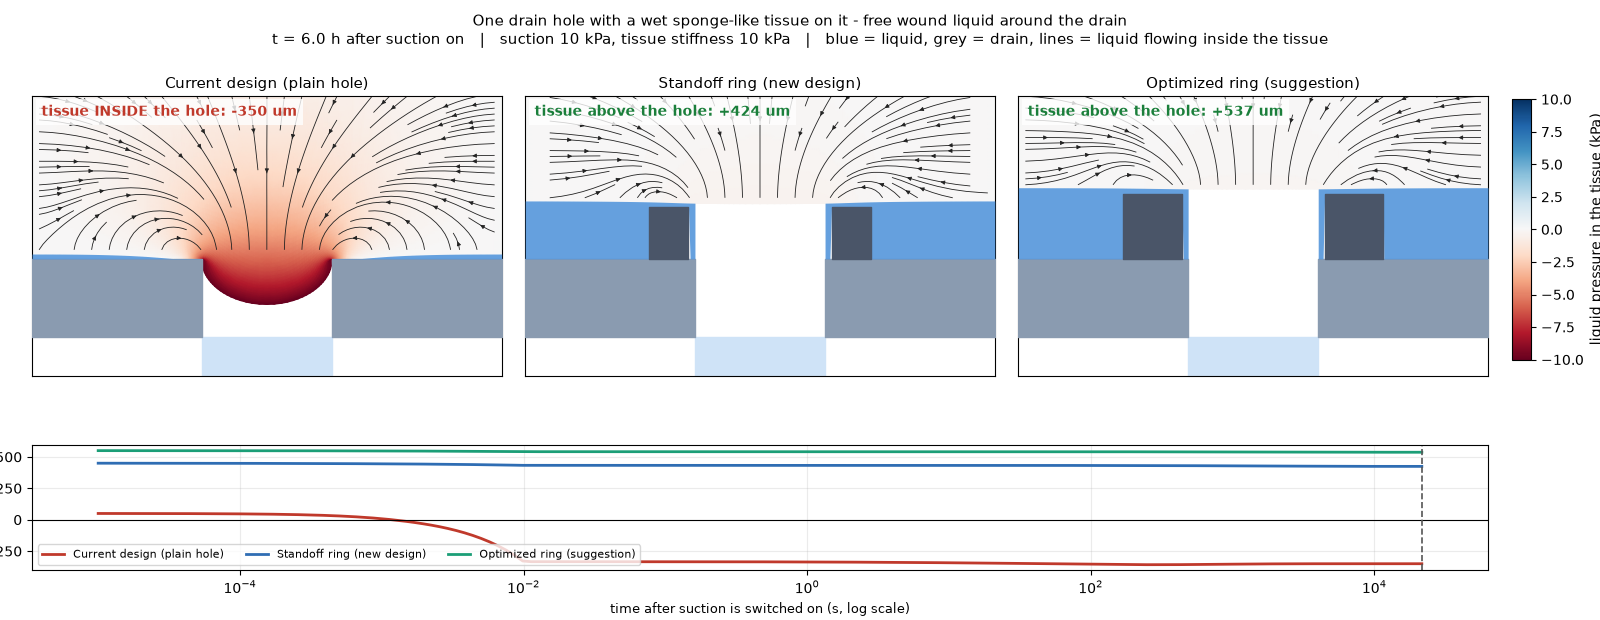
visualization/video_cross_section_open_last_frame.png
