IasonKa/drain/drainsponge/out/cad/current/window_assembly.step

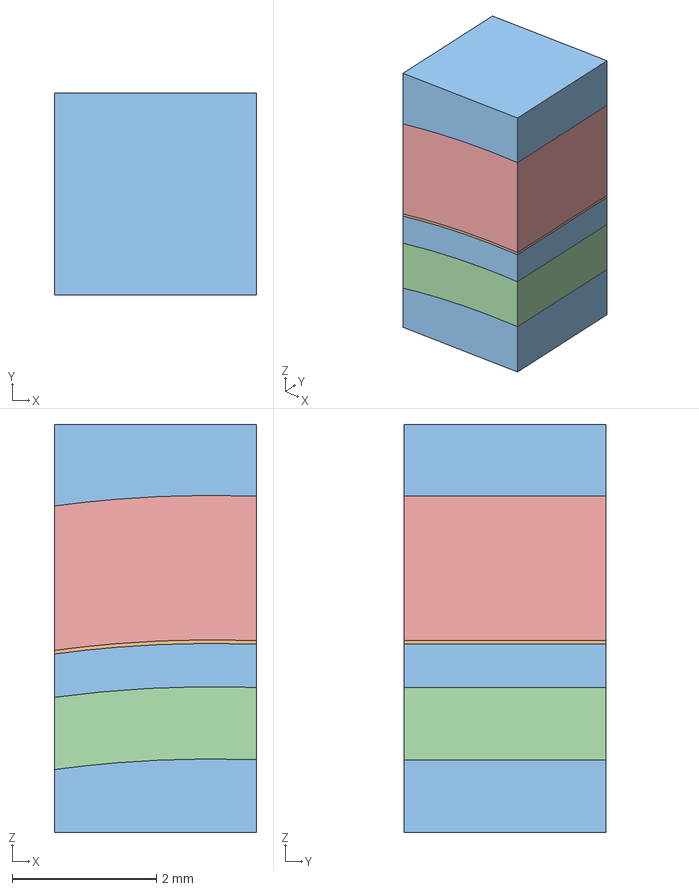
[picture p78: CAD file, 2026-10-14]
drainsponge/out/cad/current/window_assembly.step
2.80 x 2.80 x 5.65 mm
