IasonKa/drain/drainsponge/out/cad/standoff/window_assembly.step

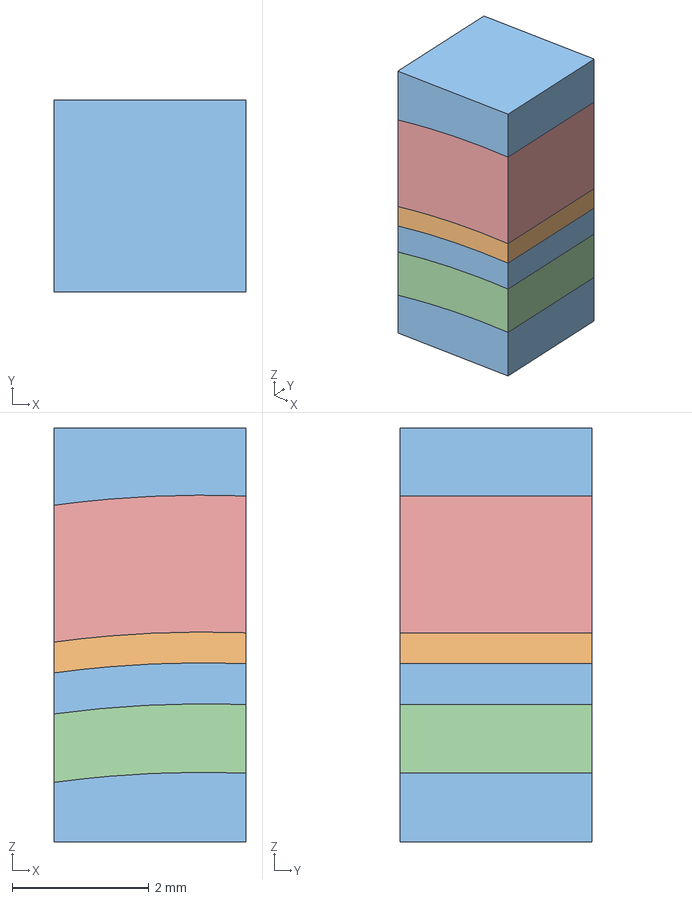
[picture p79: CAD file, 2026-10-14]
drainsponge/out/cad/standoff/window_assembly.step
2.80 x 2.80 x 6.05 mm
