IasonKa/drain/drainsponge/out/cad/standoff_opt/window_channel.step

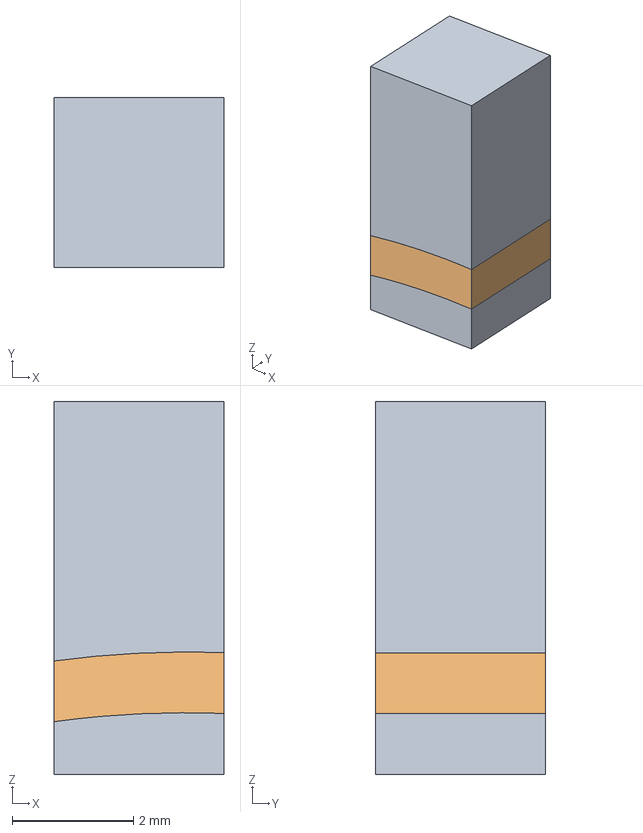
[picture p82: CAD file, 2026-10-14]
drainsponge/out/cad/standoff_opt/window_channel.step
2.80 x 2.80 x 6.15 mm
