IasonKa/drain/drainsponge/out/cad/current/window_tissue.step

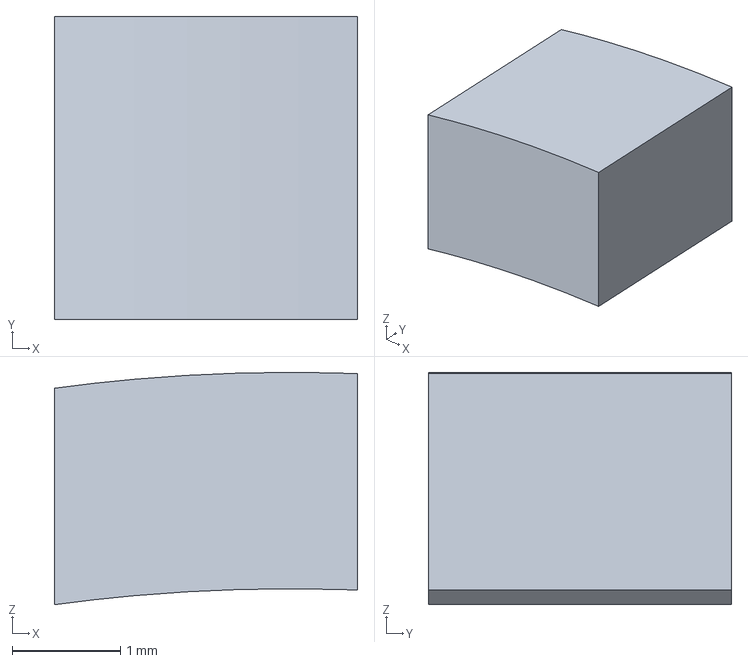
[picture p83: CAD file, 2026-10-14]
drainsponge/out/cad/current/window_tissue.step
2.80 x 2.80 x 2.15 mm
