IasonKa/drain/drainsponge/out/cad/standoff_opt/window_drain.step

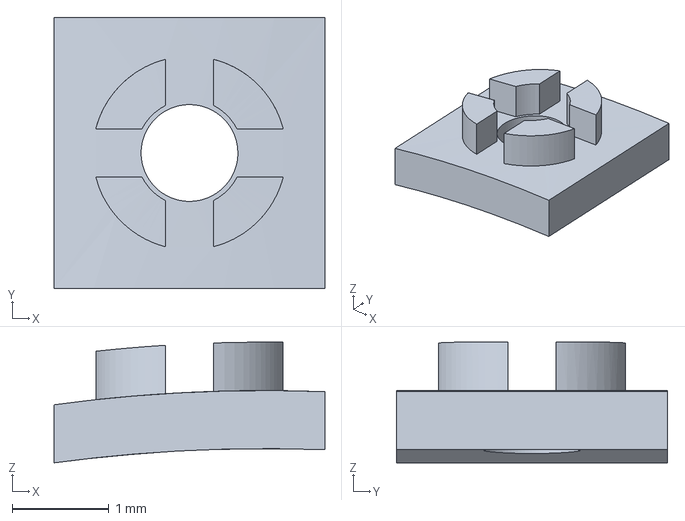
[picture p84: CAD file, 2026-10-14]
drainsponge/out/cad/standoff_opt/window_drain.step
2.80 x 2.80 x 1.25 mm
