IasonKa/drain/drainsponge/out/cad/current/window_channel.step

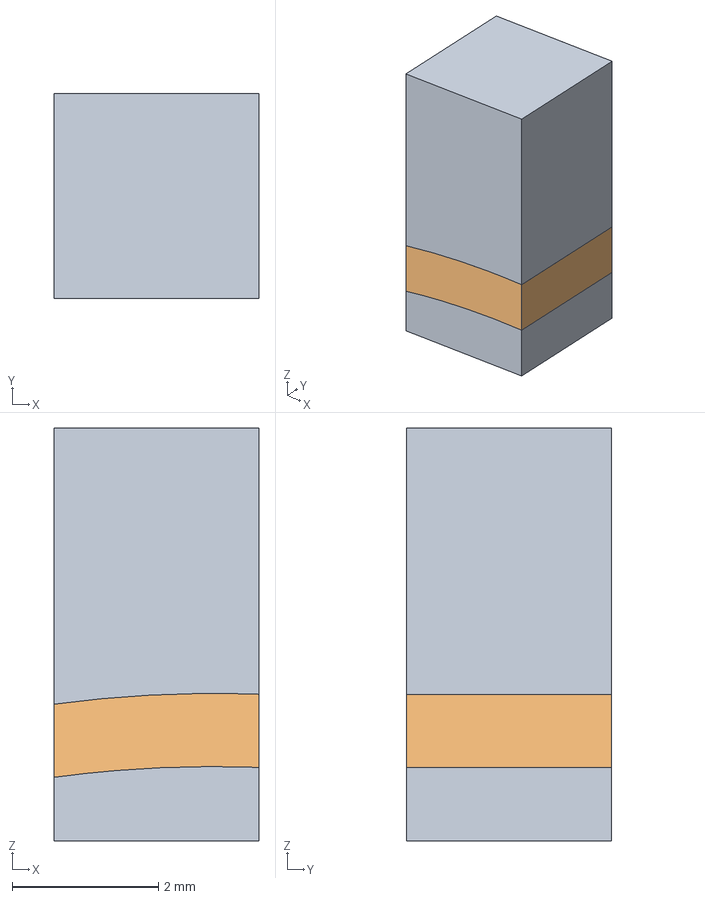
[picture p85: CAD file, 2026-10-14]
drainsponge/out/cad/current/window_channel.step
2.80 x 2.80 x 5.65 mm
