IasonKa/drain/drainsponge/out/cad/standoff/window_film.step

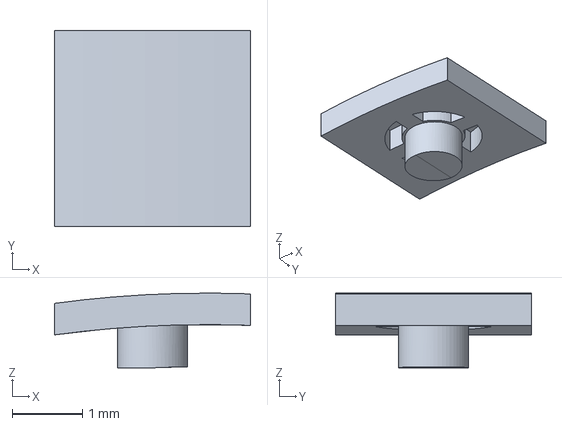
[picture p86: CAD file, 2026-10-14]
drainsponge/out/cad/standoff/window_film.step
2.80 x 2.80 x 1.07 mm
