IasonKa/drain/drainsponge/out/cad/standoff_opt/organ_sponge_global.step

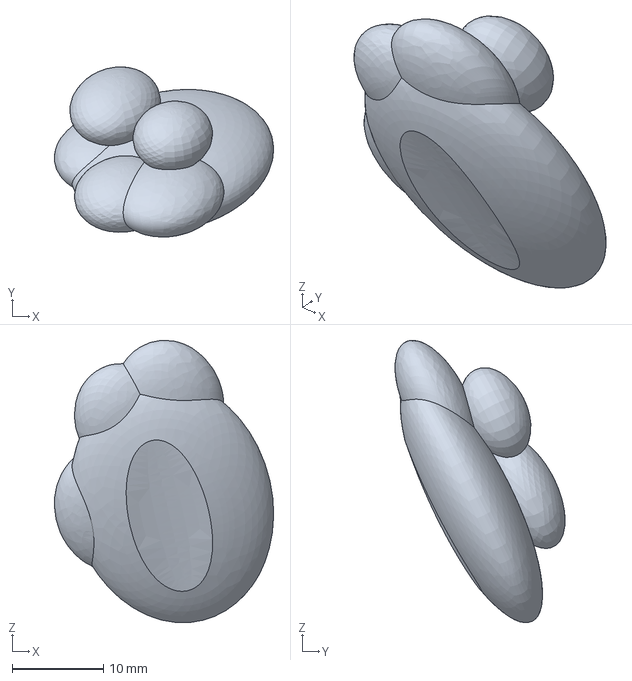
[picture p87: CAD file, 2026-10-14]
drainsponge/out/cad/standoff_opt/organ_sponge_global.step
24.1 x 18.7 x 31.0 mm
