IasonKa/drain/drainsponge/out/cad/standoff/window_film_tissue_global.step

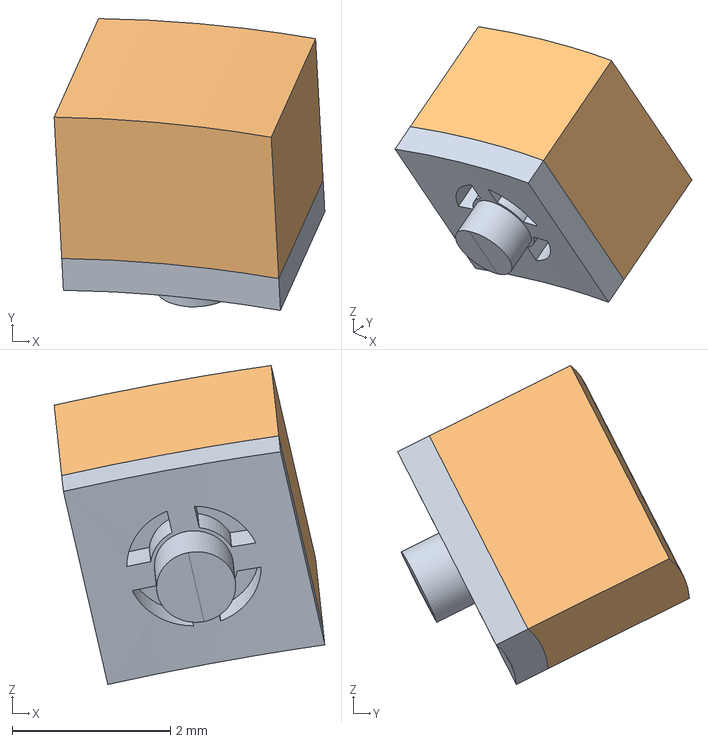
[picture p88: CAD file, 2026-10-14]
drainsponge/out/cad/standoff/window_film_tissue_global.step
3.43 x 3.69 x 4.04 mm
