IasonKa/drain/drainsponge/out/cad/current/window_film.step

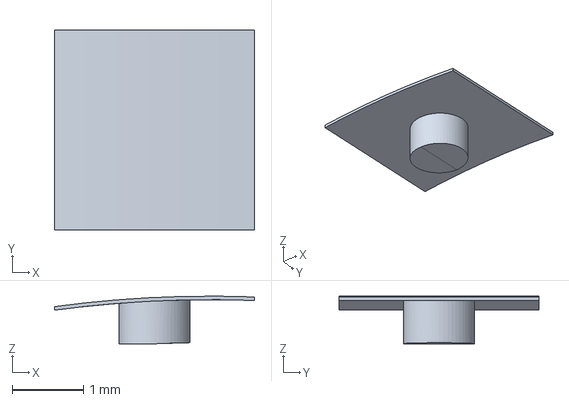
[picture p89: CAD file, 2026-10-14]
drainsponge/out/cad/current/window_film.step
2.80 x 2.80 x 0.668 mm
