IasonKa/drain/drainsponge/out/cad/current/window_film_tissue_global.step

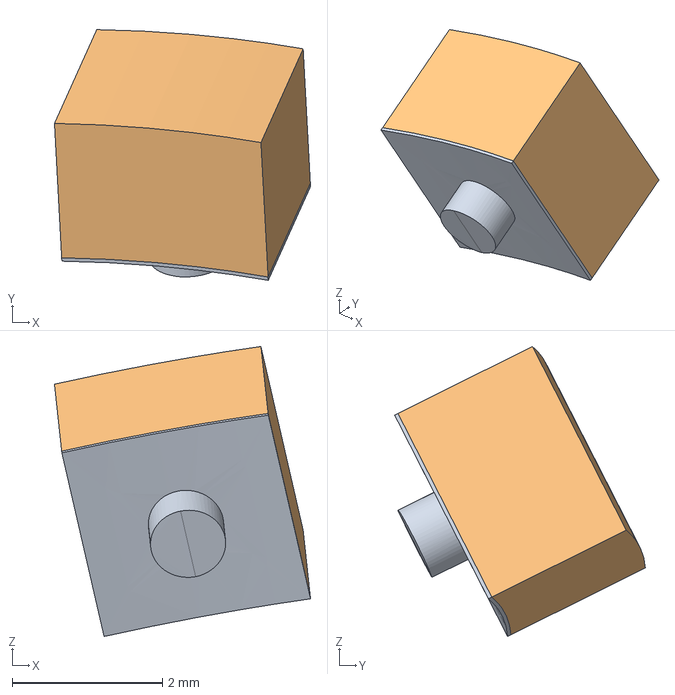
[picture p90: CAD file, 2026-10-14]
drainsponge/out/cad/current/window_film_tissue_global.step
3.41 x 3.34 x 3.86 mm
