IasonKa/drain/drainsponge/out/cad/current/window_drain.step

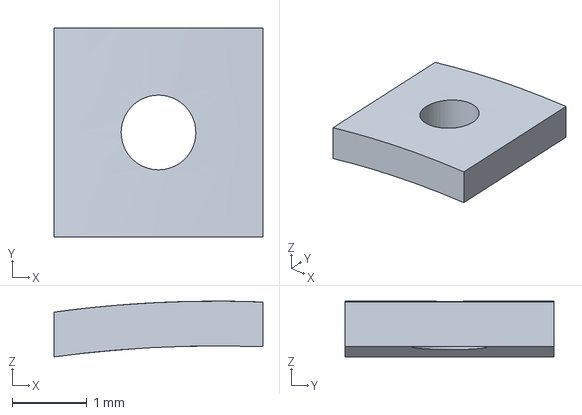
[picture p92: CAD file, 2026-10-14]
drainsponge/out/cad/current/window_drain.step
2.80 x 2.80 x 0.747 mm
