IasonKa/drain/drainsponge/out/cad/standoff_opt/window_film_tissue_global.step

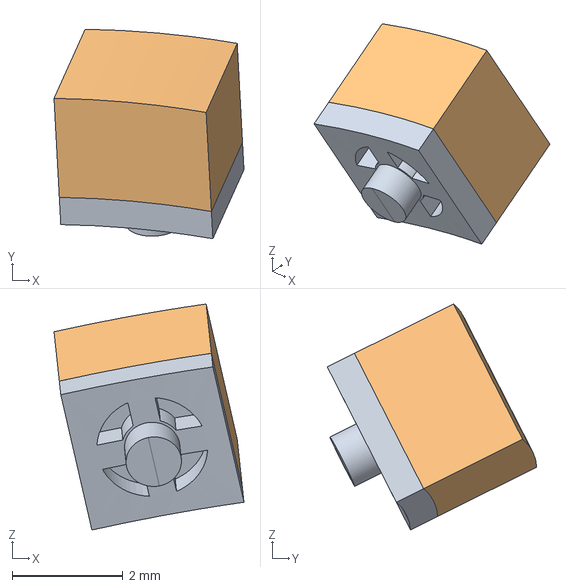
[picture p93: CAD file, 2026-10-14]
drainsponge/out/cad/standoff_opt/window_film_tissue_global.step
3.43 x 3.78 x 4.08 mm
