IasonKa/drain/(list of files, cad)

Other CAD files:
drainsponge/out/cad/standoff/window_tissue.step
drainsponge/out/cad/current/organ_sponge_global.step
drainsponge/out/cad/standoff_opt/window_tissue.step
drainsponge/out/cad/standoff/organ_sponge_global.step
drainsponge/out/cad/standoff/window_drain.step
