IasonKa/drain/drainstop/vof/kratos/results/usz_tilt10_h21_coarse/setup_mesh.png

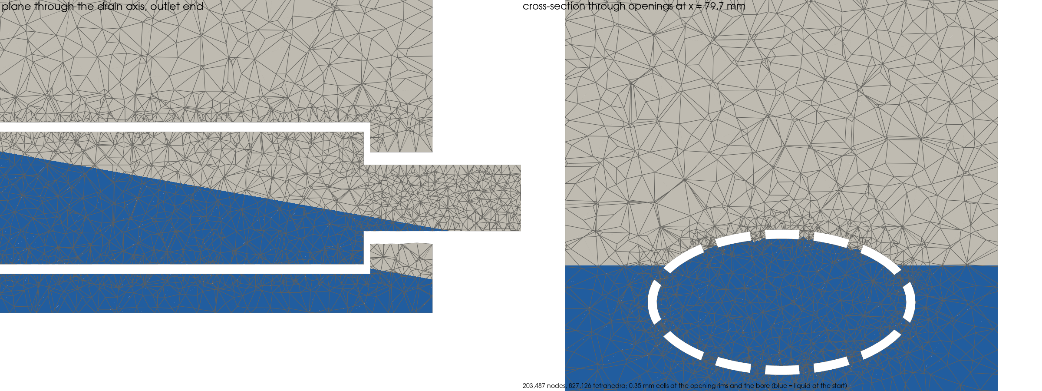
drainstop/vof/kratos/results/usz_tilt10_h21_coarse/setup_mesh.png
