IasonKa/drain/visualization/in_body/in_body_setup.png

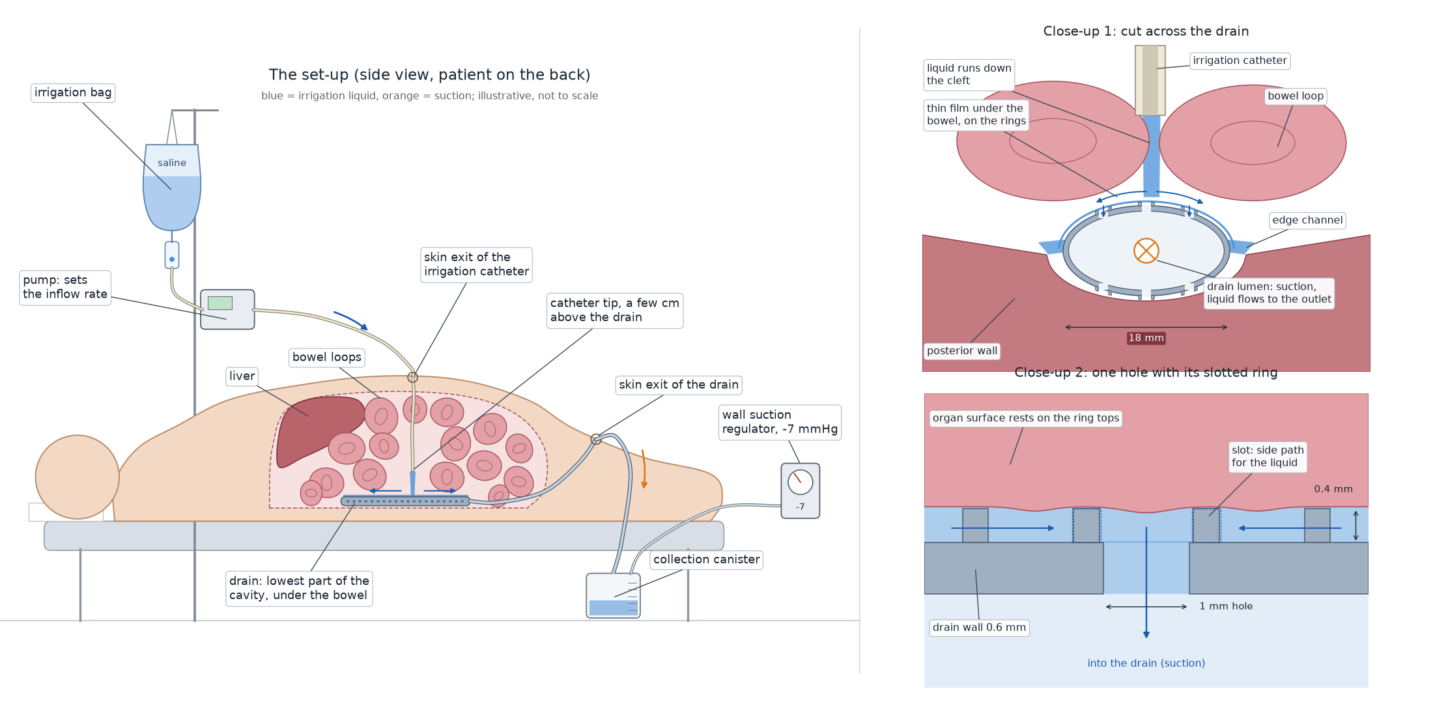
visualization/in_body/in_body_setup.png
