IasonKa/drain/drainstop/paper/generated/tab_validation.tex

\begin{tabular}{@{}l r r r r r@{}}
\toprule
design & $\alpha$ & closed form & network & time-dependent & lowest hole edge \\
 & & Eq.~\eqref{eq:stop-refined} & (quasi-static) & simulation & $h_{geo}$ \\
\midrule
Recommended & $0^\circ$ & 0.51 & 0.52 & 0.51 & 0.53 \\
Recommended & $10^\circ$ & 1.35 & 1.36 & 1.36 & 1.37 \\
USZ as built & $0^\circ$ & 2.29 & 2.21 & 2.21 & 0.01 \\
USZ as built & $10^\circ$ & 20.13 & 19.97 & 19.97 & 0.11 \\
Side rows & $0^\circ$ & 4.35 & 4.37 & 4.36 & 4.37 \\
Side rows & $10^\circ$ & 5.67 & 5.67 & 5.67 & 5.69 \\
Four rows & $0^\circ$ & 0.00 & 0.00 & 0.00 & 0.01 \\
Four rows & $10^\circ$ & 1.81 & 1.83 & 1.82 & 1.83 \\
\bottomrule
\end{tabular}
