IasonKa/drain/drainstop/vof/kratos/results/rec_tilt10_h8/monitor.csv

t | dt | Q_total | Q_liquid | wall_s | p0 | p1 | p2 | p3 | p4 | p5 | p6 | p7 | d0 | d1 | d2 | d3 | d4 | d5 | d6 | d7
5e-05 | 5e-05 | 3.79953e-07 | 0 | 165.304 | -25.5917 | -75.3086 | -147.369 | -610.024 | -910.074 | -912.111 | -897.755 | -922.829 | -1 | -1 | -0.00752804 | -0.000855526 | 0.00300391 | 0.00146628 | -0.000868903 | 0.001744
0.0001 | 5e-05 | 7.94017e-07 | 0 | 22.5656 | -29.4931 | -83.4557 | -173.78 | -617.802 | -913.005 | -914.996 | -903.754 | -924.741 | -1 | -1 | -0.00752819 | -0.00085535 | 0.00300386 | 0.00146626 | -0.000868902 | 0.00174397
0.00015 | 5e-05 | 1.22424e-06 | 0 | 25.7158 | -31.0753 | -86.7022 | -181.552 | -616.529 | -912.624 | -914.642 | -902.191 | -924.553 | -1 | -1 | -0.00752858 | -0.000854959 | 0.00300375 | 0.00146622 | -0.000868904 | 0.00174392
0.0002 | 5e-05 | 1.6614e-06 | 0 | 18.7415 | -32.5462 | -88.2586 | -182.753 | -611.072 | -912.357 | -914.397 | -902.013 | -924.44 | -1 | -1 | -0.00752923 | -0.000854337 | 0.00300359 | 0.00146617 | -0.000868912 | 0.00174381
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
