IasonKa/drain/drainstop/vof/kratos/results/usz_tilt10_h21_coarse/monitor.csv

t | dt | Q_total | Q_liquid | wall_s | p0 | p1 | p2 | p3 | p4 | p5 | p6 | p7 | d0 | d1 | d2 | d3 | d4 | d5 | d6 | d7
5e-05 | 5e-05 | 1.59067e-05 | 0 | 37.2058 | 114.898 | 66.74 | 19.1756 | -0.189051 | -38.6581 | -80.5859 | -92.9032 | -497.32 | -1 | -1 | -0.00164879 | -0.000540625 | 0.00283279 | 0.00247271 | -0.000927782 | 0.00259587
0.0001 | 5e-05 | 3.39705e-05 | 0 | 29.107 | 52.0025 | 12.2036 | 1.31736 | -11.3251 | -53.2953 | -100.685 | -125.541 | -498.23 | -1 | -1 | -0.00164873 | -0.000540592 | 0.00283349 | 0.00247226 | -0.000926903 | 0.00113451
0.00015 | 5e-05 | 4.85636e-05 | 0 | 36.5156 | 107.522 | 61.006 | 14.1179 | -5.86963 | -51.571 | -90.2747 | -109.233 | -390.598 | -1 | -1 | -0.00164866 | -0.000537986 | 0.00283404 | 0.00247256 | -0.000926018 | 0.00134181
0.0002 | 5e-05 | 5.874e-05 | 0 | 42.965 | 160.747 | 106.561 | 32.659 | 6.80713 | -42.2618 | -69.9901 | -81.551 | -274.174 | -1 | -1 | -0.00164864 | -0.000519404 | 0.00283469 | 0.00247186 | -0.000926112 | 0.00153977
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
