IasonKa/drain/drainstop/vof/kratos/results/rec_tilt10_h8/cut3d_orbit.gif

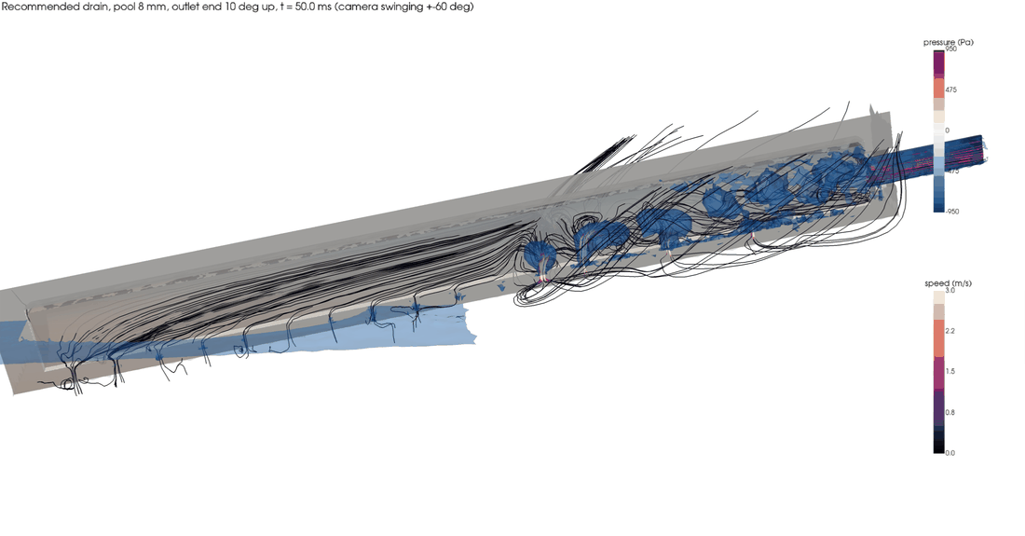
drainstop/vof/kratos/results/rec_tilt10_h8/cut3d_orbit.gif
