IasonKa/drain/drainstop/vof/kratos/results/rec_tilt10_h8/midplane.gif

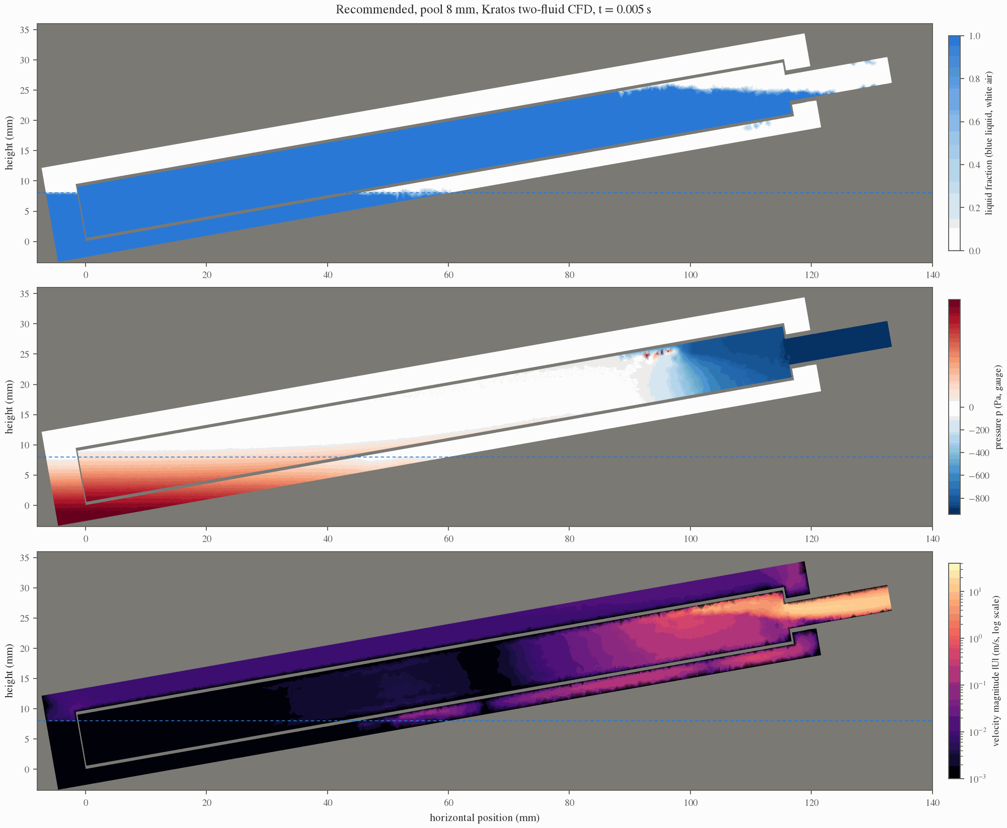
drainstop/vof/kratos/results/rec_tilt10_h8/midplane.gif
