IasonKa/drain/drainstop/vof/kratos/results/rec_tilt10_h8/openings.png

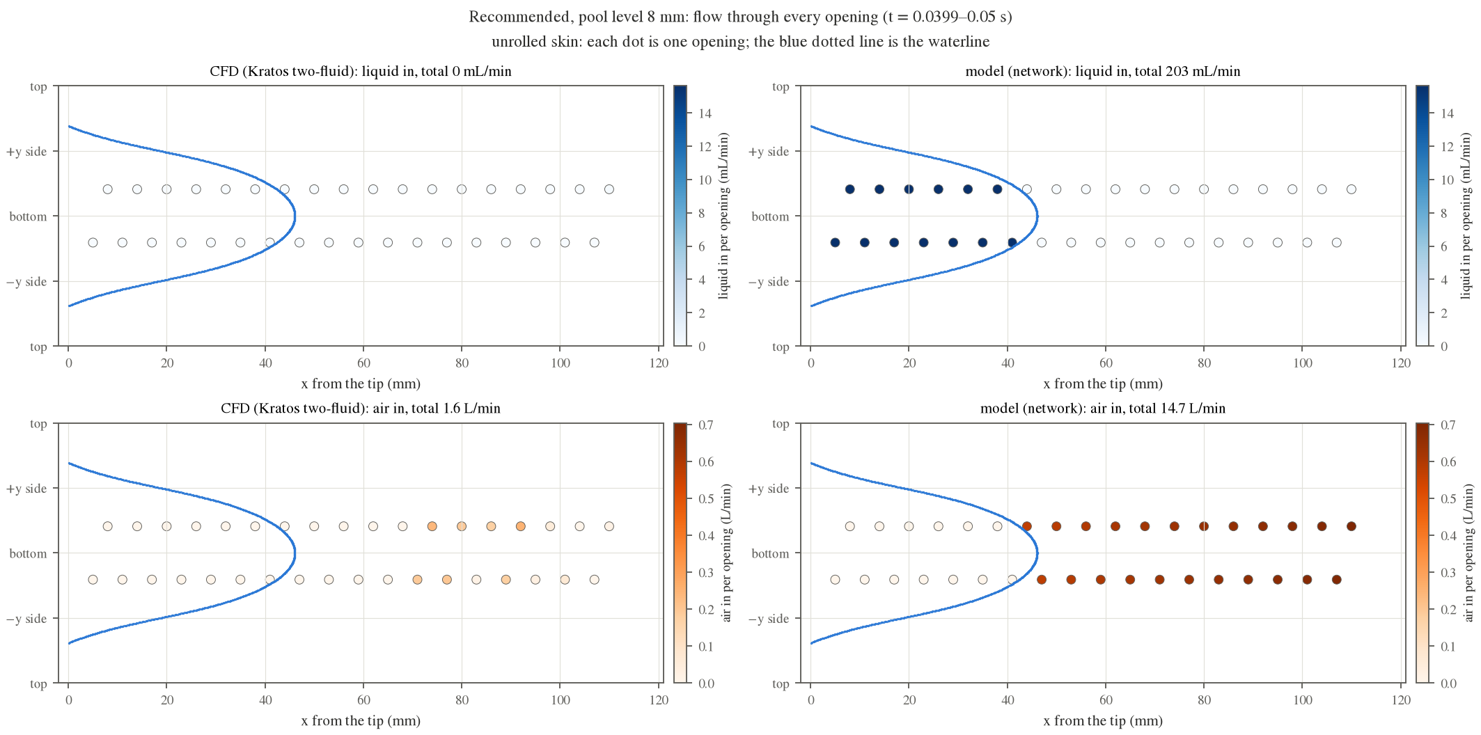
drainstop/vof/kratos/results/rec_tilt10_h8/openings.png
