IasonKa/drain/drainstop/vof/kratos/results/rec_tilt10_h8/outlet_end.png

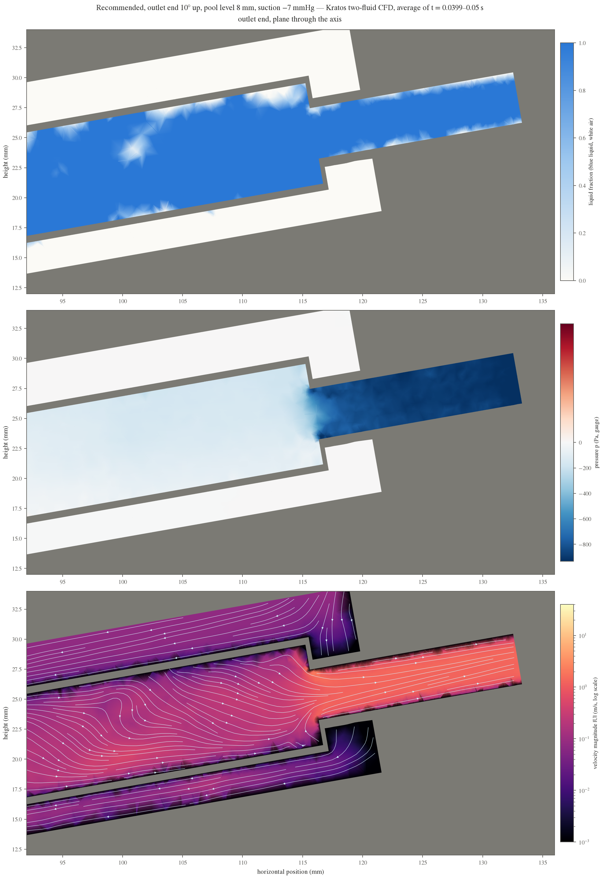
drainstop/vof/kratos/results/rec_tilt10_h8/outlet_end.png
