IasonKa/drain/drainstop/vof/kratos/results/rec_tilt10_h8/outlet_end_slow.gif

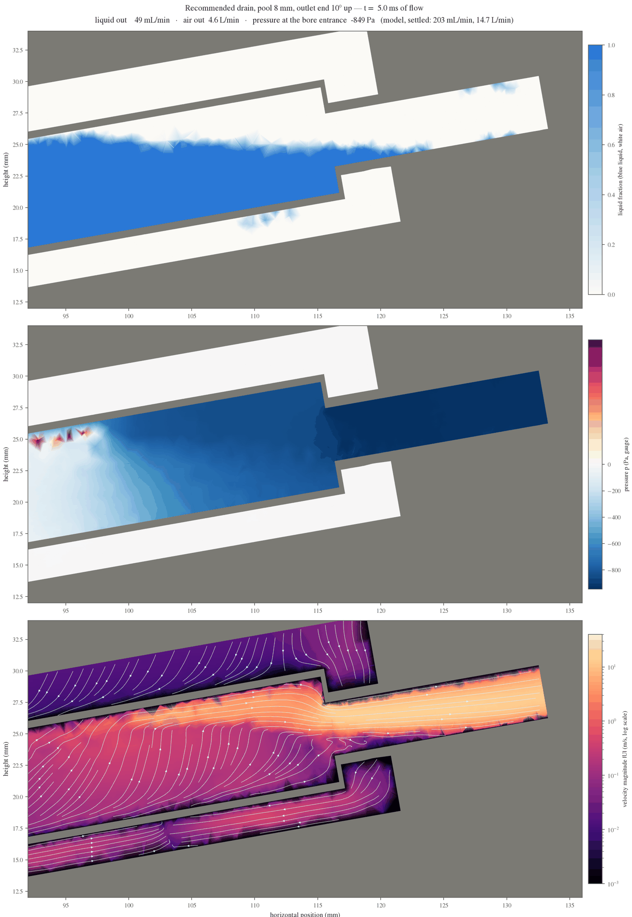
drainstop/vof/kratos/results/rec_tilt10_h8/outlet_end_slow.gif
