IasonKa/drain/drainstop/vof/kratos/results/rec_tilt10_h8/sections.png

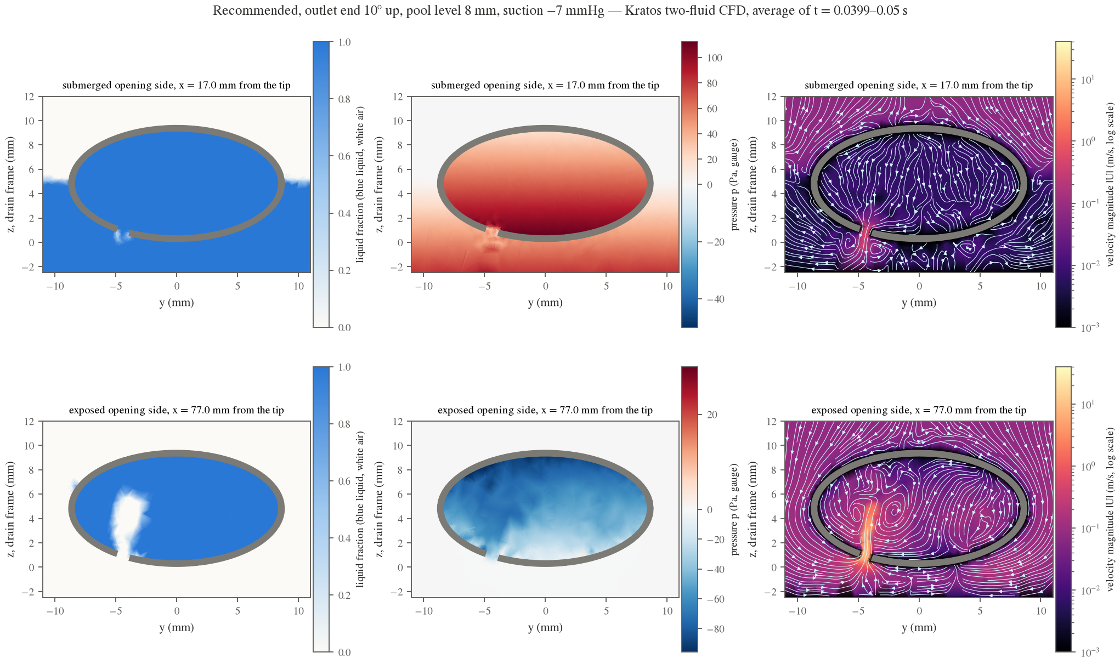
drainstop/vof/kratos/results/rec_tilt10_h8/sections.png
