IasonKa/drain/drainstop/vof/kratos/results/rec_tilt10_h8/view3d.png

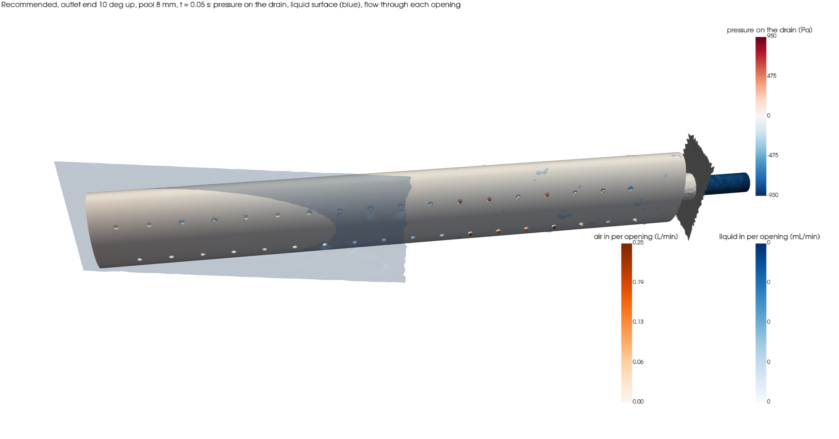
drainstop/vof/kratos/results/rec_tilt10_h8/view3d.png
