IasonKa/drain/drainstop/vof/kratos/results/usz_tilt10_h21_coarse/cut3d_005.0ms.png

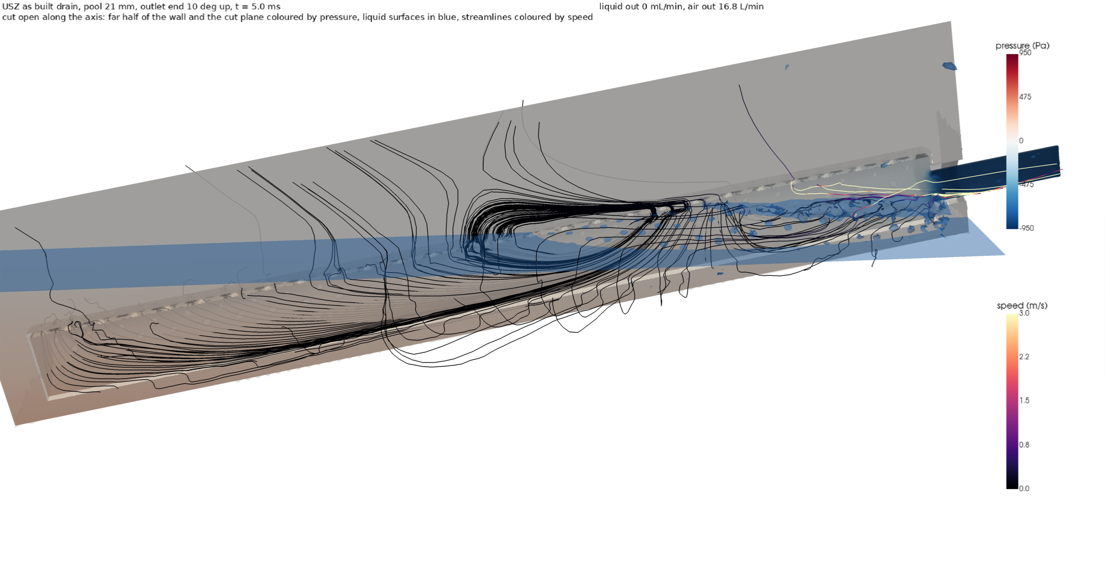
drainstop/vof/kratos/results/usz_tilt10_h21_coarse/cut3d_005.0ms.png
