IasonKa/drain/drainstop/vof/kratos/results/usz_tilt10_h21_coarse/openings.png

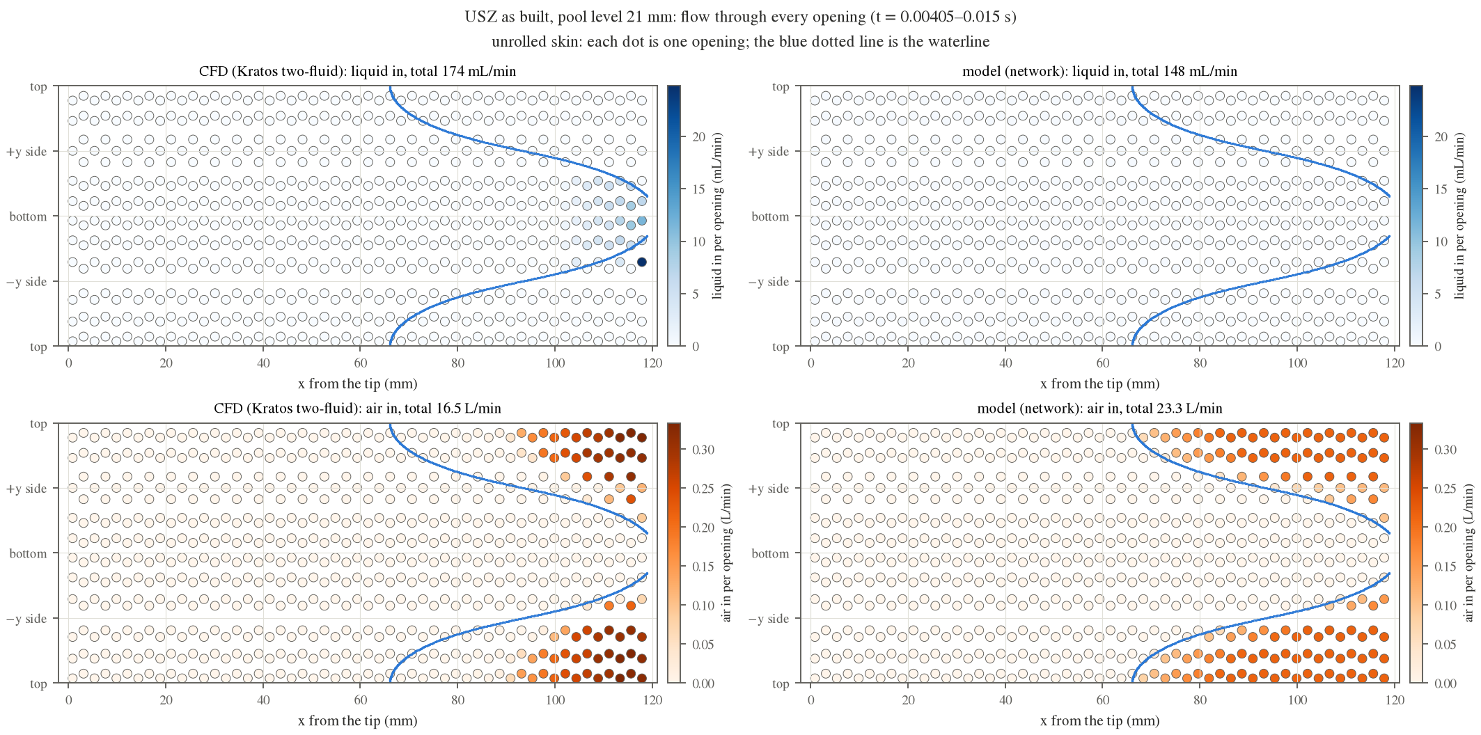
drainstop/vof/kratos/results/usz_tilt10_h21_coarse/openings.png
