IasonKa/drain/drainstop/vof/kratos/results/usz_tilt10_h21_coarse/outlet_end.png

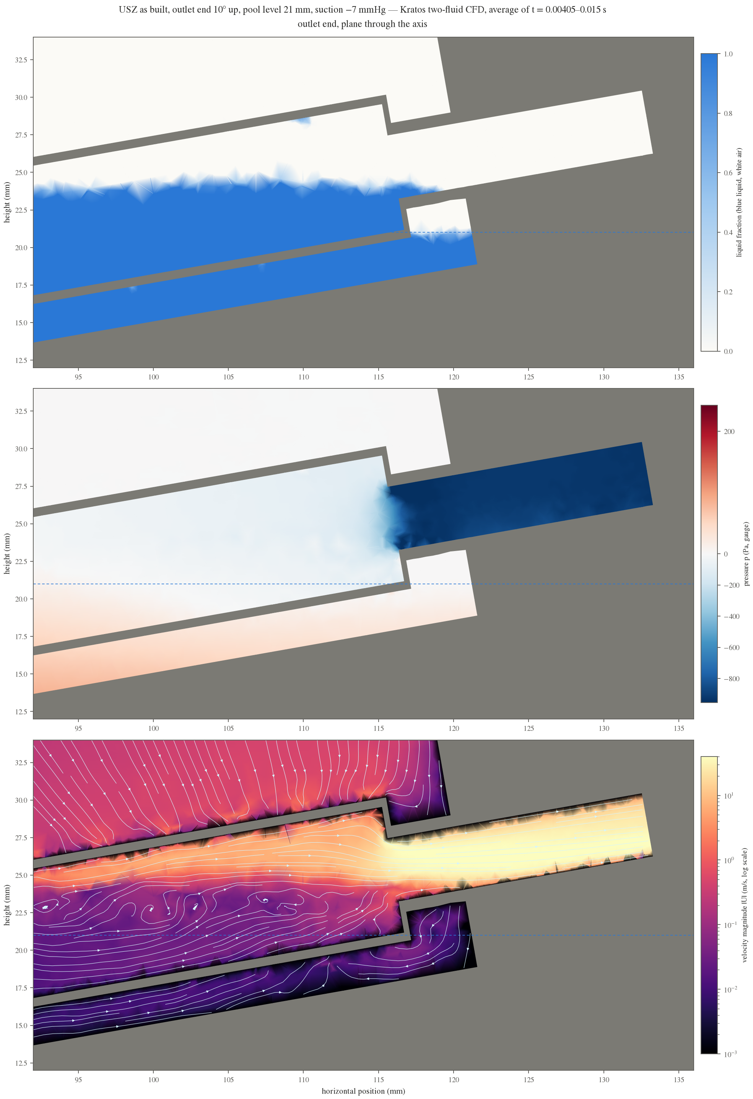
drainstop/vof/kratos/results/usz_tilt10_h21_coarse/outlet_end.png
