IasonKa/drain/drainstop/vof/kratos/results/usz_tilt10_h21_coarse/sections.png

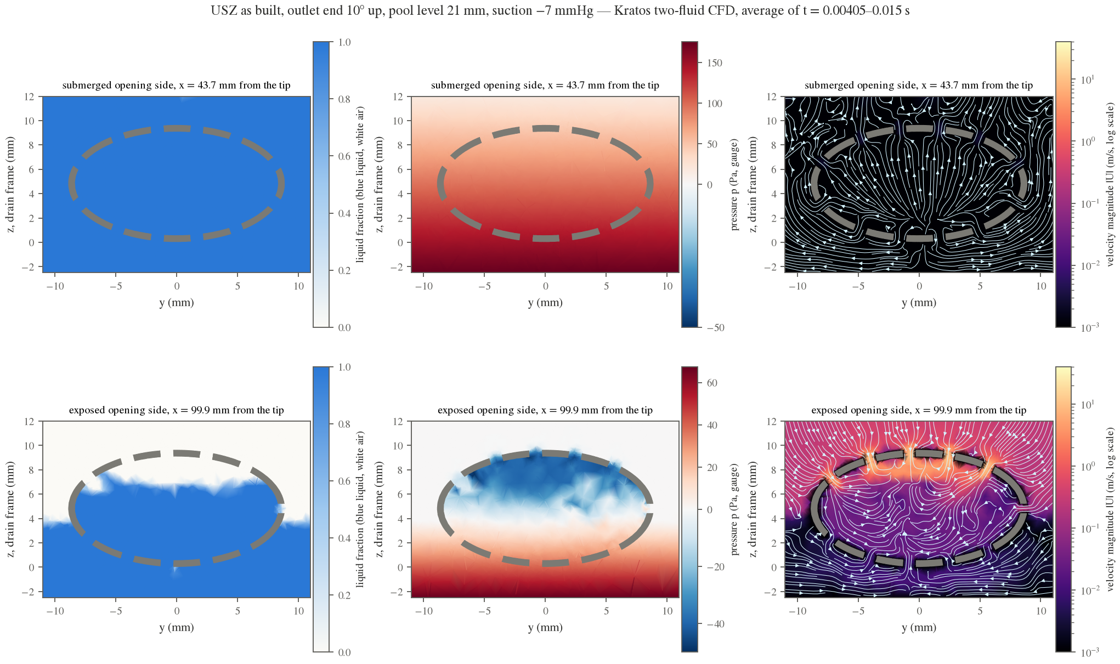
drainstop/vof/kratos/results/usz_tilt10_h21_coarse/sections.png
