IasonKa/drain/drainstop/vof/kratos/results/usz_tilt10_h21_coarse/view3d.png

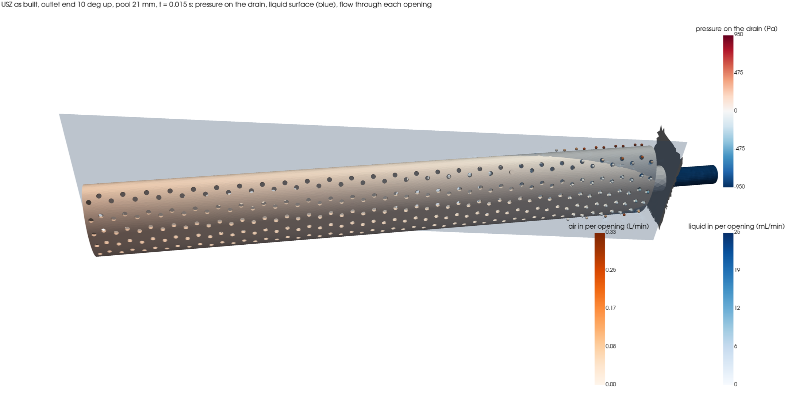
drainstop/vof/kratos/results/usz_tilt10_h21_coarse/view3d.png
