IasonKa/drain/drainstop/paper/figures/fig02_mechanism.pdf

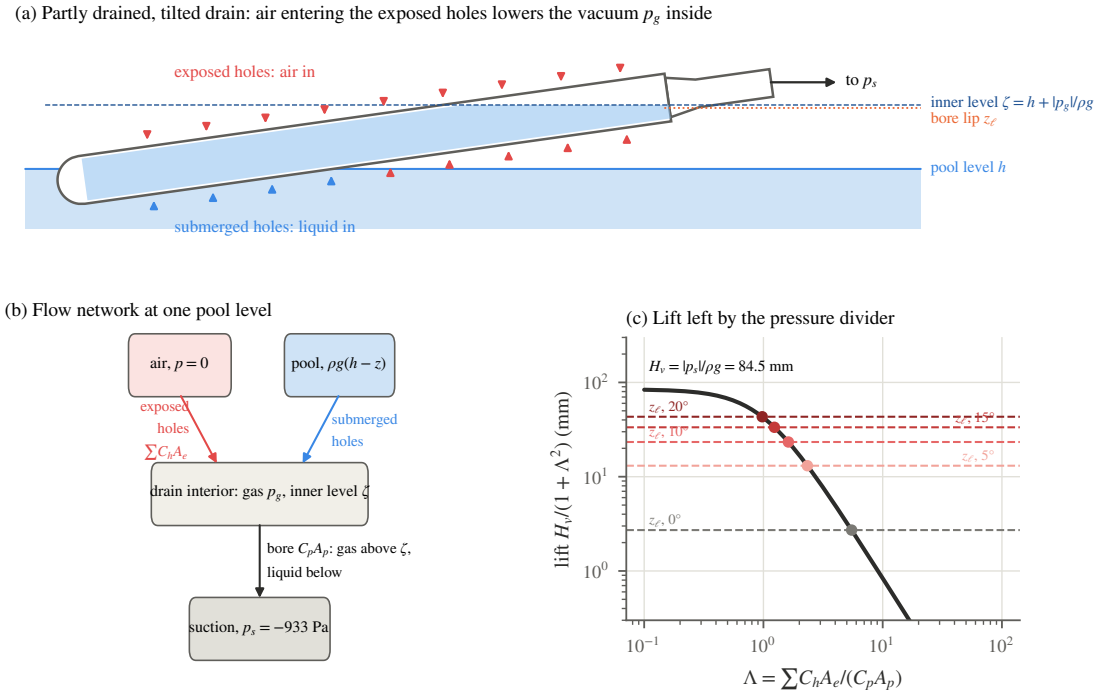
[picture p110: page 1]
pool level h; air, p = 0; pool, ρg(h − z); submerged holes; Λ = ∑ChAe/(CpAp); lift Hv/(1 +

(a) Partly drained, tilted drain: air entering the exposed holes lowers the vacuum pg inside

exposed holes: air in

inner level ζ = h + |pg|/ρg
bore lip zℓ

submerged holes: liquid in

(b) Flow network at one pool level

(c) Lift left by the pressure divider

exposed
holes
∑ChAe
drain interior: gas pg, inner level ζ

zℓ, 20° | zℓ, 15°
zℓ, 10°

bore CpAp: gas above ζ,
liquid below

suction, ps = −933 Pa
