IasonKa/drain/drainstop/paper/figures/fig06_design_chart.pdf

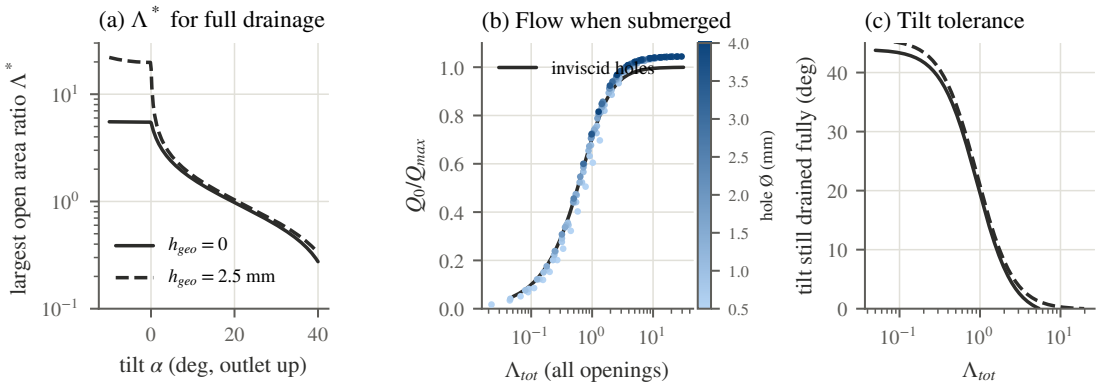
[picture p111: page 1]
Q0/Qmax; (b) Flow when submerged; inviscid holes; (c) Tilt tolerance; hole Ø (mm)

largest open area ratio Λ *

tilt still drained fully (deg)
