IasonKa/drain/drainstop/paper/figures/fig07_drainage_curves.pdf

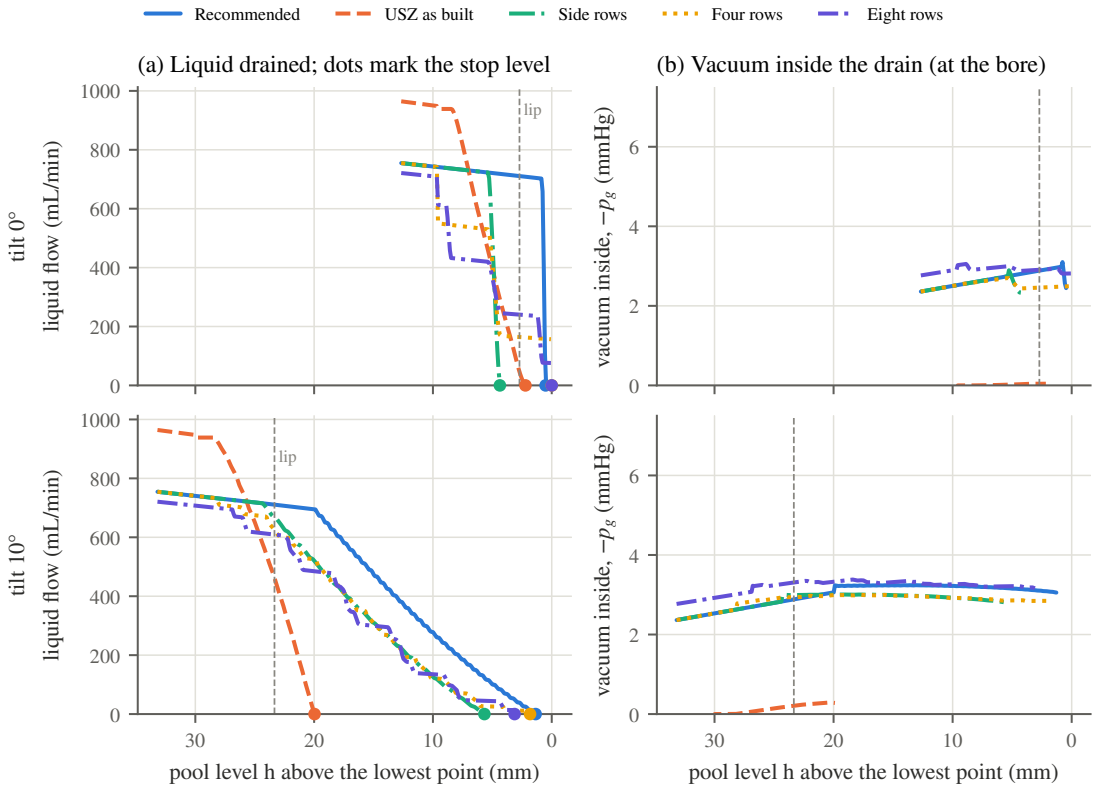
[picture p112: page 1]
tilt 0°; lip; tilt 10°; Recommended; USZ as built; Side rows; Four rows; Eight rows

(a) Liquid drained; dots mark the stop level

(b) Vacuum inside the drain (at the bore)

liquid flow (mL/min)

vacuum inside, −pg (m

pool level h above the lowest point (mm)
