IasonKa/drain/drainstop/paper/figures/fig08_hstop_vs_d_count.pdf

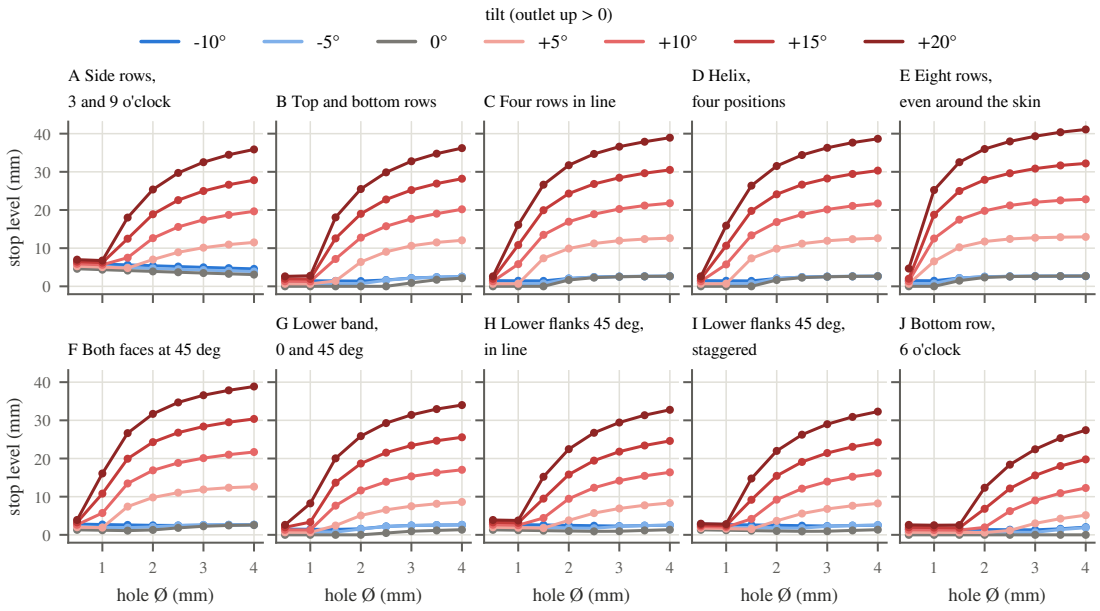
[picture p113: page 1]
A Side rows,; 3 and 9 o'clock; B Top and bottom rows; C Four rows in line; D Helix, four positions; hole Ø (mm); F Both faces at 45 deg; G Lower band, 0 and 45 deg; J Bottom row, 6 o'clock

tilt (outlet up > 0)

E Eight rows,
even around the skin

stop level (mm)

H Lower flanks 45 deg,
in line

I Lower flanks 45 deg,
staggered
