IasonKa/drain/drainstop/paper/figures/fig12_optimize.pdf

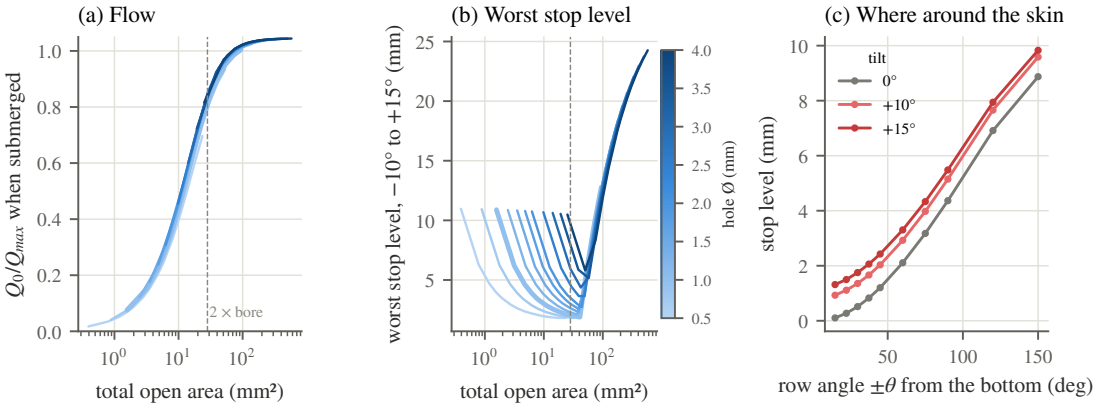
[picture p114: page 1]
2 × bore; (a) Flow; tilt 0° +10° +15°; hole Ø (mm)

(b) Worst stop level

(c) Where around the skin

worst stop level, −10° to +15° (mm)

Q0/Qmax when submerged

stop level (mm)

total open area (mm²)
