IasonKa/drain/drainstop/paper/figures/fig16_tiltlimit.pdf

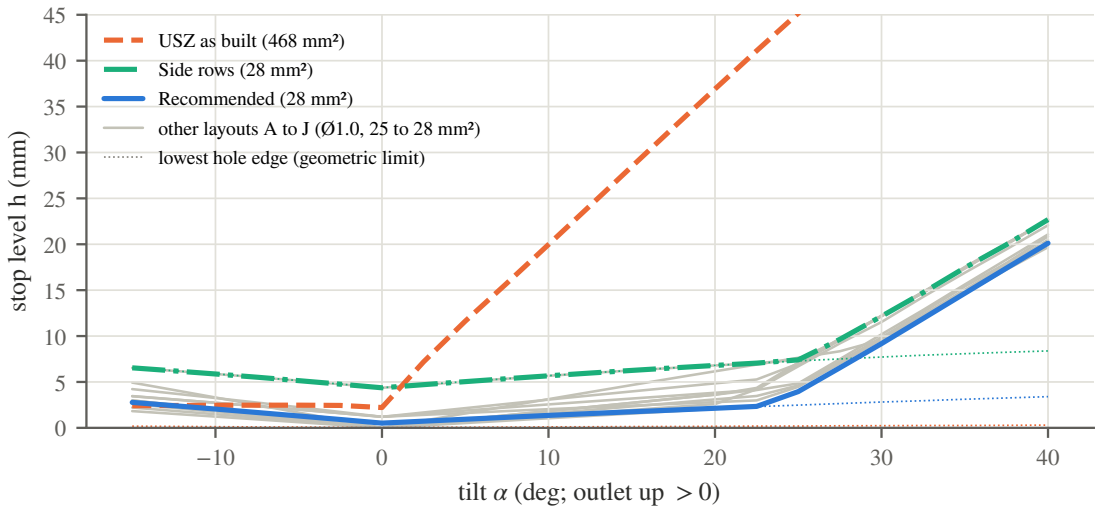
[picture p115: page 1]
40 tilt α (deg; outlet up > 0)

USZ as built (468 mm²)
Side rows (28 mm²)
Recommended (28 mm²)
other layouts A to J (Ø1.0, 25 to 28 mm²)
lowest hole edge (geometric limit)

stop level h (mm)
