IasonKa/drain/drainstop/paper/figures/fig17_pump.pdf

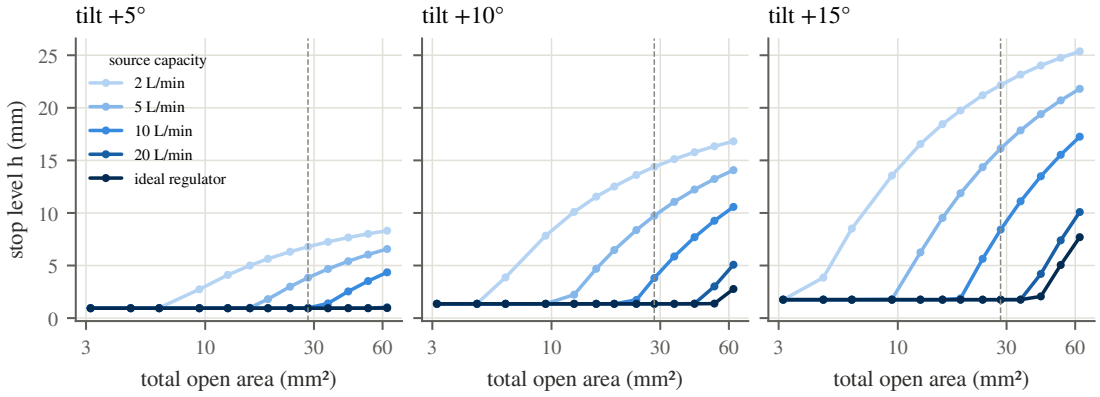
[picture p116: page 1]
total open area (mm²); tilt +5°; source capacity 2 L/min 5 L/min 10 L/min 20 L/min ideal regulator; tilt +10°; tilt +15°

stop level h (mm)

total open area (mm²)
