IasonKa/drain/drainstop/paper/figures/fig13_transient.pdf

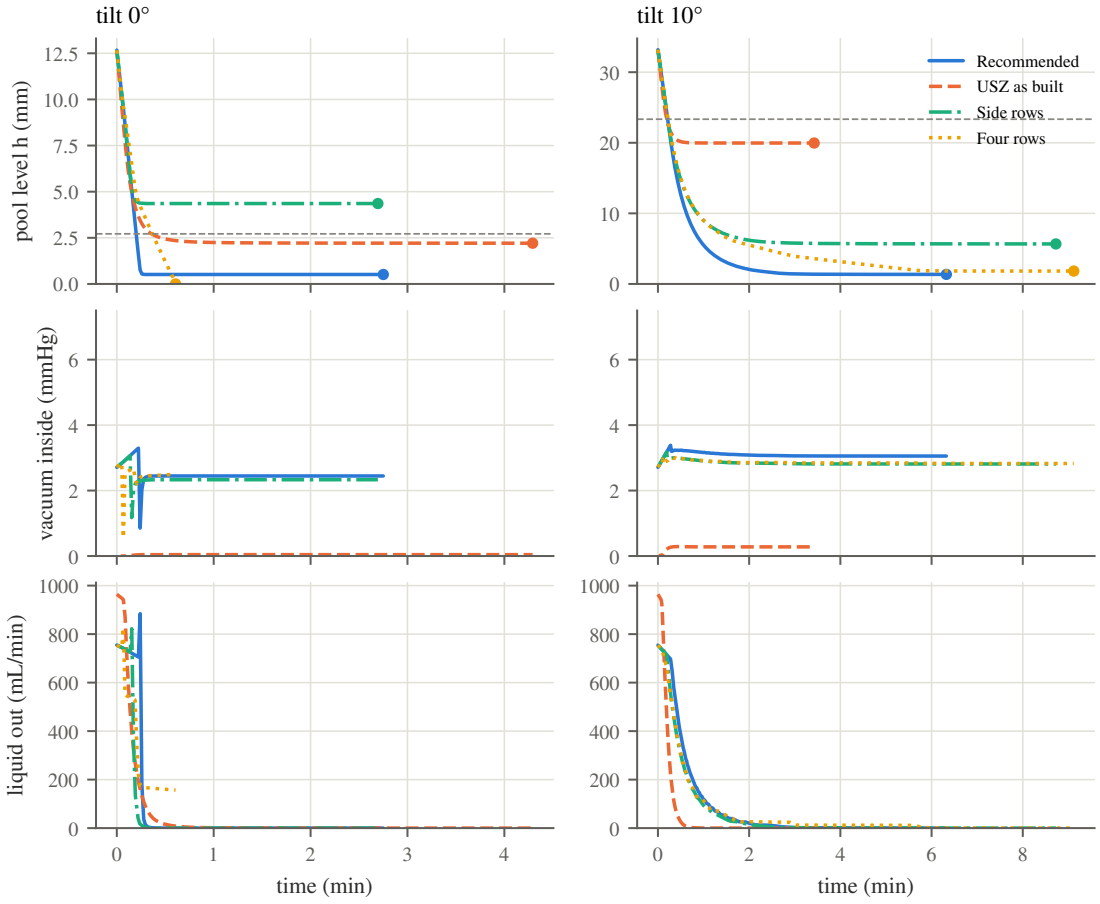
[picture p117: page 1]
tilt 0°; tilt 10°; time (min)

Recommended
USZ as built
Side rows
Four rows

pool level h (mm)

vacuum inside (mmHg)

liquid out (mL/min)
