IasonKa/drain/drainstop/paper/figures/fig15_montecarlo.pdf

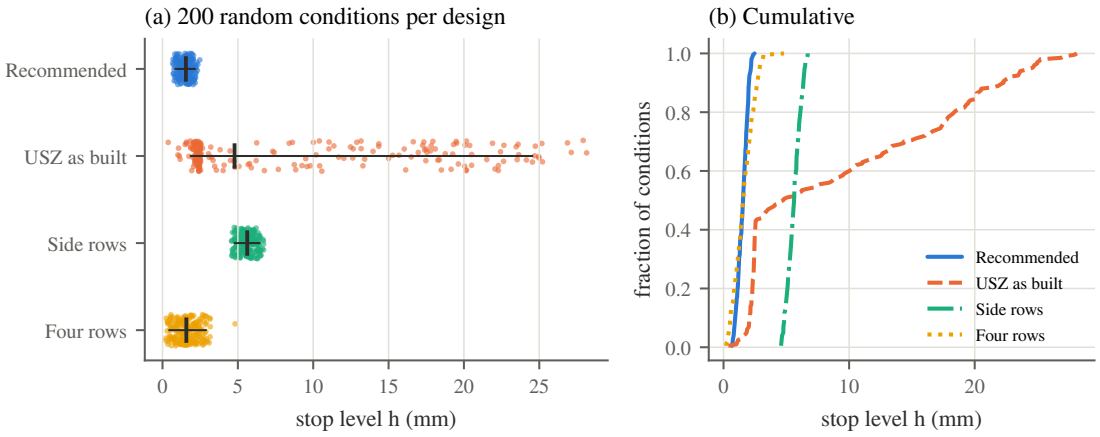
[picture p118: page 1]
Recommended; Side rows; Four rows; (b) Cumulative

(a) 200 random conditions per design

fraction of conditions

USZ as built

Recommended
Side rows
Four rows

stop level h (mm)
