IasonKa/drain/(commit log)

2026-10-12 traffic flow
2026-10-14 sponge: biphasic tissue on one drain hole (OpenFOAM + FEBio package)
    [organ_sponge_global.step, organ_sponge_global.stl, window_assembly.step, window_channel.step, window_channel.stl, window_drain.step, window_drain.stl, window_film.step]
2026-10-14 Add visualization folder and standoff-ring design study
    visualization/: all pictures, videos and the interactive viewer of the
    sponge-tissue study (drain CAD with the organ, design comparison
    animations, 3D tissue animations, ring screening), with index.html and
    README.md describing each file.
    drainsponge/: standoff ring design (from new_offset_desing.zip) and an
    optimized ring as design options in mesh, CAD, OpenFOAM, FEBio and the
    preview model; open/closed (no free liquid) scenarios; orifice loss at
    the hole; ring screening; resumable OpenFOAM-FEBio coupling with FEBio
    restart chaining; ETH Euler Slurm workflow (hpc/); updated README.
    Large regenerable outputs are git-ignored.
    Co-Author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
    [organ_sponge_global.step, organ_sponge_global.stl, window_assembly.step, window_channel.step, window_channel.stl, window_drain.step, window_drain.stl, window_film.step]
2026-11-03 drainstop: when the suction drain stops draining, and the hole layout that drains longest
    drainstop/ studies the USZ-scale drain lying in a glycerol-water pool at
    -7 mmHg: at what pool level it stops removing liquid, for a given hole
    layout, size and tilt, and which layout keeps it draining longest.
    - paper/drain_stop.pdf: 18-page paper with the derivation, drawings of
    the drain and of every layout tested, graphs, validation and the
    recommended design (2 staggered rows at +-30 deg, 36 x 1.0 mm, for a
    wall regulator passing >= 18 L/min of air at -7 mmHg).
    - drainstop/: closed-form stop condition, quasi-static two-phase network
    simulation and an independent time-dependent simulation.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
2026-11-03 drainstop/vof: 3D OpenFOAM check of two stop levels, ready for ETH Euler
    Two interFoam (VOF) cases with the outlet 10 deg up: the as-built USZ
    field (model stop 20.0 mm) and the recommended layout (1.4 mm).
    - make_cases.py builds the drain surfaces and both case templates from
    the model geometry. The STL files (about 20 MB) are git-ignored and
    rebuilt by the script or by the job scripts.
    - hpc/: Euler environment, test job, production job with automatic stop
    detection (watch_run.py) and 24 h job chaining, archive script.
    - analyse_run.py compares a run's stop level and gas pressure with the
    model.
    - README: what is modelled and why, how to run and read the results.
    - Shell and OpenF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
2026-11-03 drainstop: pictures and animation of the drain emptying
    scripts/make_pictures.py draws the state of the two-phase network
    simulation while the pool empties, outlet end 10 deg up, as-built USZ
    field next to the recommended layout:
    - side view cut through the axis: pool, drain wall, liquid and air
    inside the drain and the outlet tube;
    - 3D view from below;
    - each opening coloured by what flows through it (liquid in, air in,
    nothing);
    - pool level against time.
    pictures/ holds four stills and a GIF of the whole drainage. The USZ
    part stops at 20 mm with about 28 L/min of air through its exposed
    openings; the recommended part drains to its lowest openings at 1.4 mm.
    These are model states,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
2026-11-03 drainstop: 3D CFD runnable on a Linux laptop; paper updated
    vof/local/ runs fixed-level OpenFOAM interFoam snapshots of the two
    cases (recommended layout at 8 mm, USZ as built at 21 mm, outlet 10 deg
    up) on an ordinary machine instead of Euler:
    - make_local_case.py adapts a vof/cases template: lighter mesh
    (0.2 mm at every opening rim and the bore, 0.35 M / 0.67 M cells),
    pool at h and drain interior at the model's inner level, 0.12 s run,
    ASCII fields every 0.01 s, sampled planes and the drain surface;
    - Allrun.local meshes and runs it on Linux (mpirun) or Windows (MS-MPI);
    - render_cfd.py makes liquid/air, pressure and velocity heatmaps with
    streamlines, cross-sections, a 3D view (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
2026-11-04 drainstop/vof/kratos: 3D two-phase CFD with Kratos, one-click on Windows
    Runs the fixed-level CFD check (recommended layout at 8 mm, USZ as built
    at 21 mm, outlet 10 deg up) with Kratos Multiphysics on a Windows PC or
    workstation, without Linux, MPI or a compiler:
    - SETUP.bat / setup_windows.ps1: installs the Visual C++ runtime (one
    admin prompt, only if missing), Python 3.12 for the user and a venv
    with pinned Kratos, gmsh, pyvista (requirements-windows.txt), then
    checks that Kratos loads;
    - RUN.bat / run_all.ps1: meshes, runs on all physical cores and makes
    the pictures into results/<case>/; options for cases, threads, finer
    USZ mesh, rerun;
    - make_case.py: gmsh/OpenCASCADE geome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
2026-11-04 drainstop/vof/kratos: continue a stopped run from its last snapshot
    run_case.py --resume continues from the last field output (every 5 ms
    of flow): the outputs so far are moved to vtk_saved/ first (Kratos'
    VTK output process deletes vtk_output/ when a run starts), the latest
    velocity, pressure and level set are loaded onto the same mesh, the run
    restarts at that time and monitor.csv is cut there and continued.
    RUN.bat now resumes by default (-Force starts from zero), so a reboot
    or a closed window costs at most about 5 ms of flow; render_kratos.py
    reads vtk_saved/ and vtk_output/. Tested: resume, snapshot kept, log
    continuous.
2026-11-05 drainstop/vof/kratos: slow captioned animations
    make_gifs.py renders the mid-plane and the outlet-end close-up for every
    field output (every 5 ms of flow) with the time and the measured liquid
    and air outflow and bore pressure in the title, and writes GIFs at 1.5 s
    per frame with the last frame held. RUN.bat now makes them too.
2026-11-05 drainstop/vof/kratos: 3D cut-away pictures and animation
    render_3d.py draws each field output in 3D, in the world frame, with the
    drain cut open along its axis: far half of the wall and the axial cut
    plane coloured by pressure, liquid-air interfaces (pool surface, inner
    level, bubbles) and streamlines coloured by speed; --all also writes a
    slow GIF. RUN.bat makes them too.
2026-11-05 Add Kratos CFD results: USZ and recommended-layout runs, GIFs, graphs, paper Section 8
    USZ as built at 21 mm (15 ms valid, diverged at 16.4 ms): mainly air out, little
    liquid, the near-stop state the model predicts. Recommended layout at 8 mm (50 ms):
    still in start-up (primed, siphoning its initial liquid), not comparable with the model.
    [monitor.csv, monitor_until_divergence.csv]
2026-11-09 visualization/in_body: the drain inside the body with irrigation
    Set-up schematic (patient, irrigation bag and pump, drain, canister,
    wall regulator at -7 mmHg) with a cut across the drain among the bowel
    and a close-up of one ringed hole, plus a 3D view of the real standoff
    drain CAD under bowel loops with the irrigation catheter tip ~15 mm above.
